HarrydeBug/WSPR-transmitters/Custom Firmwares/WSPR-TX0.79AltitudeCodingPico/2019-08-05 14.38.08.jpg

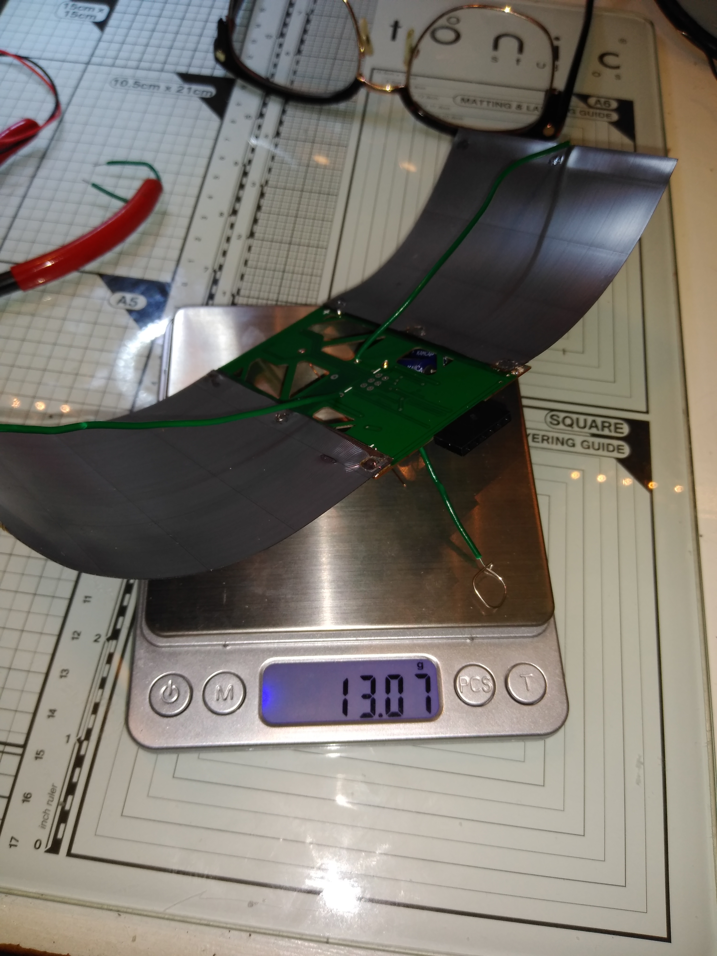
Custom Firmwares/WSPR-TX0.79AltitudeCodingPico/2019-08-05 14.38.08.jpg
