HarrydeBug/WSPR-transmitters/Custom Firmwares/WSPR-TX0.79AltitudeCodingPico/2019-08-10 16.04.37.jpg

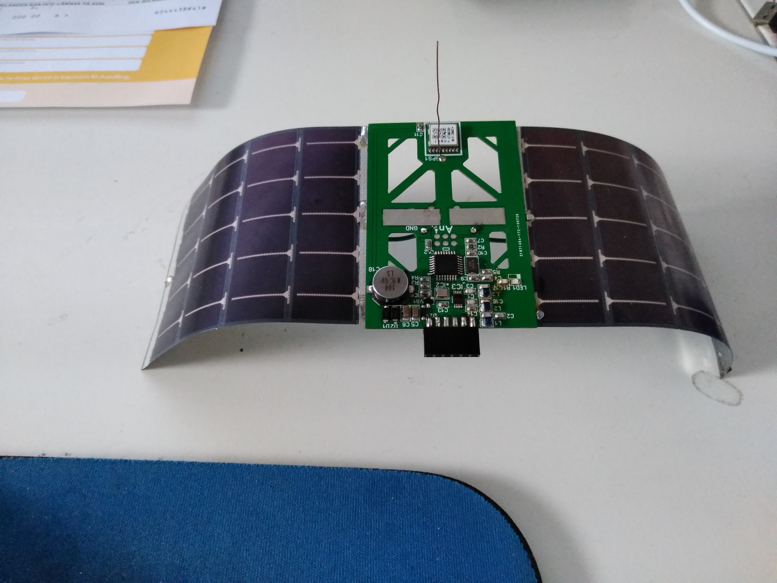
Custom Firmwares/WSPR-TX0.79AltitudeCodingPico/2019-08-10 16.04.37.jpg
