HarrydeBug/WSPR-transmitters/README.md

Arduino firmware, documentation and PC executable for my WSPR transmitters.
More info at www.zachtek.com

Firmware version 1:xx for WSPR transmitters with hardware version 1. These are ATMega328 based.   
Firmware version 2:xx for WSPR transmitters with hardware version 2. These are ESP8285 based.
