HarrydeBug/WSPR-transmitters/(threads)

Thread 4 (2023-12-21):

Version 1.15 ( ATMega 328) too big for uploading

GregorKocar, 2023-12-21:
I get this error when compiling 1.15 version for Arduino Pro Mini ATMega 328

Sketch uses 30144 bytes (210%) of program storage space. Maximum is 14336 bytes.
Global variables use 1211 bytes (118%) of dynamic memory, leaving -187 bytes for local variables. Maximum is 1024 bytes.

NeoGPS version 4.2.9

Closed 2023-12-21.
