HarrydeBug/WSPR-transmitters/Documentation/1012 Schema/Hardware Version 2/1012 Schema V2R35_80To10.pdf

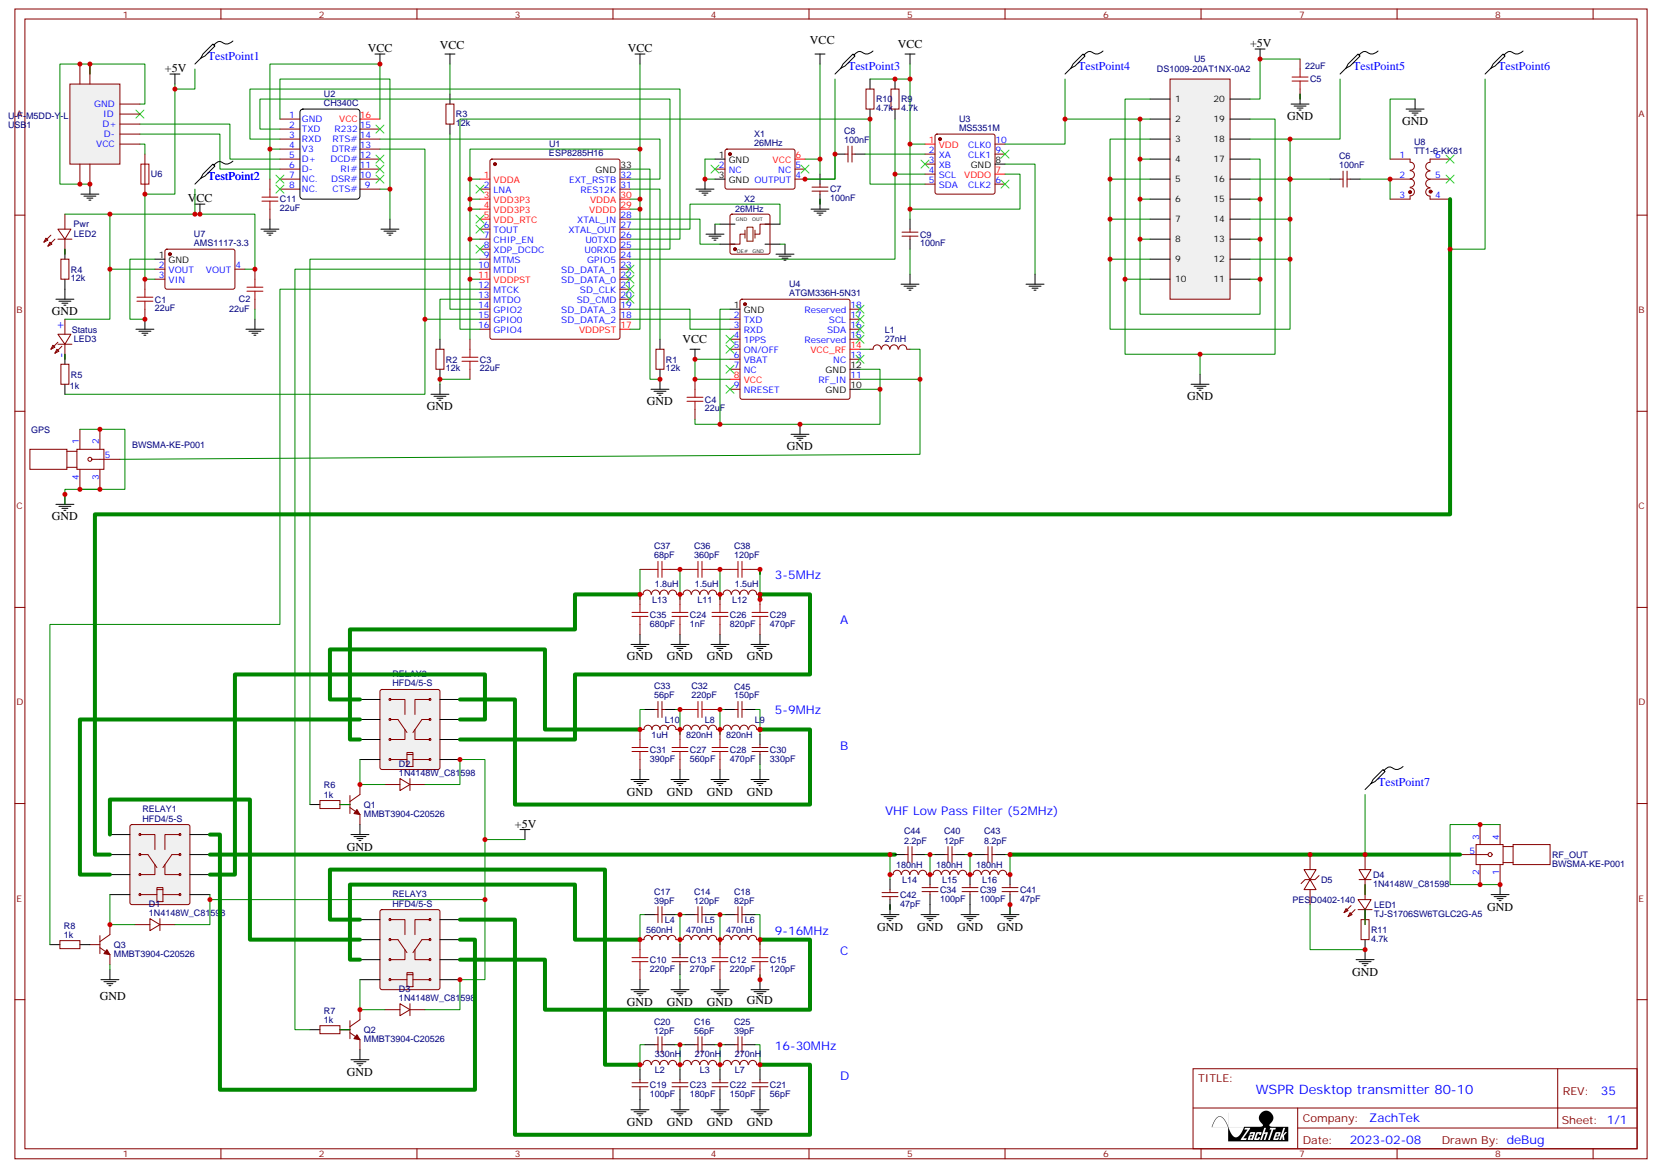
[picture p17: page 1]

GND GND

VHF Low Pass Filter (52MHz)
