HarrydeBug/WSPR-transmitters/Documentation/1012 Schema/Hardware Version 2/1012 Schema V2R38_2190To80.pdf

### VCC

VCC | VCC

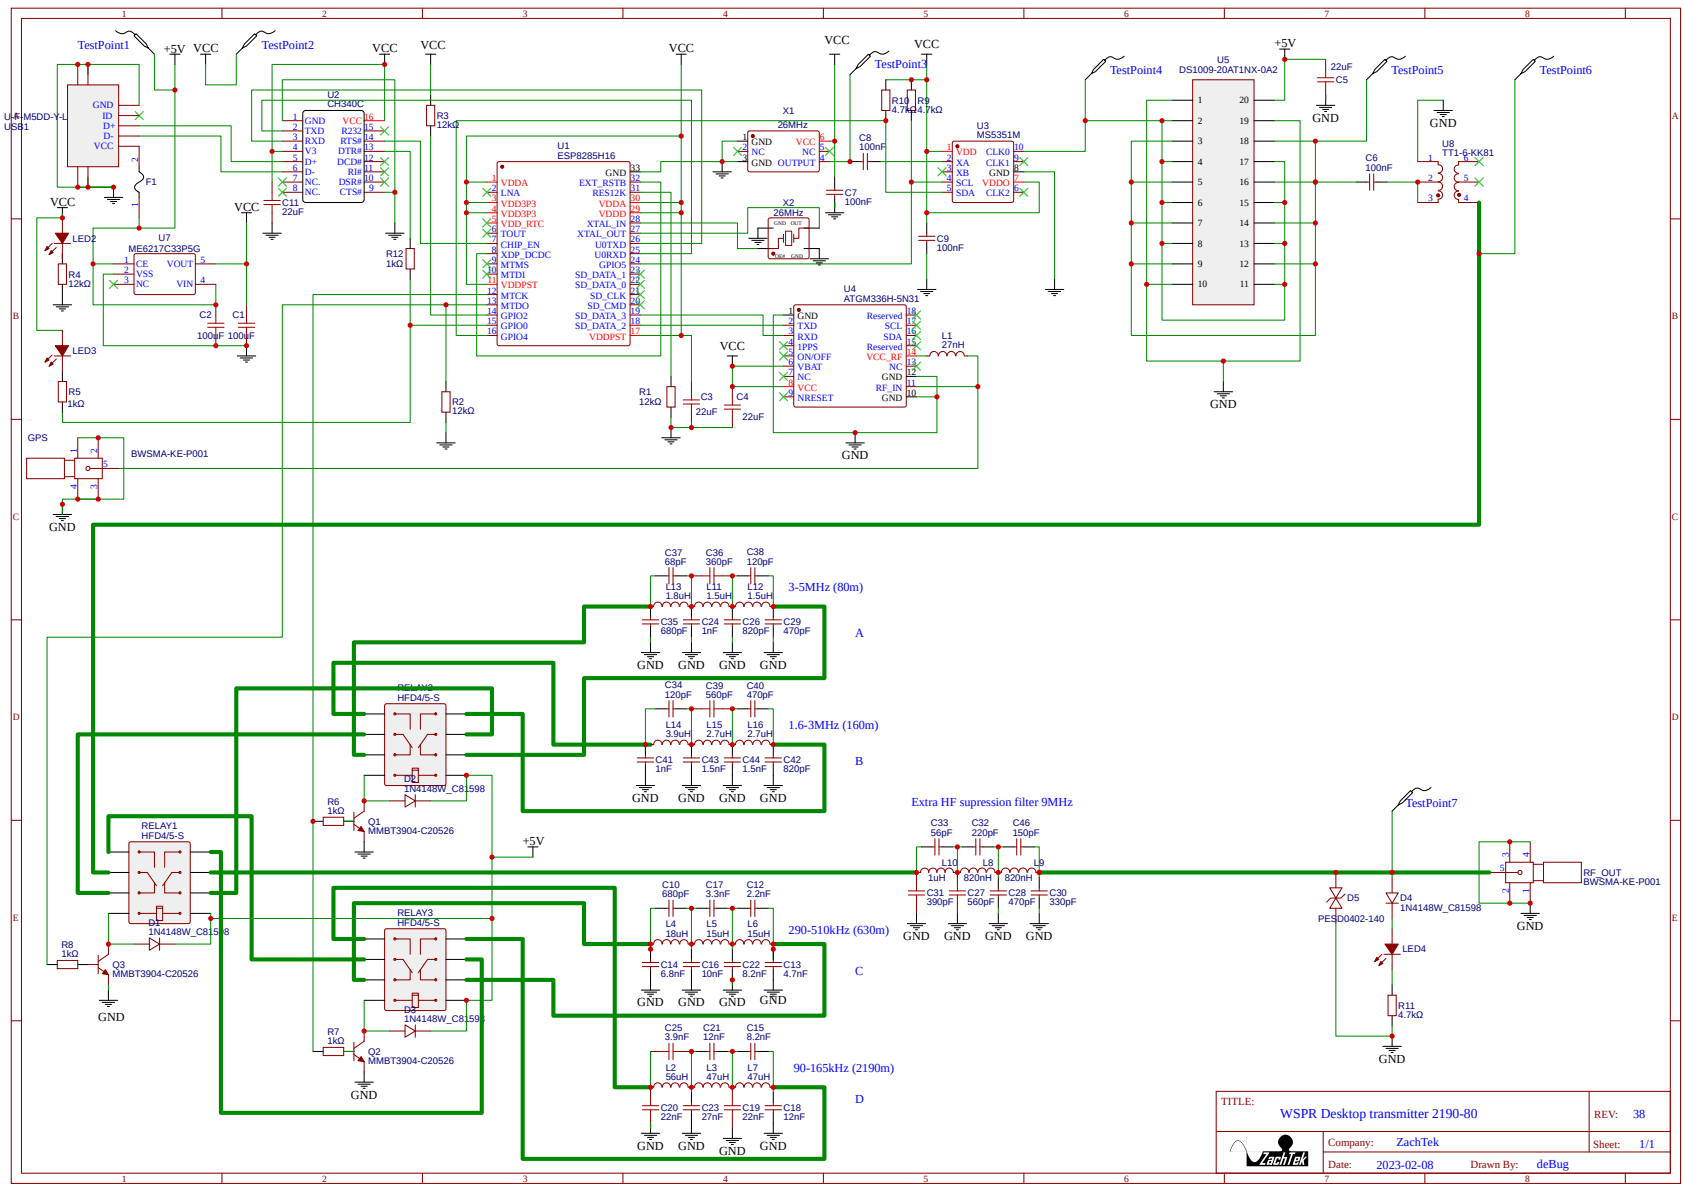
[picture p18: page 1]

GND GND

Extra HF supression filter 9MHz
