HarrydeBug/WSPR-transmitters/Documentation/1012 Schema/Hardware Version 2/1012 Schema V2R38_40To6.pdf

### VCC

VCC | VCC

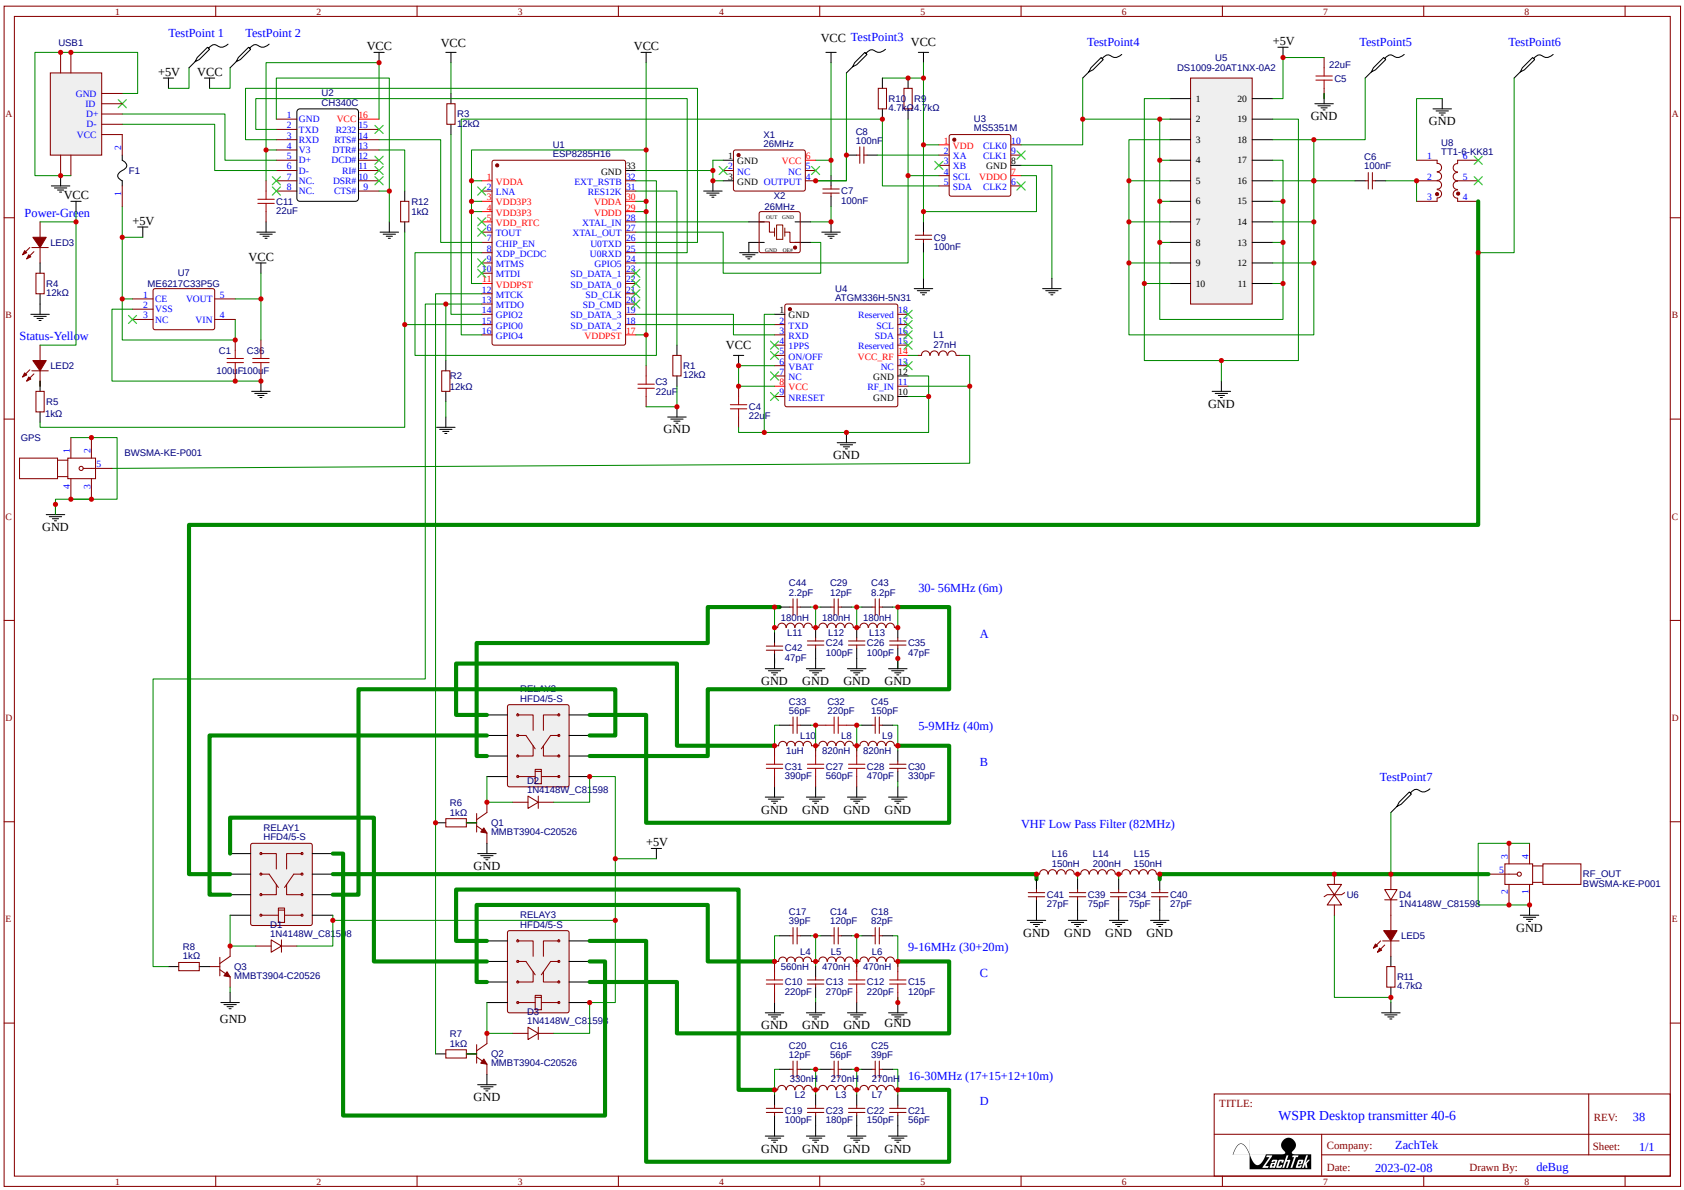
[picture p19: page 1]

GND GND

VHF Low Pass Filter (82MHz)
