HarrydeBug/WSPR-transmitters/Documentation/1011 Schema/1011 Schema V2R38.pdf

## Power-Green

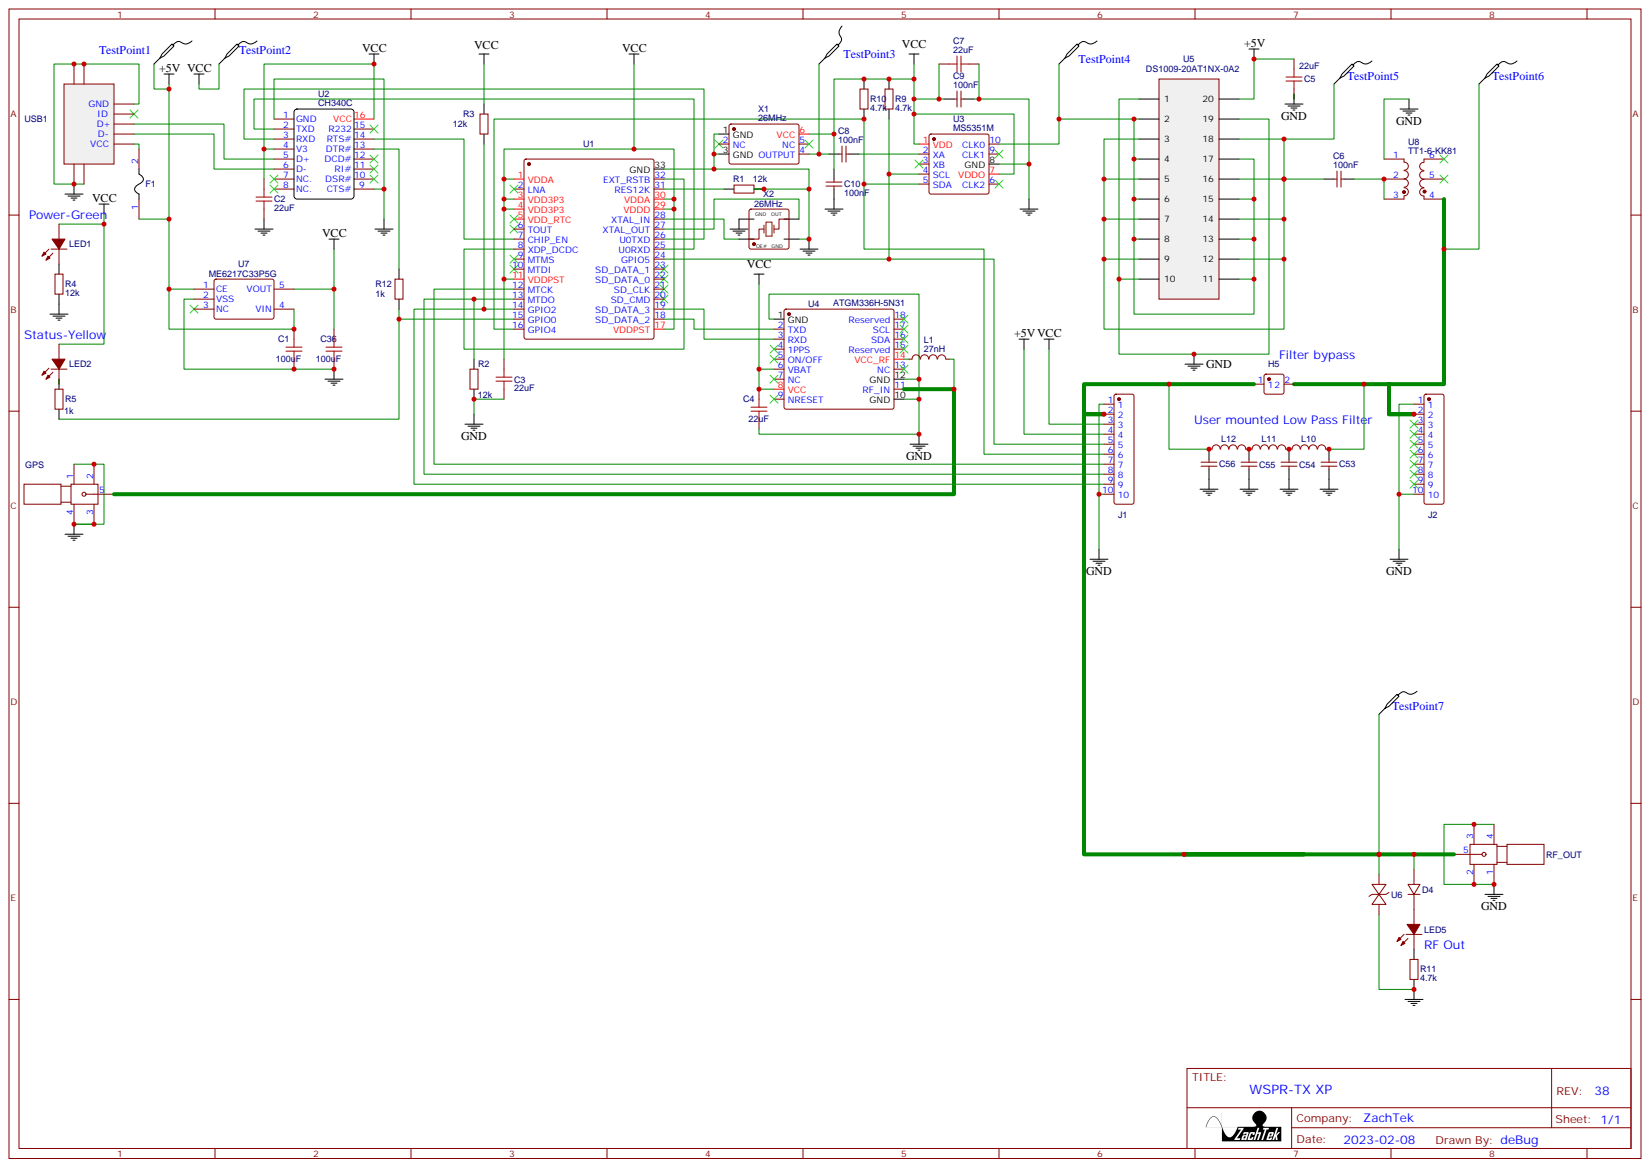
[picture p20: page 1]

User mounted Low Pass Filter
