HarrydeBug/WSPR-transmitters/Documentation/1010 Schema/1010 Schema V4R4 All bands.pdf

Tespoint1 5.0V | Testpoint2 3.3V | Testpoint3 Reference | Testpoint4 LOx4
6,94 | 72

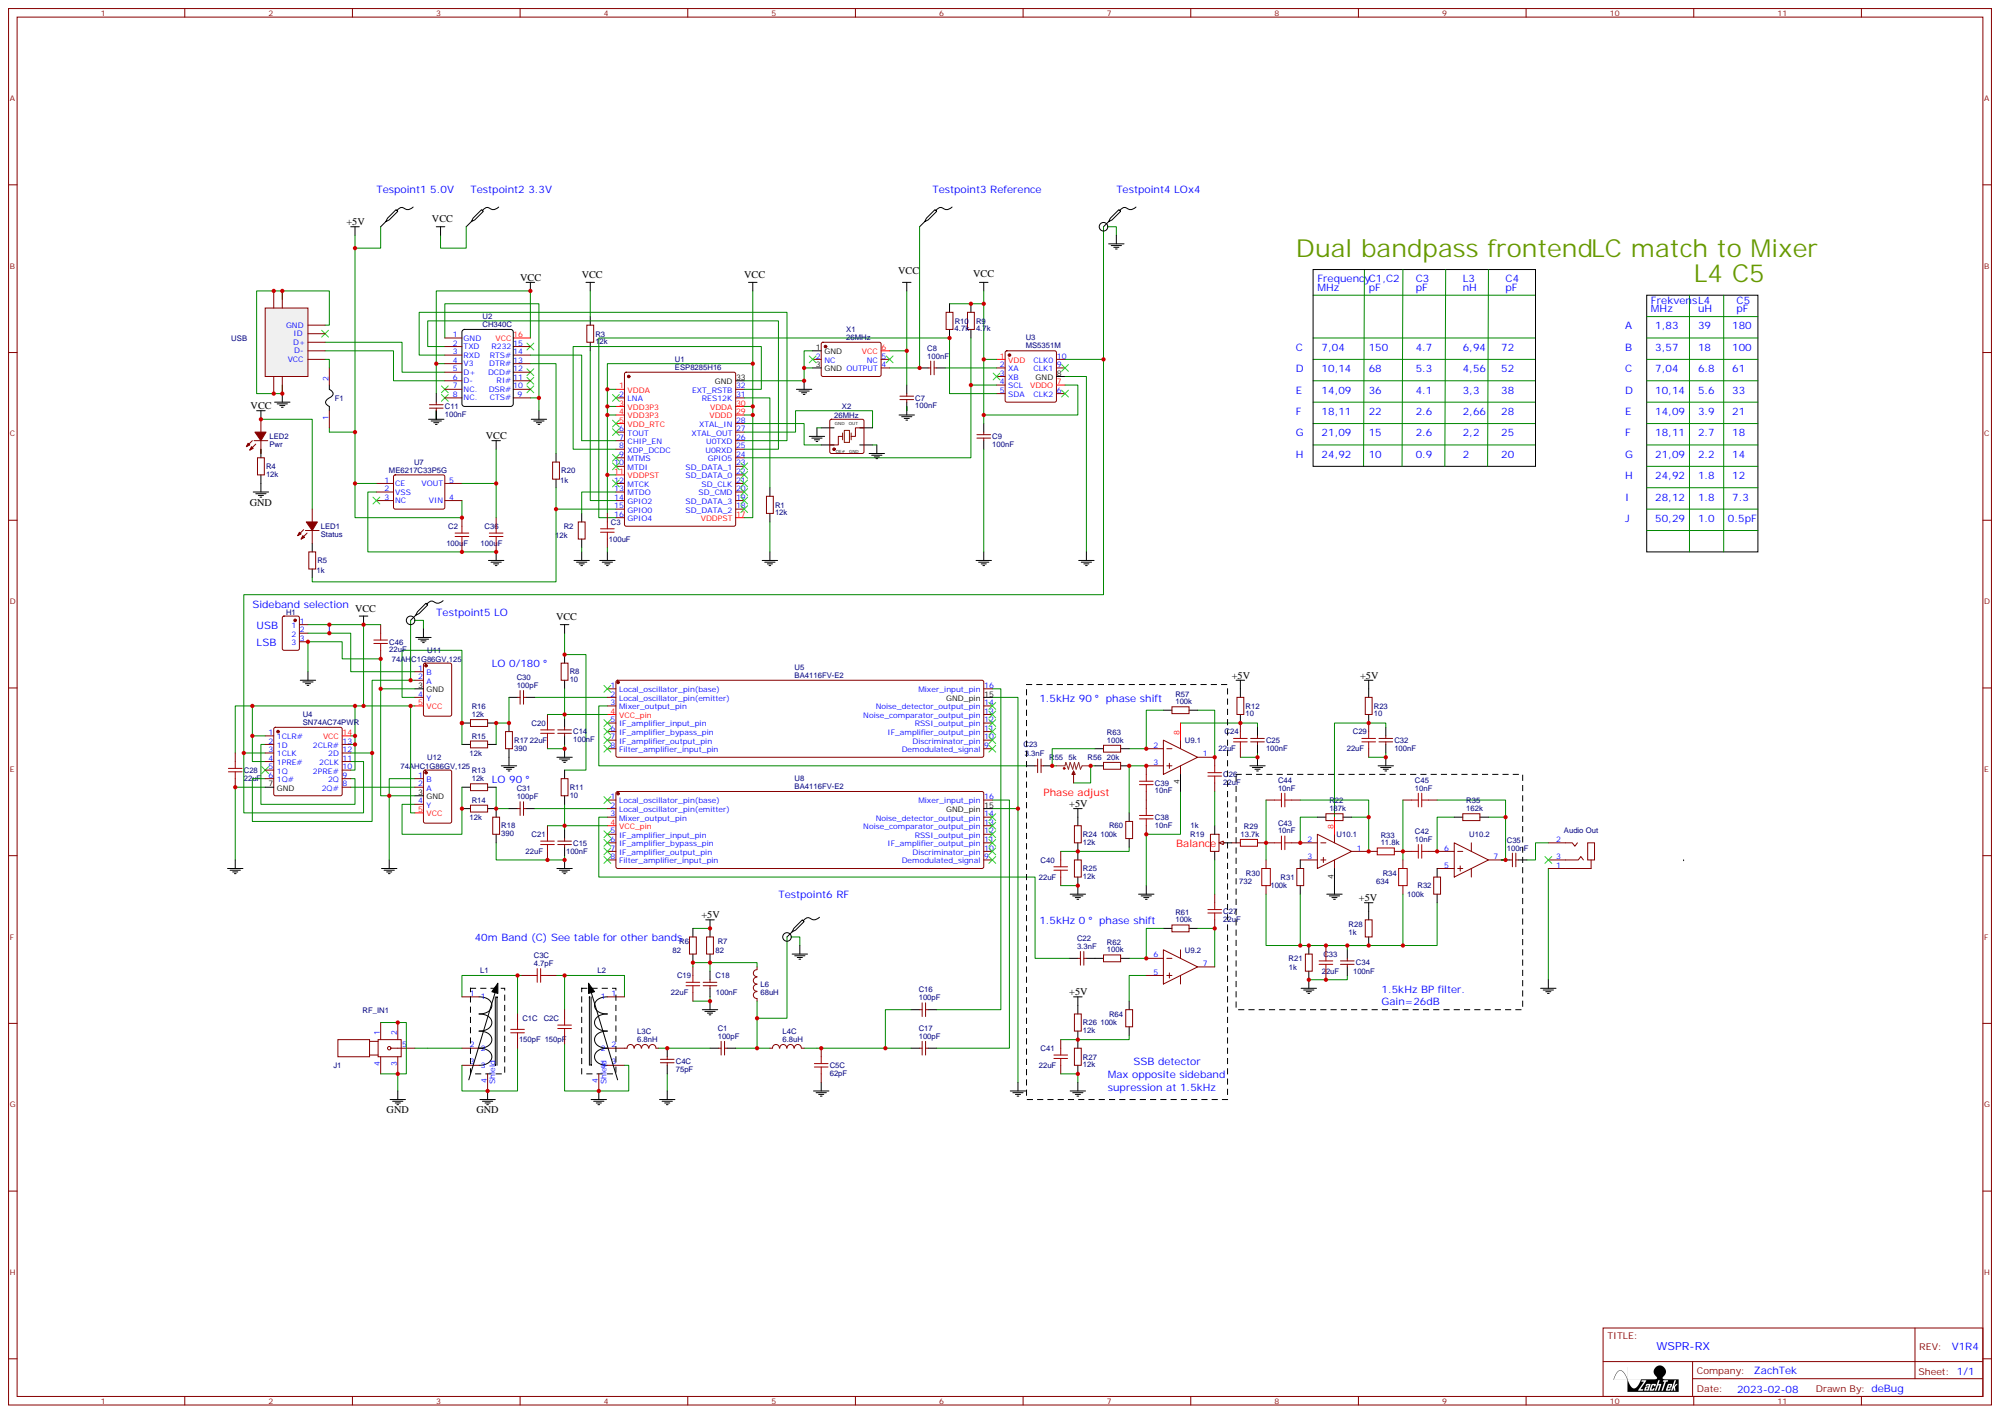
[picture p22: page 1]

LC match to Mixer

U2
GND 1 R3

40m Band (C) See table for other bands
