HarrydeBug/WSPR-transmitters/Documentation/1048 Schema/#1048 Schema V2R38.pdf

## Power-Green

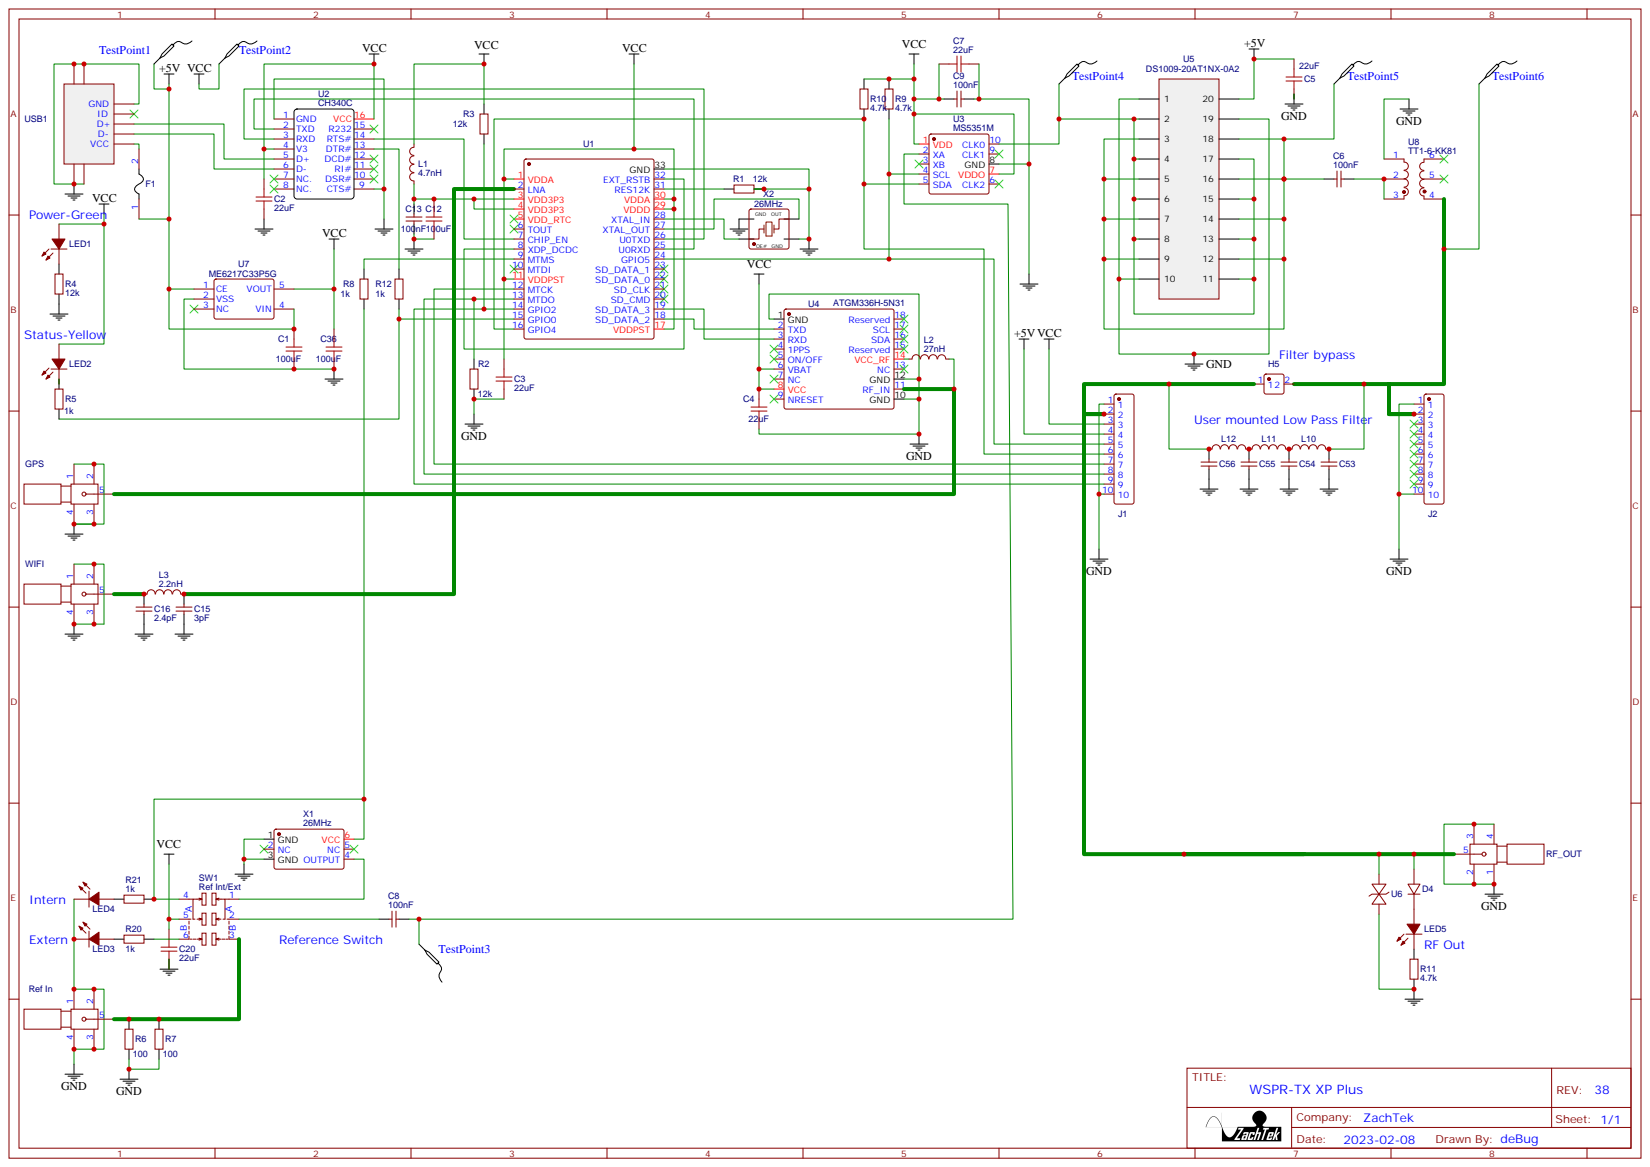
[picture p23: page 1]

User mounted Low Pass Filter
