HarrydeBug/WSPR-transmitters/Documentation/Serial API/1012 WSPR-TX_Desktop Serial API 0.65.pdf

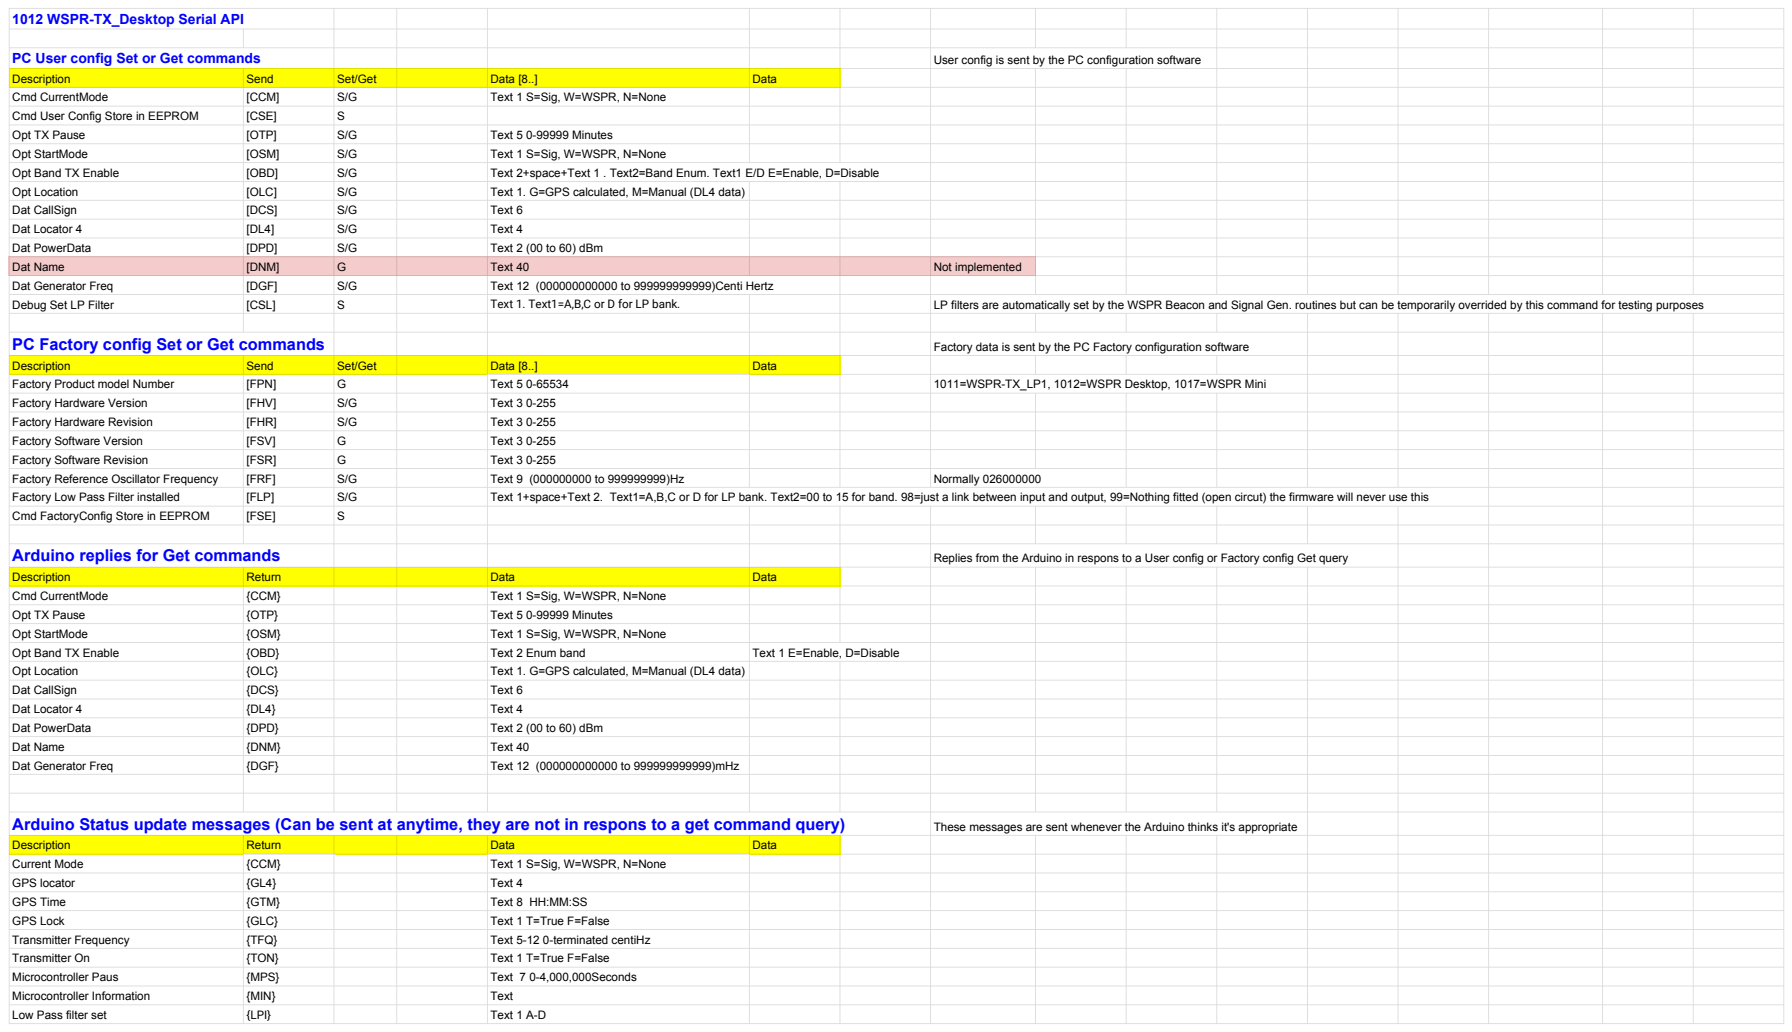
[picture p26: page 1]
Cmd CurrentMode; [CCM]; Text 1 S=Sig, W=WSPR, N=None; Cmd User Config Store in EEPROM; [CSE]; Opt TX Pause; [OTP]; Text 5 0-99999 Minutes; Opt StartMode; [OSM]; Opt Band TX Enable; [OBD]; Text 2+space+Text 1 . Text2=Band Enum. Text1 E/D E=Enable, D=Disable; Opt Location; [OLC]; Text 1. G=GPS calculated, M=Manual (DL4 data); Dat CallSign; [DCS]; Text 6; Dat Locator 4; Text 4; Dat PowerData; [DPD]; Text 2 (00 to 60) dBm; Dat Name; [DNM]; Text 40; Not implemented; Dat Generator Freq; [DGF]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

1012 WSPR-TX_Desktop Serial API PC User config Set or Get commands | User config is sent by the PC configuration software

Description Send Set/Get Data [8..] Data

Factory Product model Number [FPN] G Factory Hardware Version [FHV] S/G Factory Hardware Revision [FHR] S/G | Text 5 0-65534 Text 3 0-255 Text 3 0-255 | 1011=WSPR-TX_LP1, 1012=WSPR Desktop, 1017=WSPR Mini

Factory Software Version [FSV] G Factory Software Revision [FSR] G | | Text 3 0-255

Arduino replies for Get commands | Replies from the Arduino in respons to a User config or Factory config Get query

Description Return Data Data

Arduino Status update messages (Can be sent at anytime, they are not in respons to a get command query) | These messages are sent whenever the Arduino thinks it's appropriate
