HarrydeBug/WSPR-transmitters/Documentation/Serial API/1012 WSPR-TX_Desktop Serial API 0.82.pdf

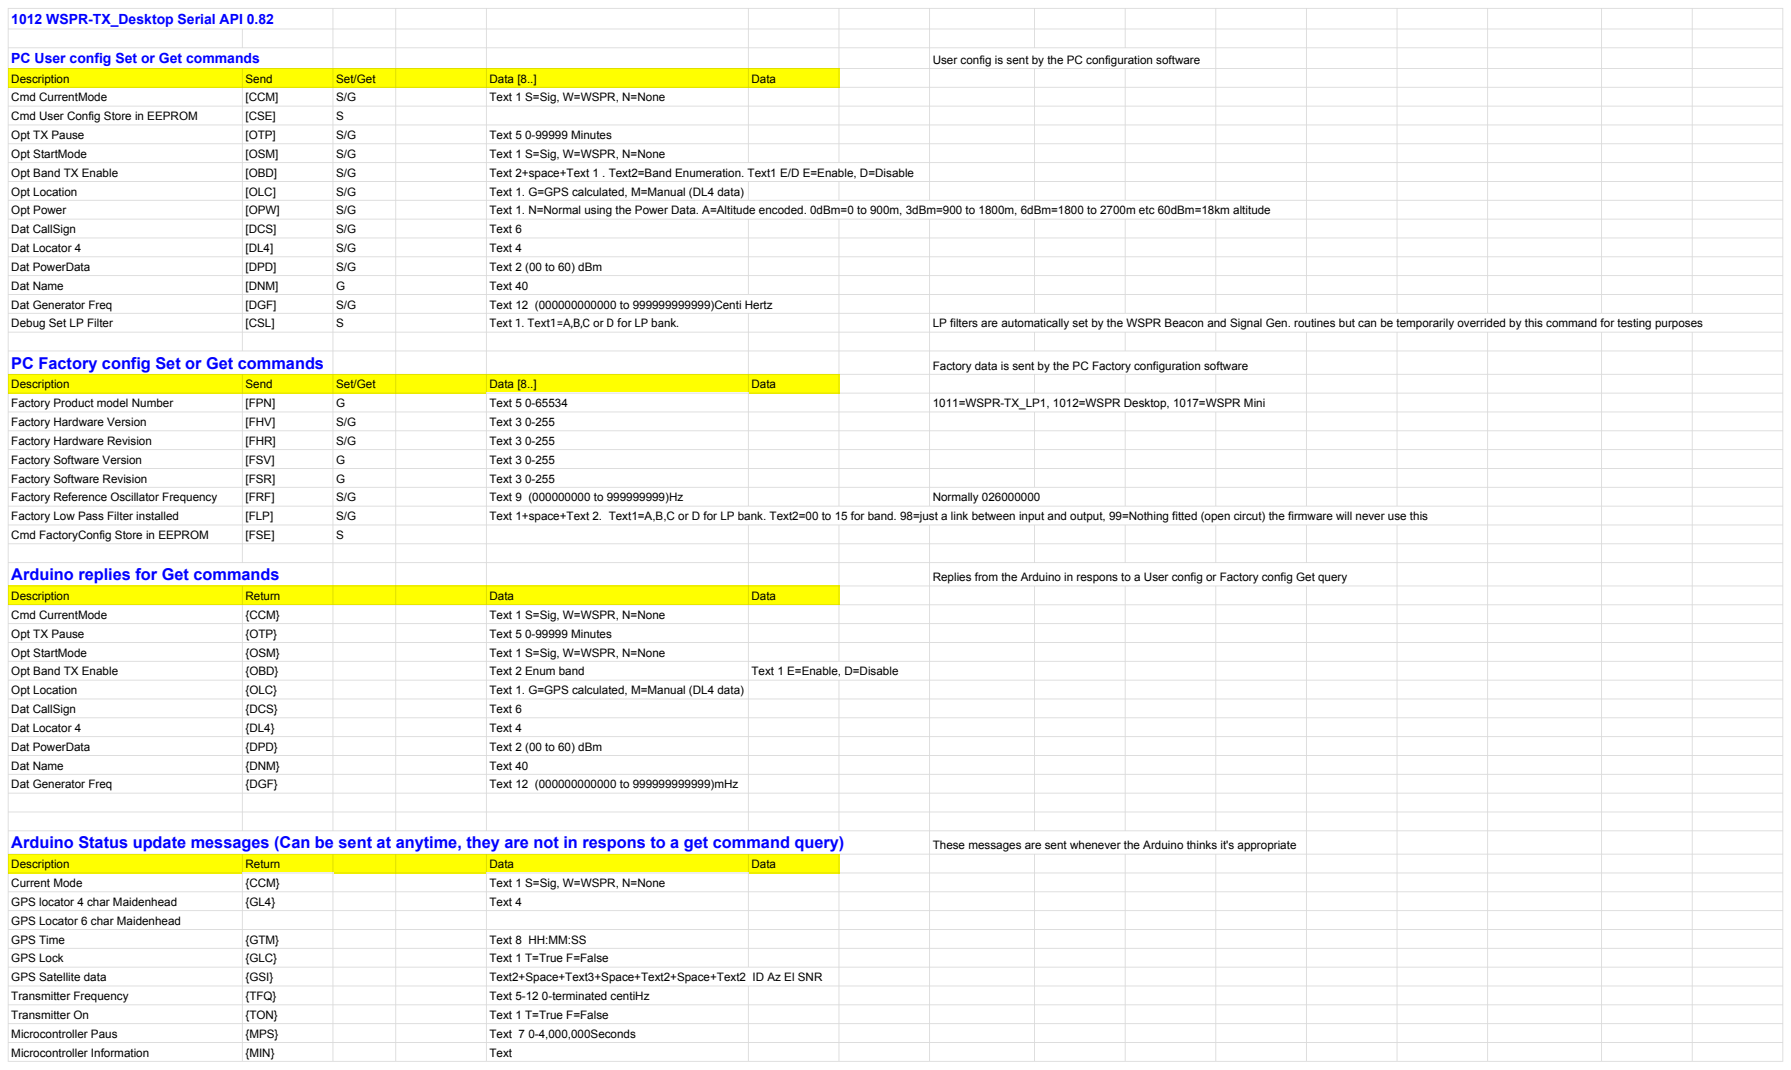
[picture p27: page 1]
Cmd CurrentMode; [CCM]; Text 1 S=Sig, W=WSPR, N=None; Cmd User Config Store in EEPROM; [CSE]; Opt TX Pause; [OTP]; Text 5 0-99999 Minutes; Opt StartMode; [OSM]; Opt Band TX Enable; [OBD]; Text 2+space+Text 1 . Text2=Band Enumeration. Text1 E/D E=Enable, D=Disable; Opt Location; [OLC]; Text 1. G=GPS calculated, M=Manual (DL4 data); Opt Power; [OPW]; Text 1. N=Normal using the Power Data. A=Altitude encoded. 0dBm=0 to 900m, 3dBm=900 to 1800m, 6dBm=1800 to 2700m etc 60dBm=18km altitude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

1012 WSPR-TX_Desktop Serial API 0.82 PC User config Set or Get commands | User config is sent by the PC configuration software

Description Send Set/Get Data [8..] Data

Factory Product model Number [FPN] G Factory Hardware Version [FHV] S/G Factory Hardware Revision [FHR] S/G | Text 5 0-65534 Text 3 0-255 Text 3 0-255 | 1011=WSPR-TX_LP1, 1012=WSPR Desktop, 1017=WSPR Mini

Factory Software Version [FSV] G Factory Software Revision [FSR] G | | Text 3 0-255

Arduino replies for Get commands | Replies from the Arduino in respons to a User config or Factory config Get query

Description Return Data Data

Arduino Status update messages (Can be sent at anytime, they are not in respons to a get command query) | These messages are sent whenever the Arduino thinks it's appropriate

GPS Locator 6 char Maidenhead

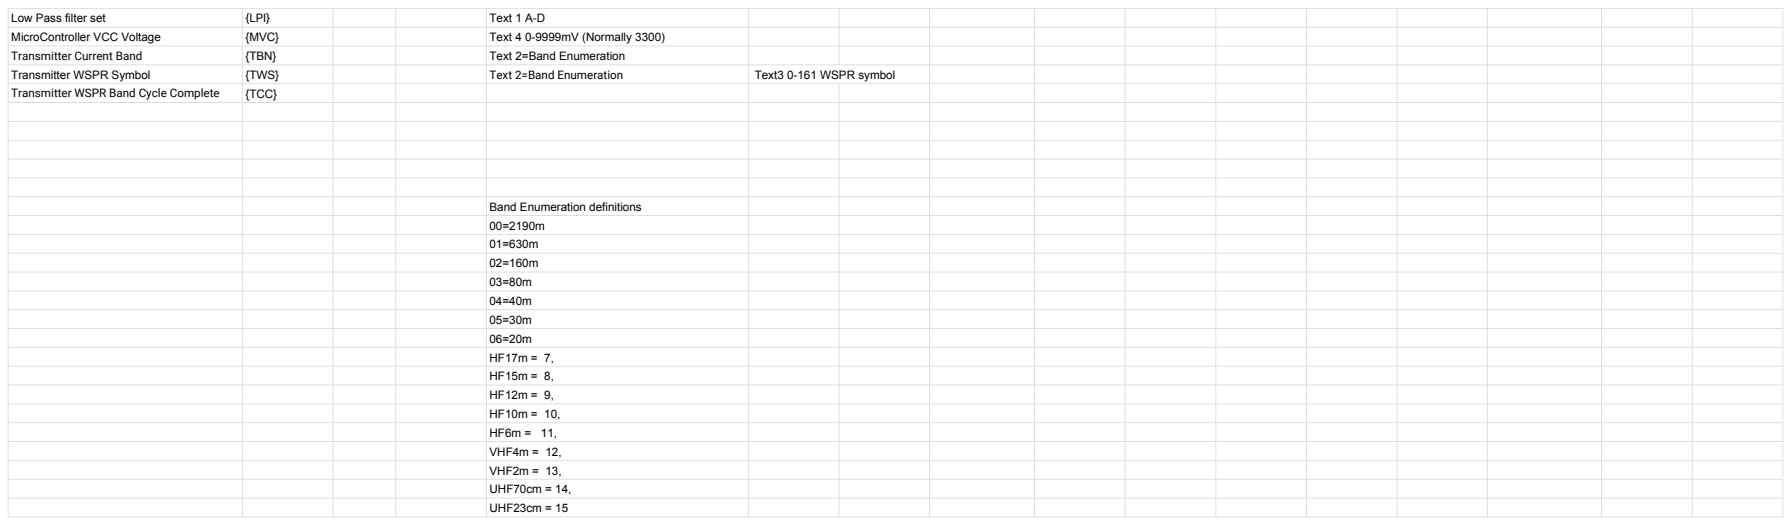
[picture p28: page 2]
Low Pass filter set; {LPI}; Text 1 A-D; MicroController VCC Voltage; {MVC}; Text 4 0-9999mV (Normally 3300); Band Enumeration definitions; VHF4m = 12,; VHF2m = 13,; UHF70cm = 14,; UHF23cm = 15

Transmitter Current Band | {TBN} Text 2=Band Enumeration
Transmitter WSPR Symbol | {TWS} | Text 2=Band Enumeration | Text3 0-161 WSPR symbol
Transmitter WSPR Band Cycle Complete | {TCC}
