HarrydeBug/WSPR-transmitters/Documentation/1012 Schema/Hardware Version 2/1012 Schema V2R38_80To10.pdf

### VCC

### VCC

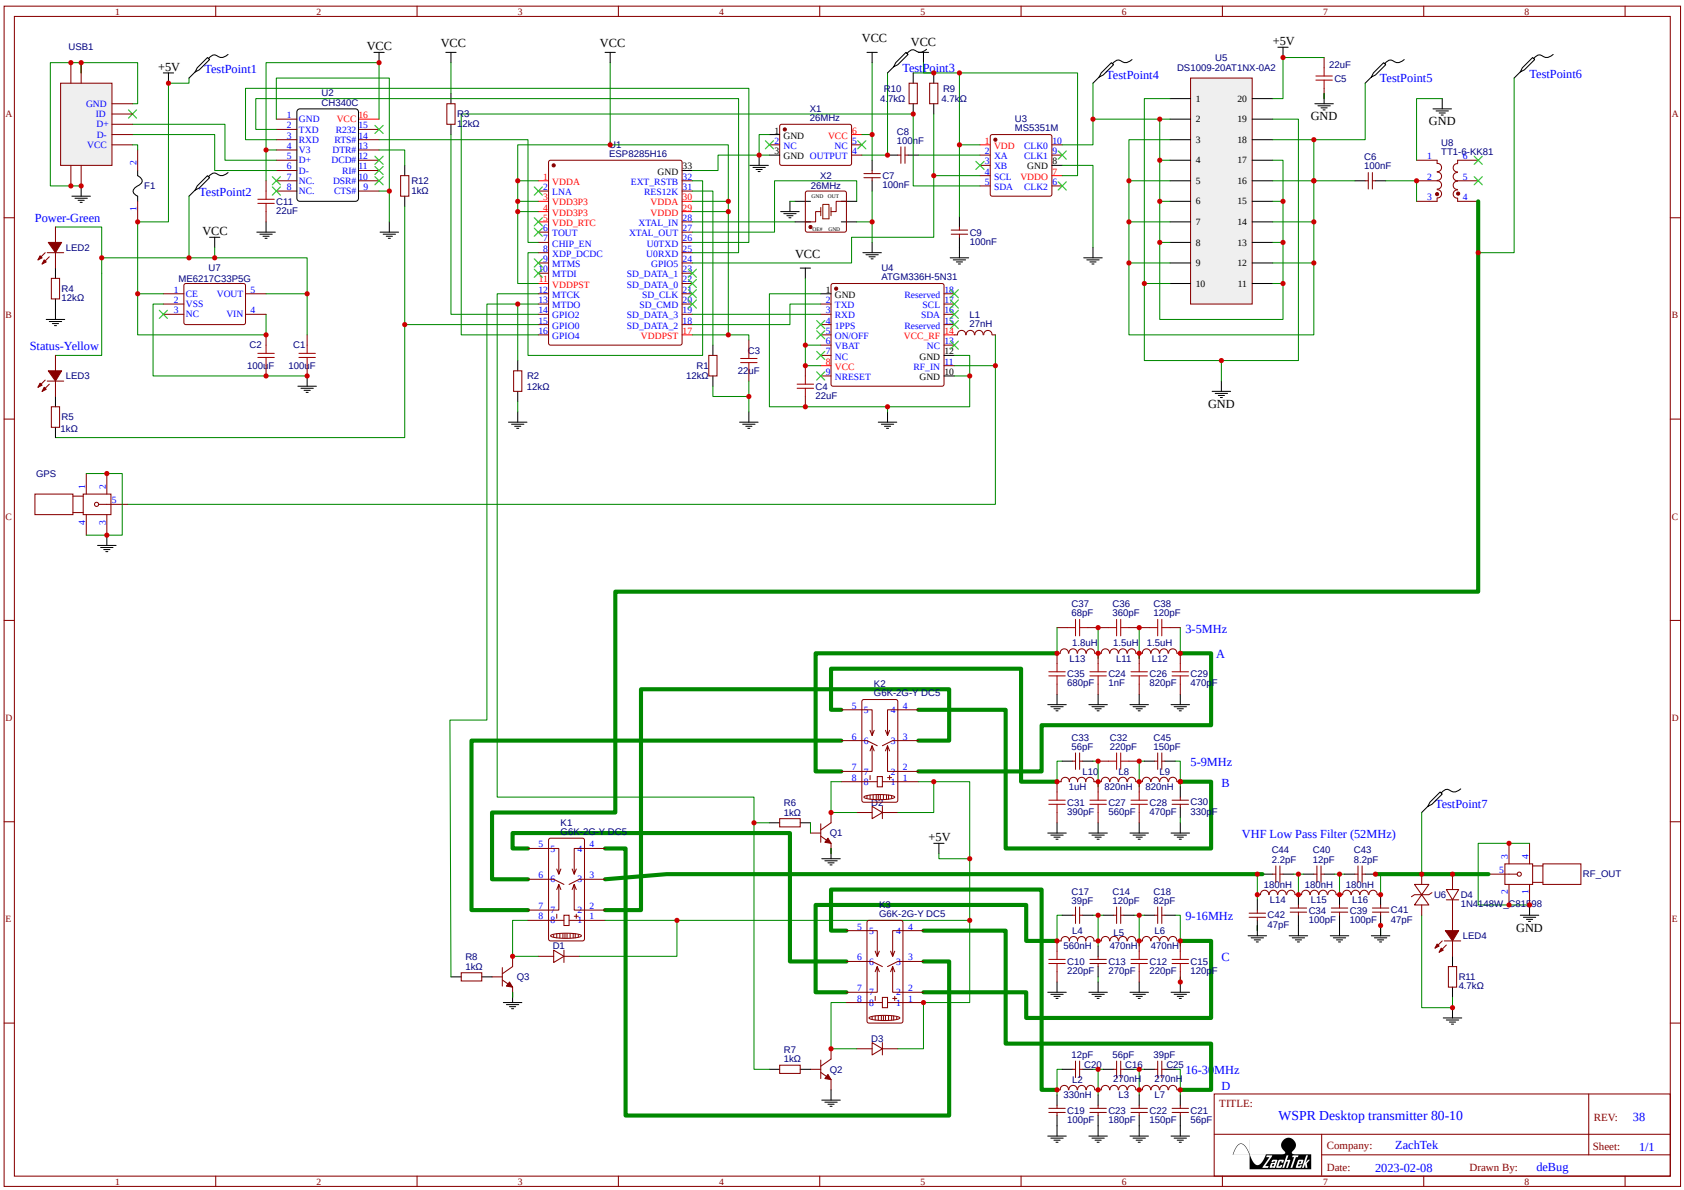
[picture p29: page 1]
