HarrydeBug/WSPR-transmitters/Documentation/1012 Schema/Hardware Version 2/1012 Schema V2R1.pdf

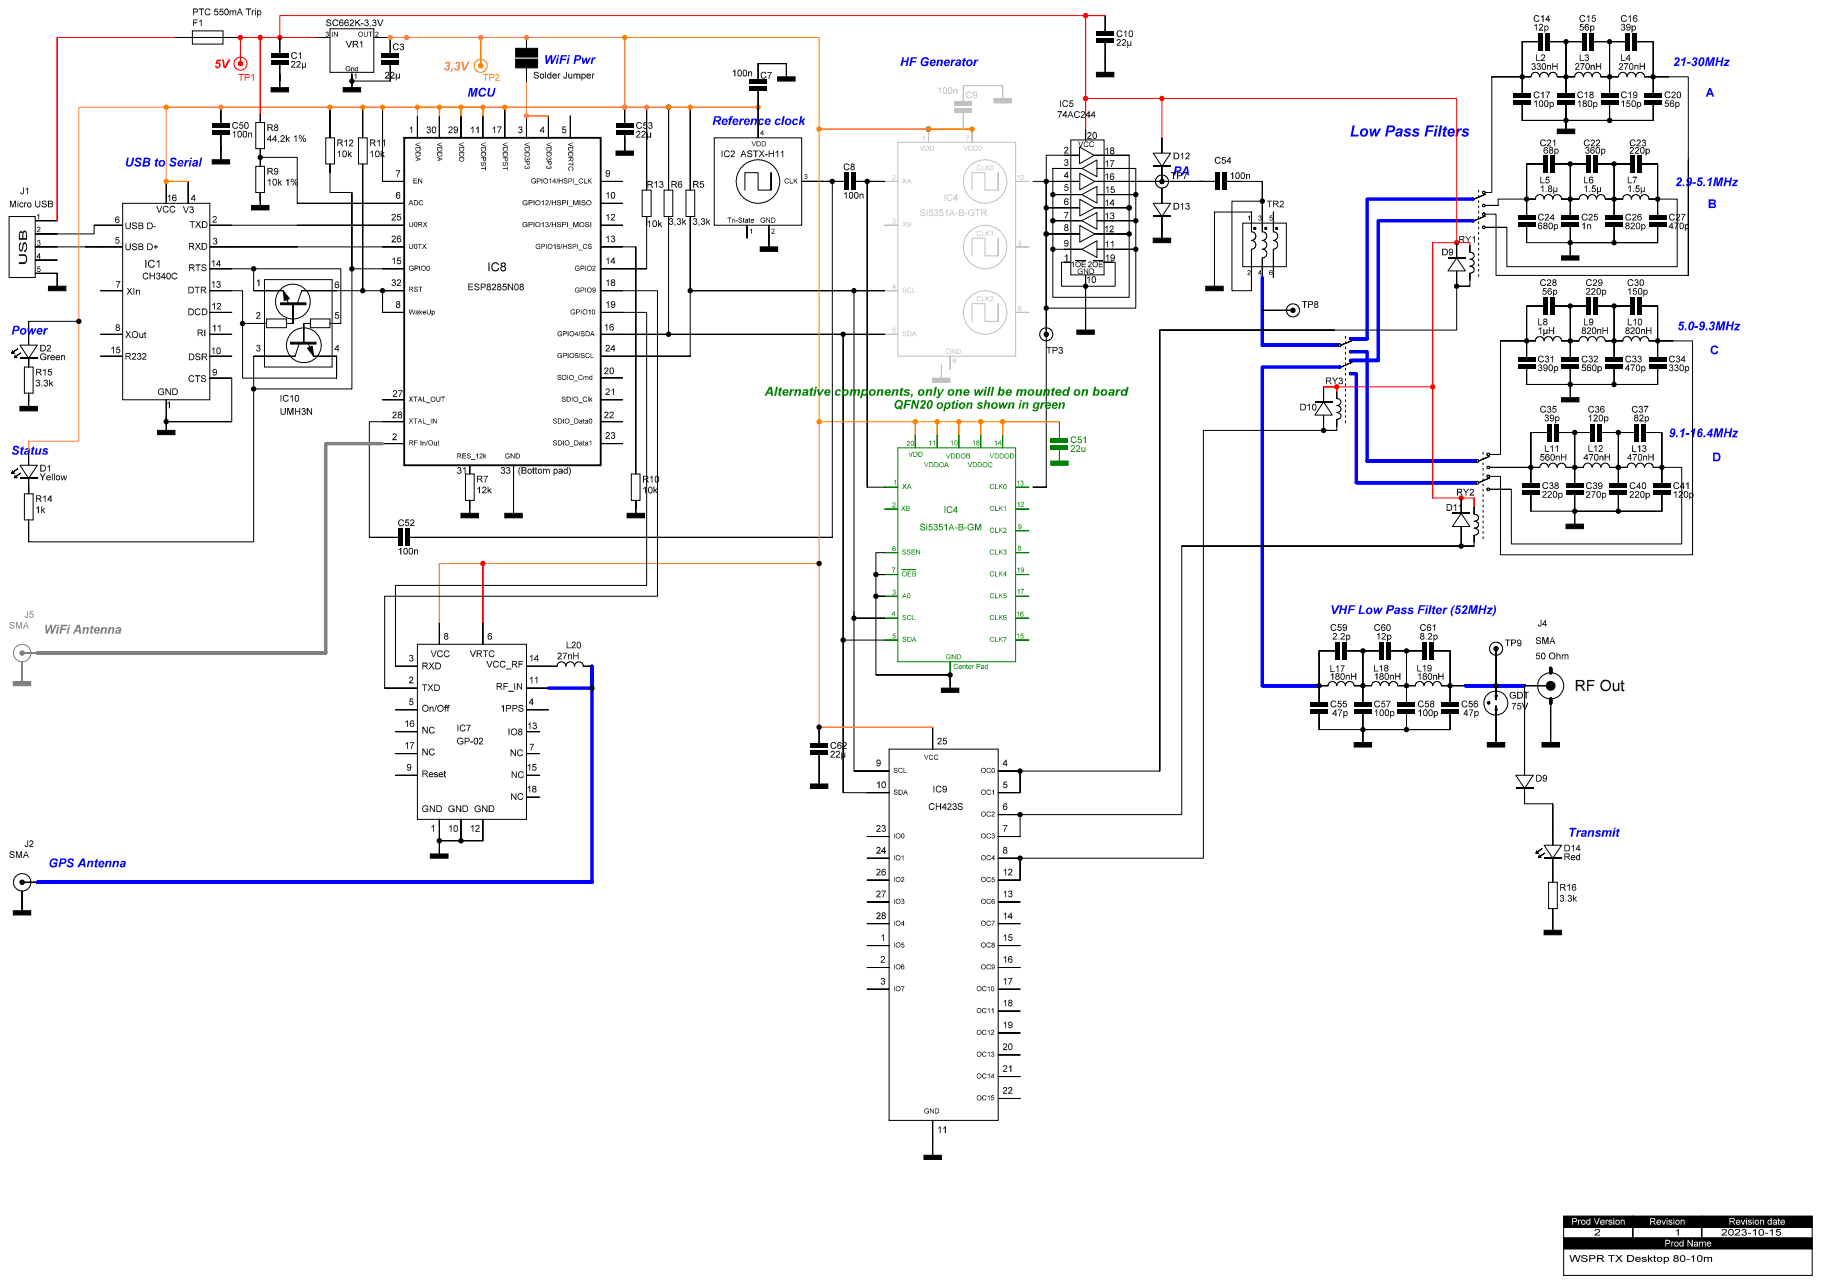
[picture p30: page 1]
