HarrydeBug/WSPR-transmitters/Documentation/1011 Schema/1011 Schema V1R13.pdf

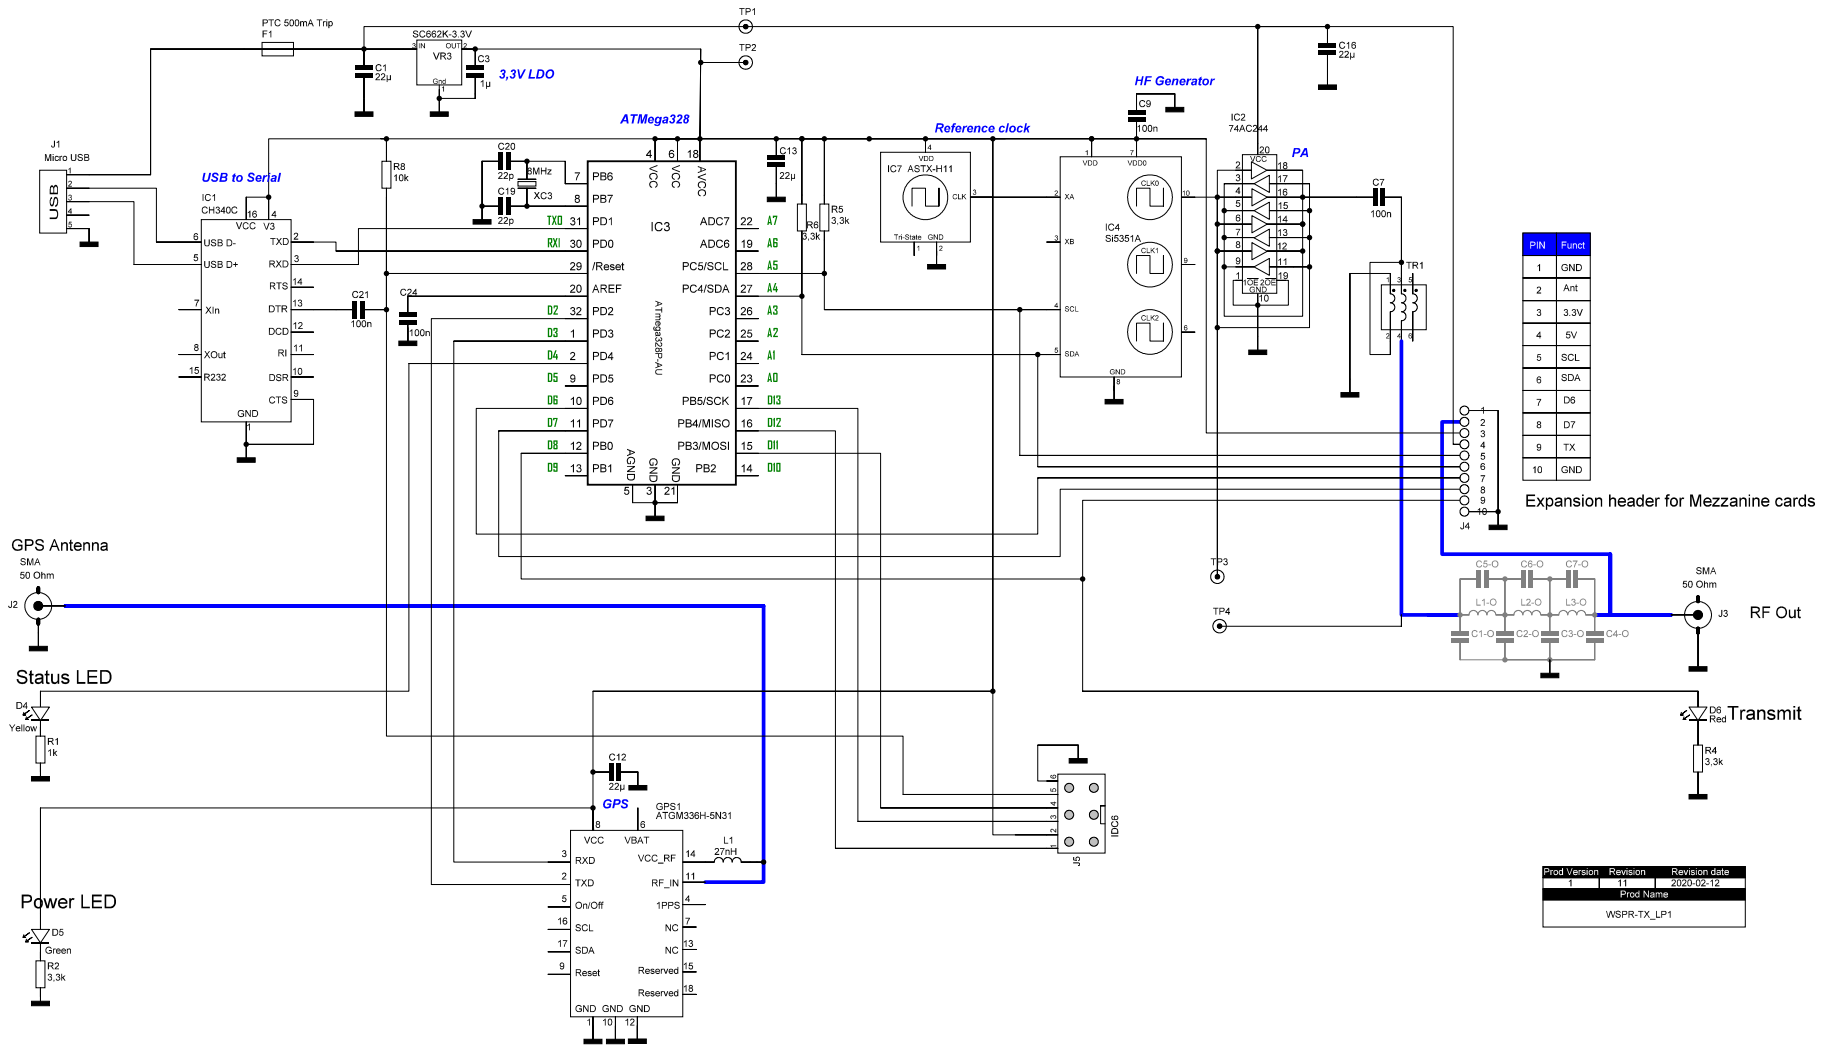
[picture p36: page 1]
