HarrydeBug/WSPR-transmitters/Documentation/1011 Schema/1011 Schema V1R17.pdf

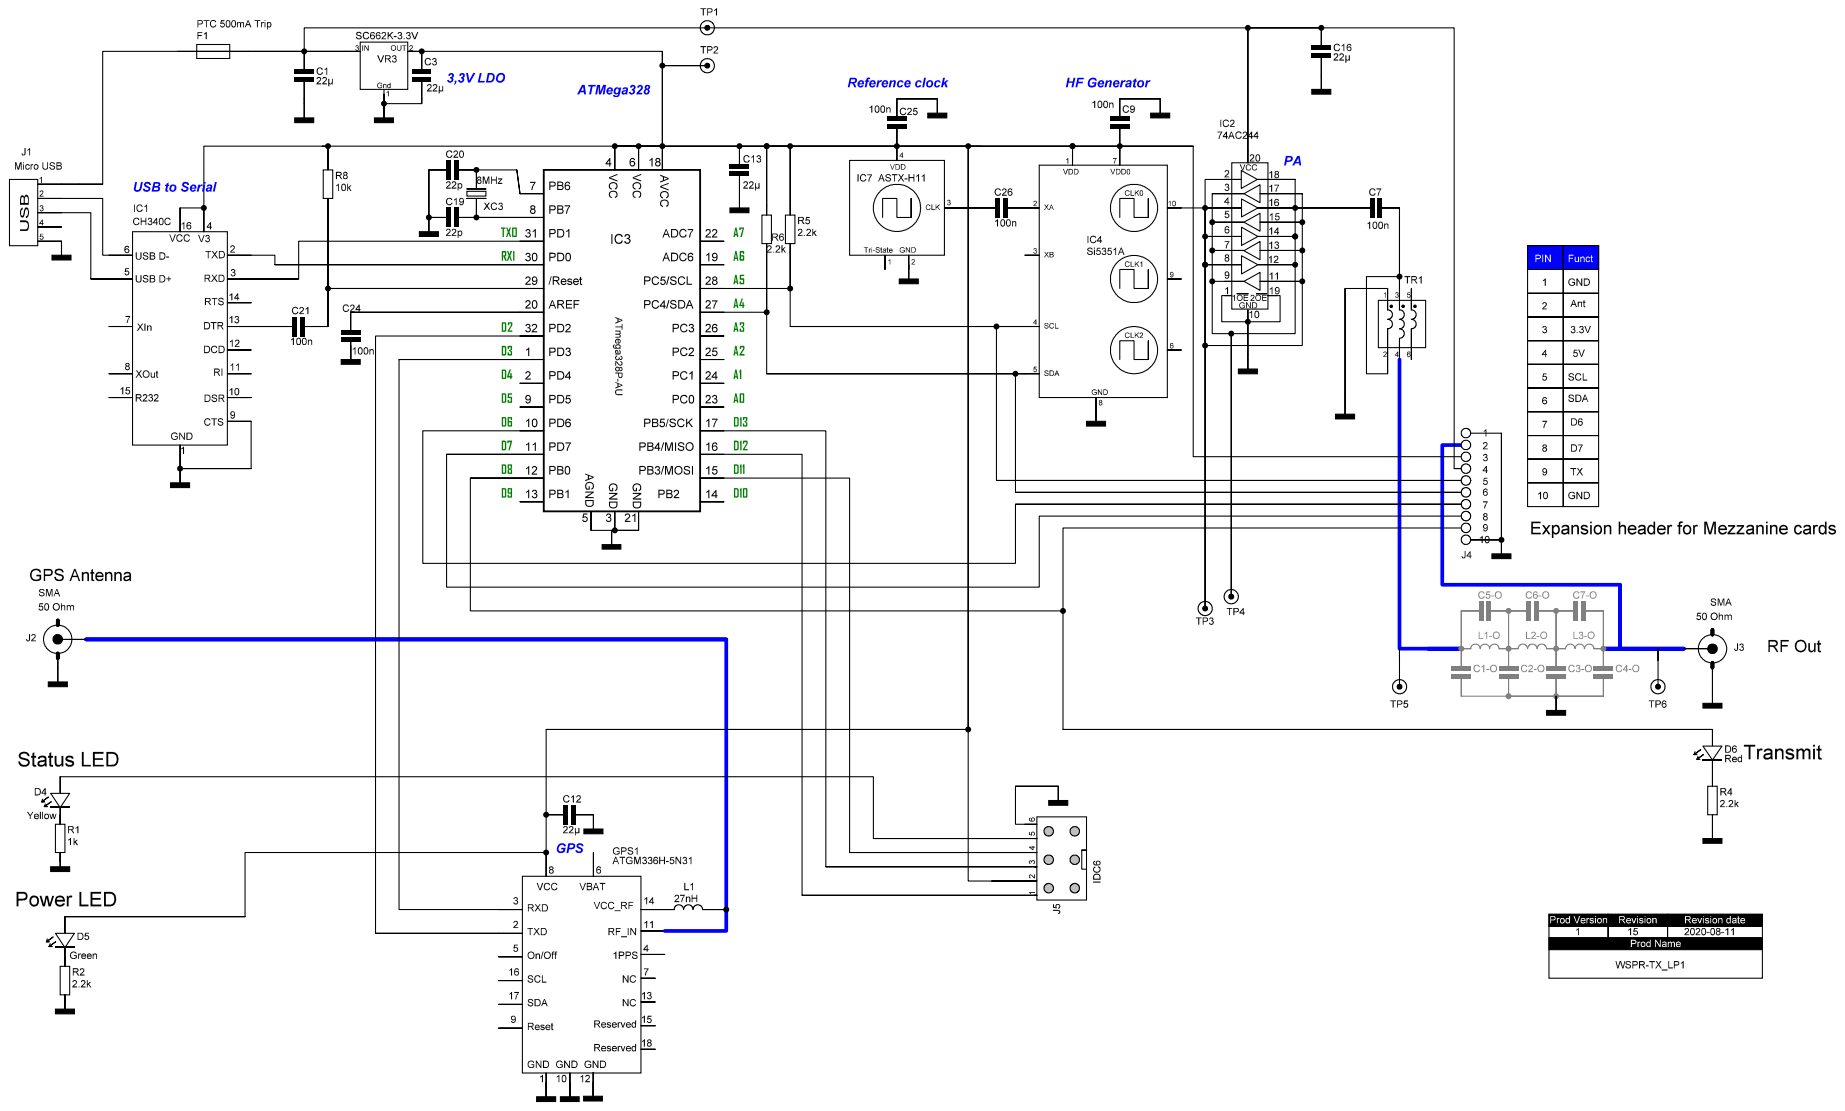
[picture p37: page 1]
