HarrydeBug/WSPR-transmitters/Documentation/1011 Schema/1011 Schema V1R5.pdf

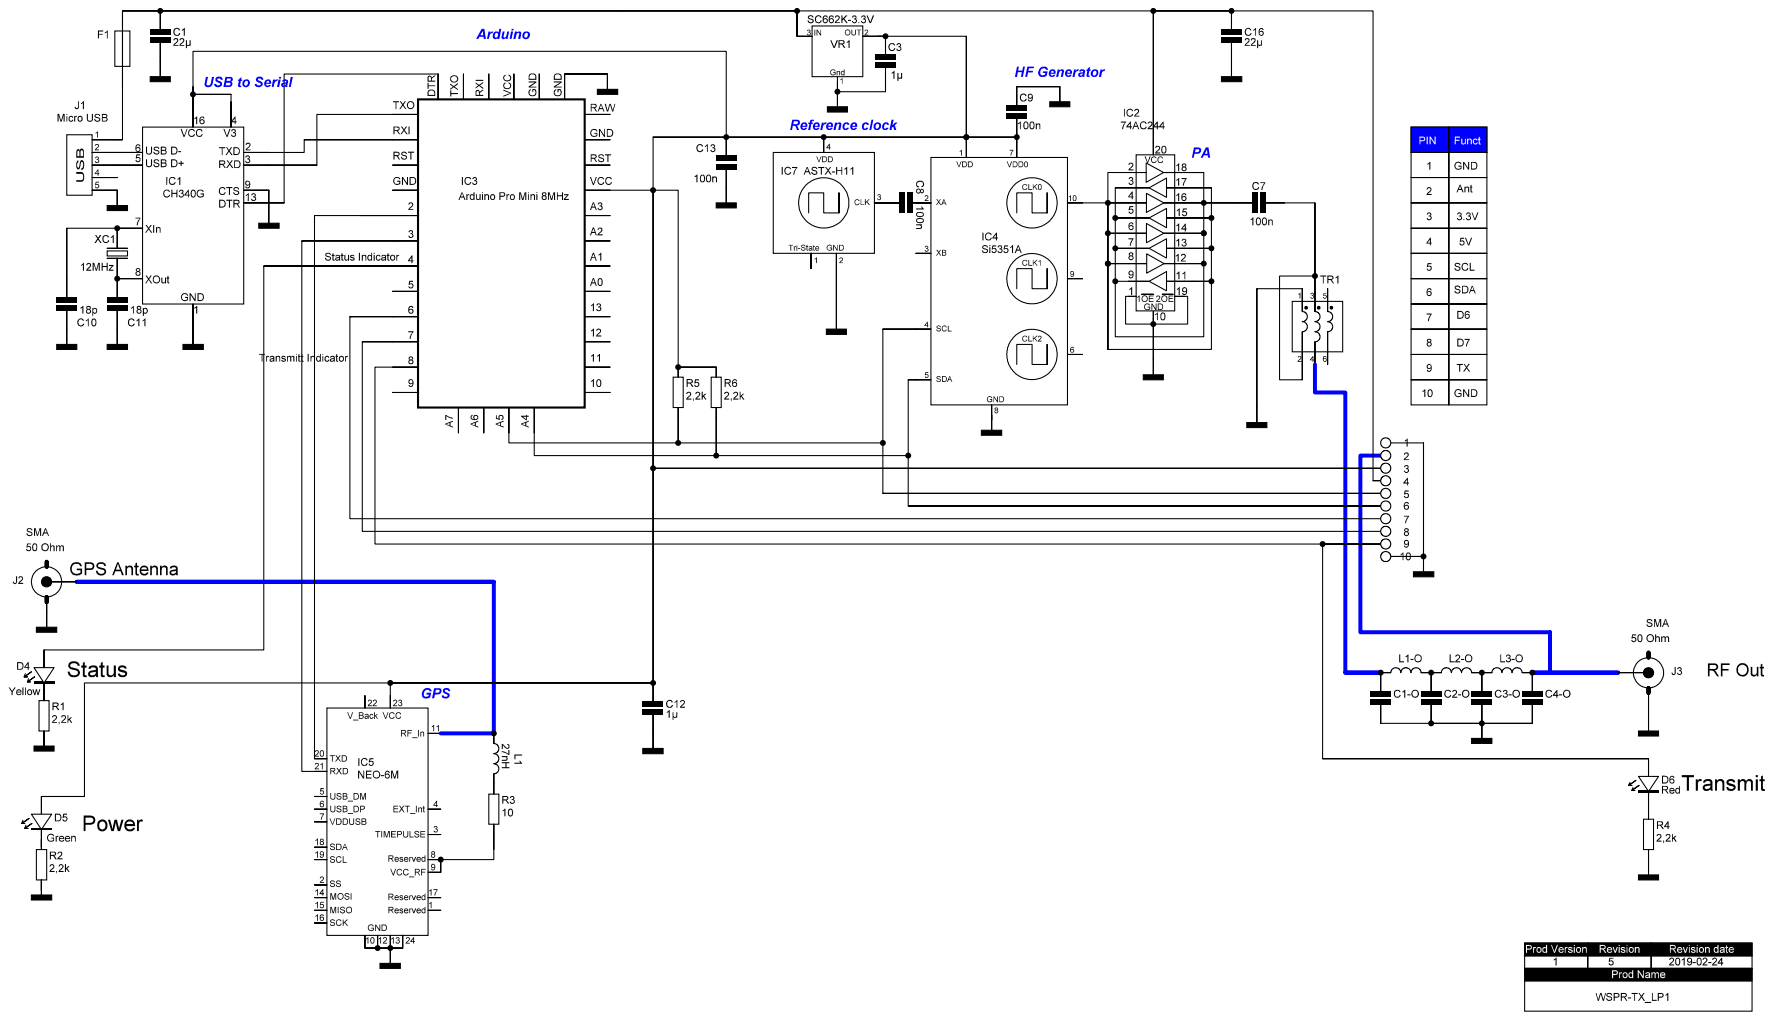
[picture p38: page 1]
