HarrydeBug/WSPR-transmitters/Documentation/1011 Schema/1011 Schema V2R5.pdf

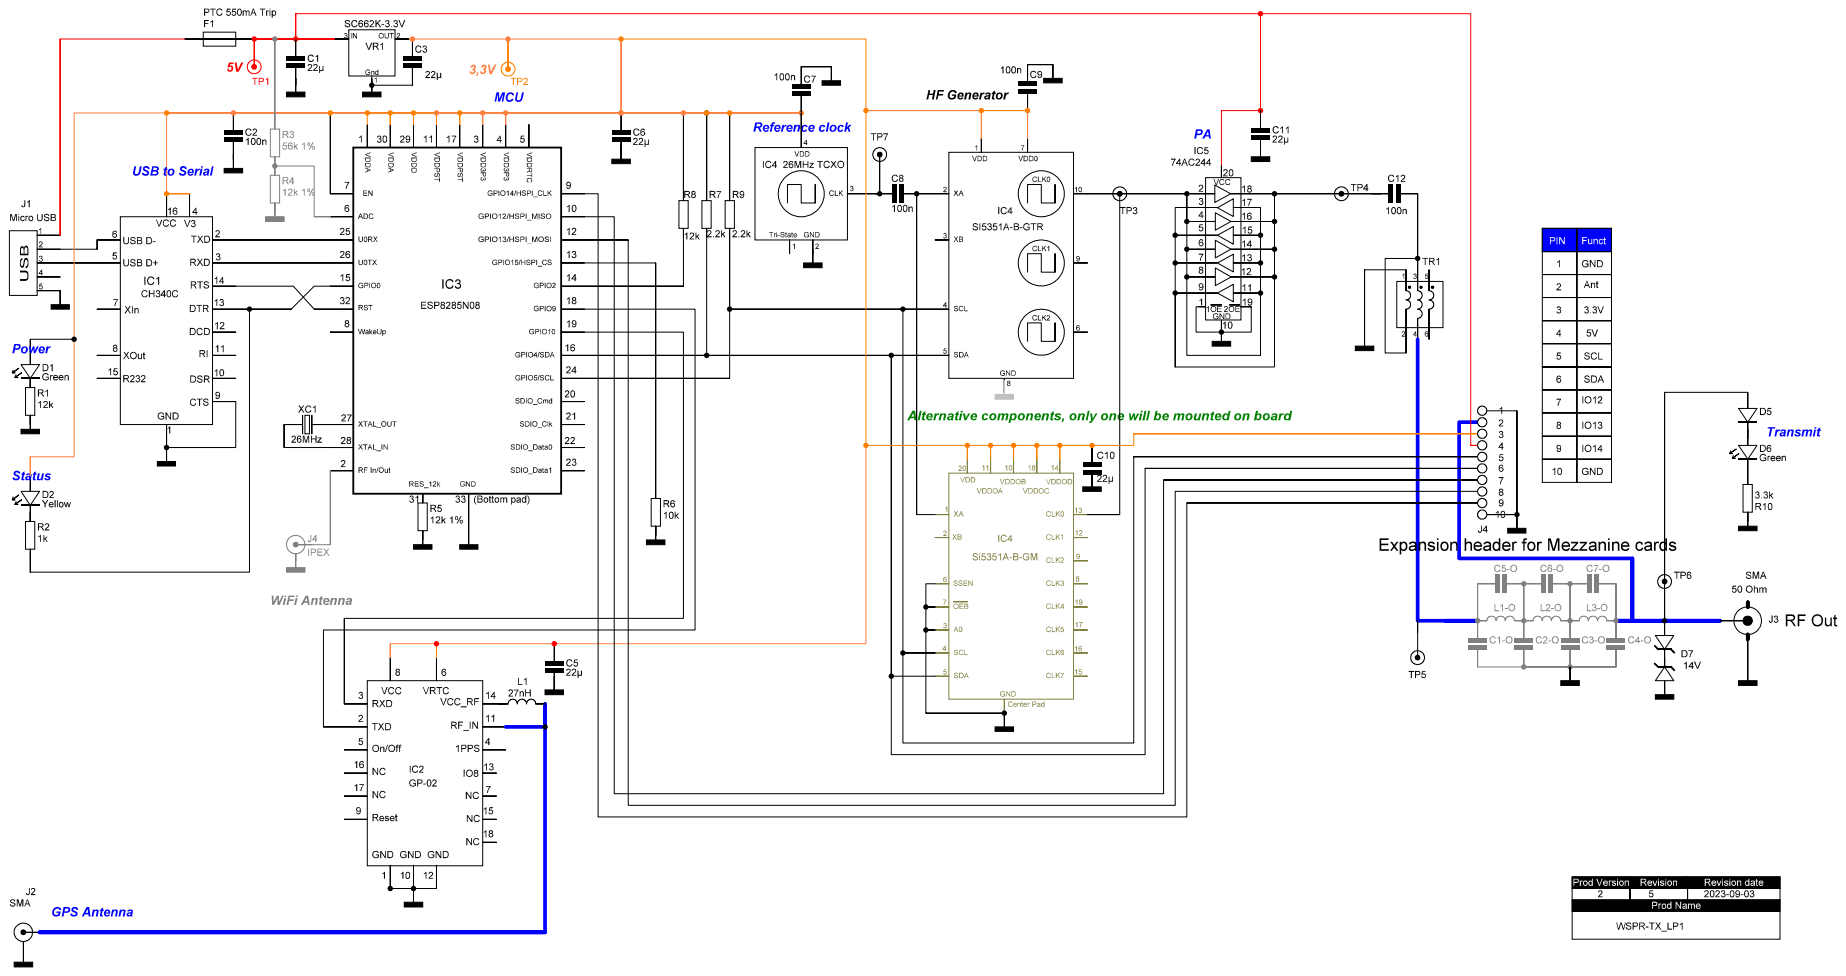
[picture p39: page 1]
