HarrydeBug/WSPR-transmitters/Documentation/1011 Schema/1011 Schema V2R4.pdf

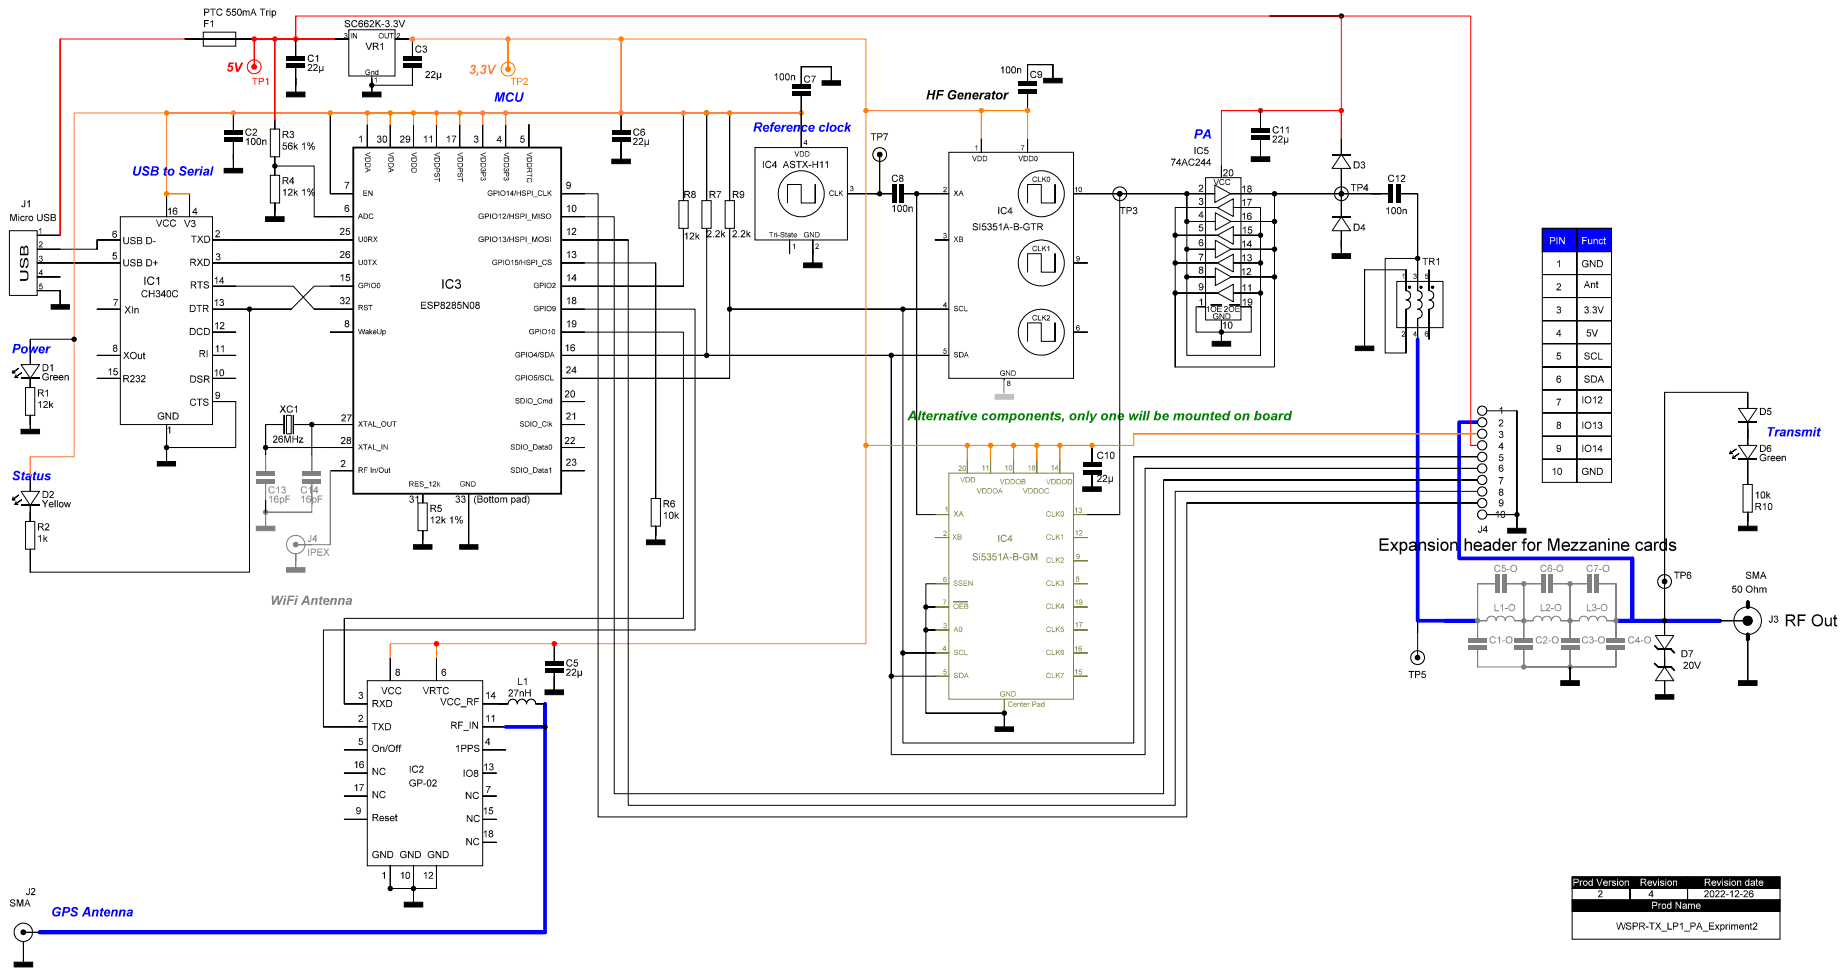
[picture p40: page 1]
