HarrydeBug/WSPR-transmitters/Documentation/1011 Schema/V1R10.pdf

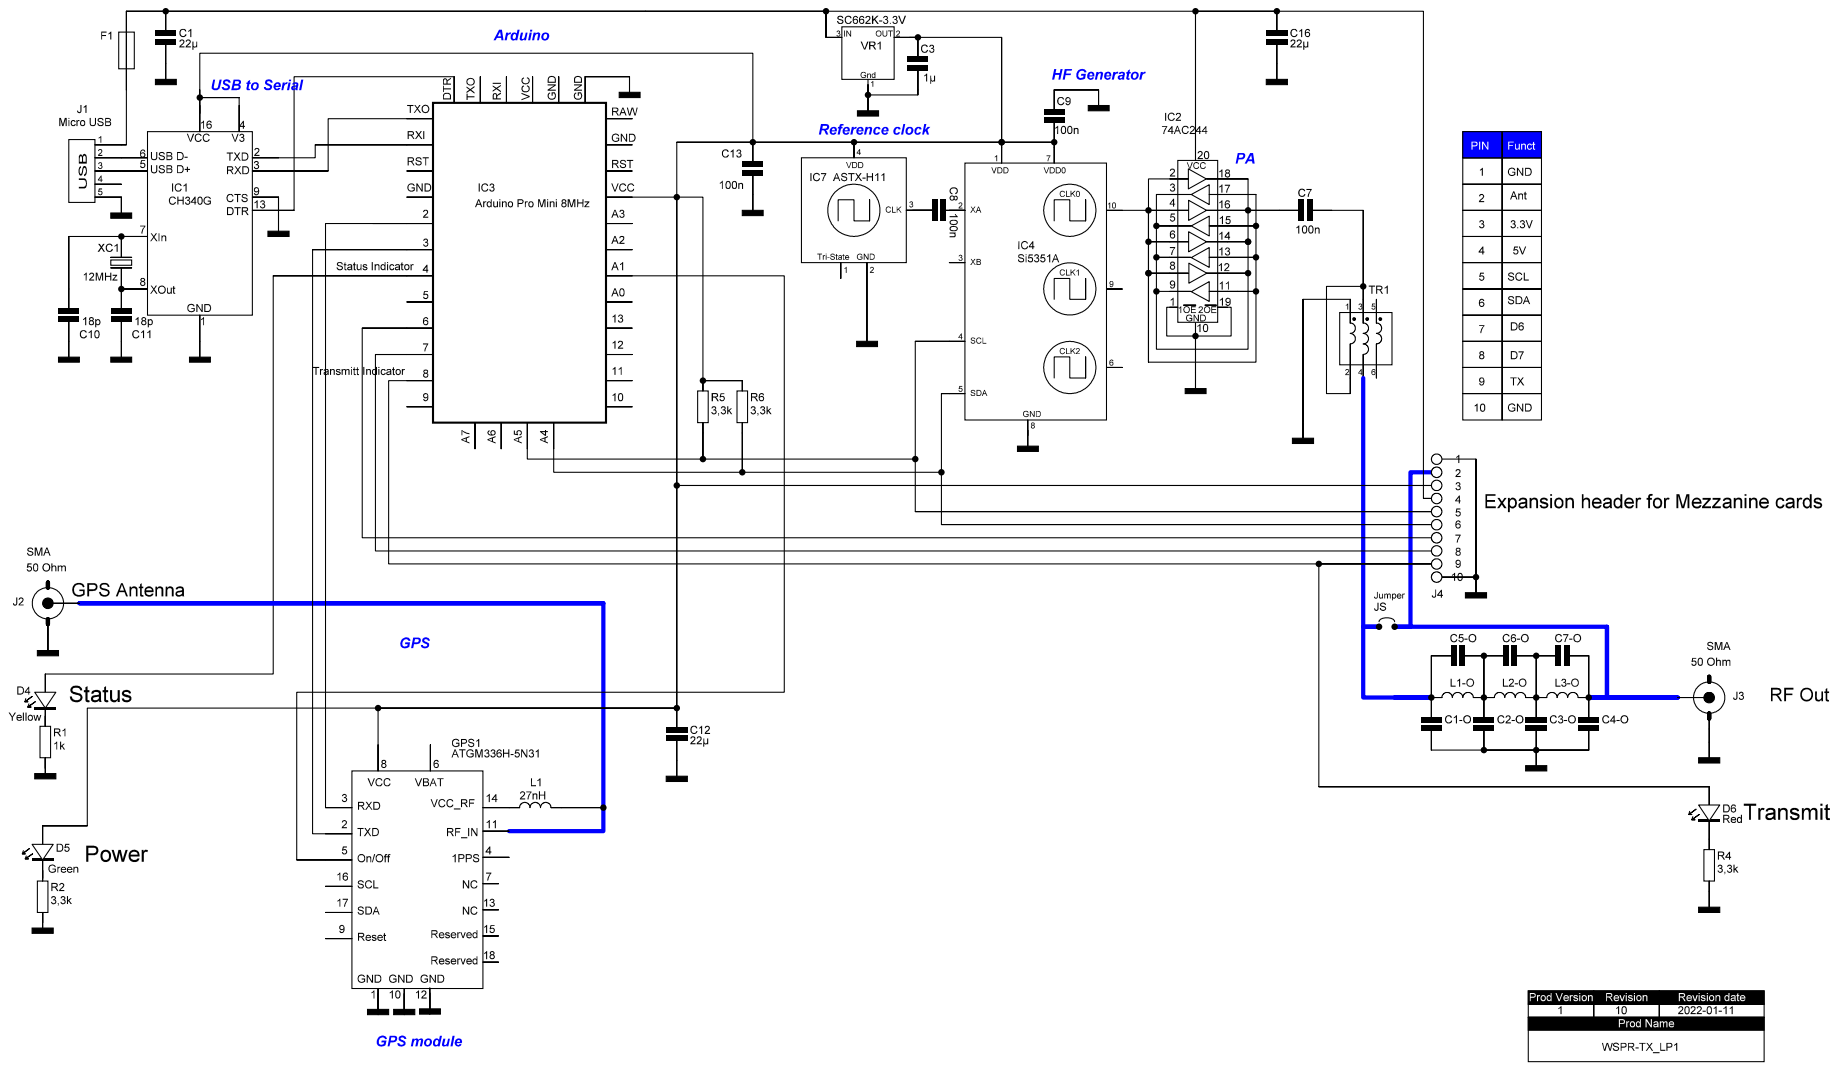
[picture p41: page 1]
