HarrydeBug/WSPR-transmitters/Documentation/1011 Schema/V1R11.pdf

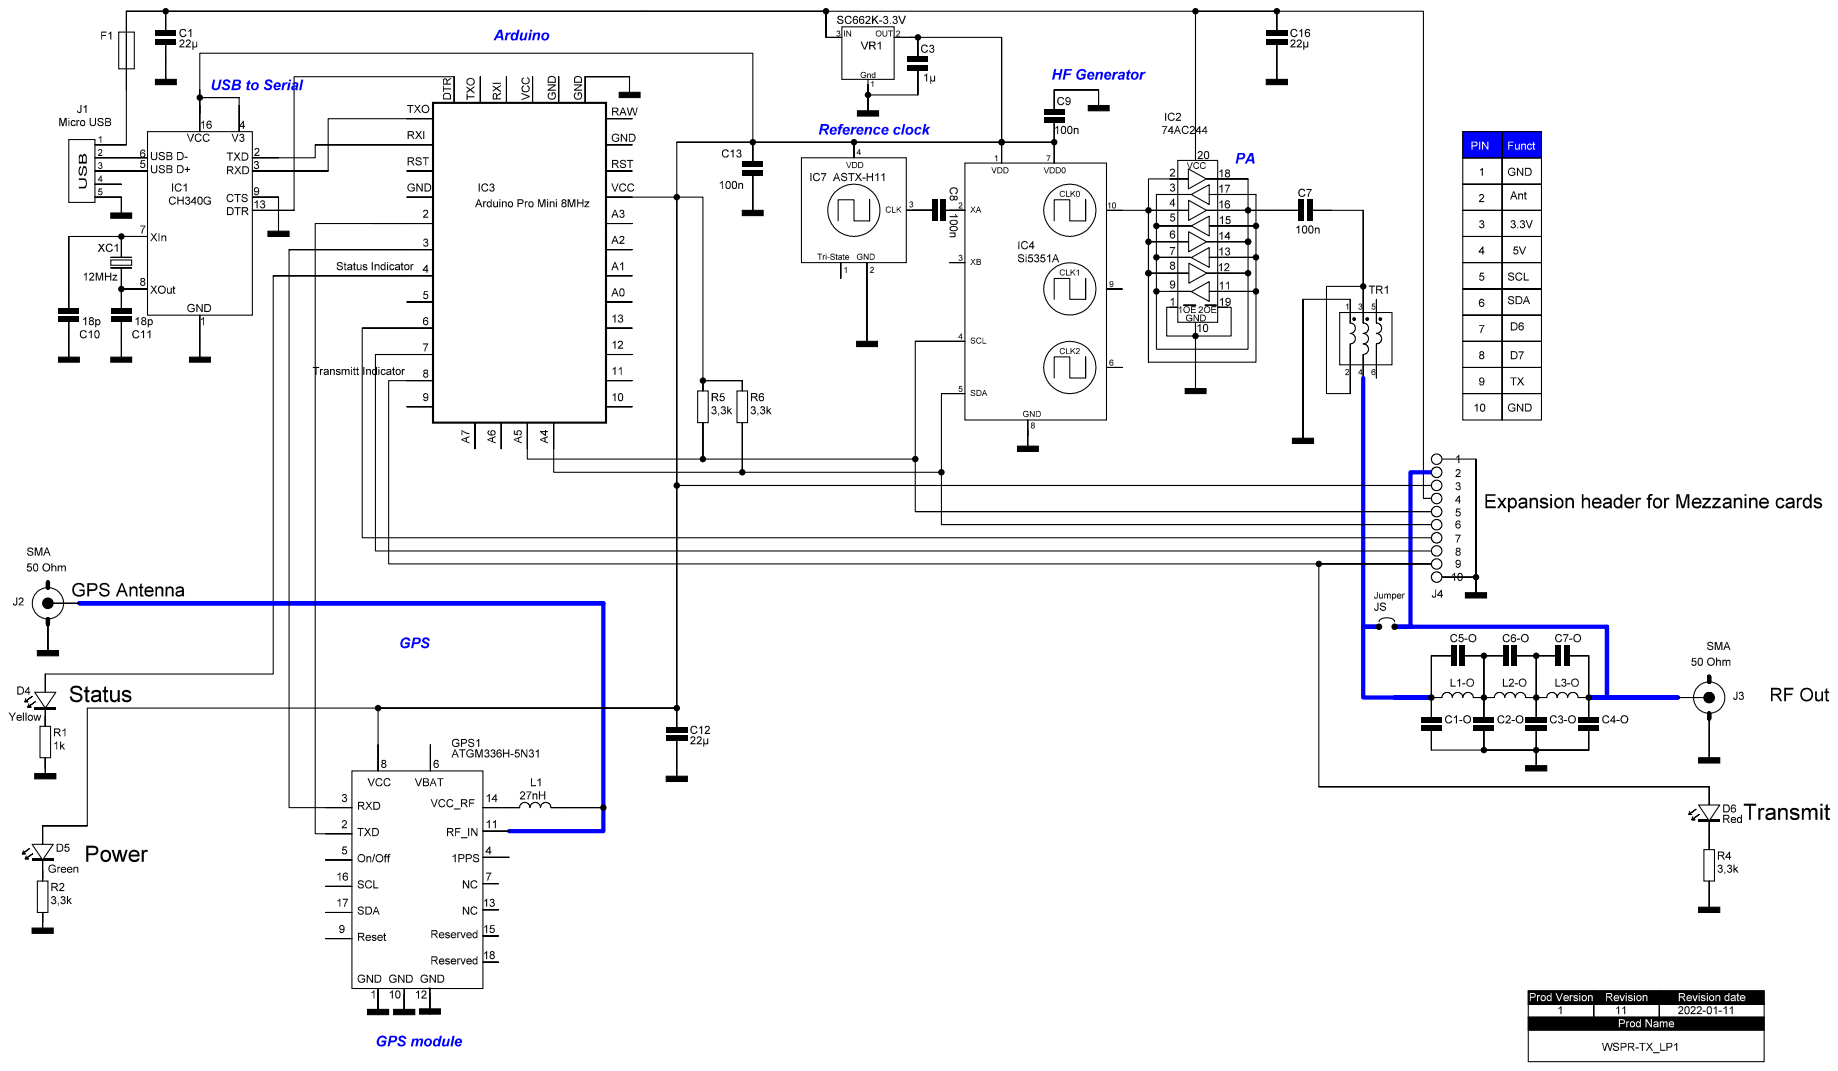
[picture p42: page 1]
