HarrydeBug/WSPR-transmitters/Documentation/1011 Schema/V1R13.pdf

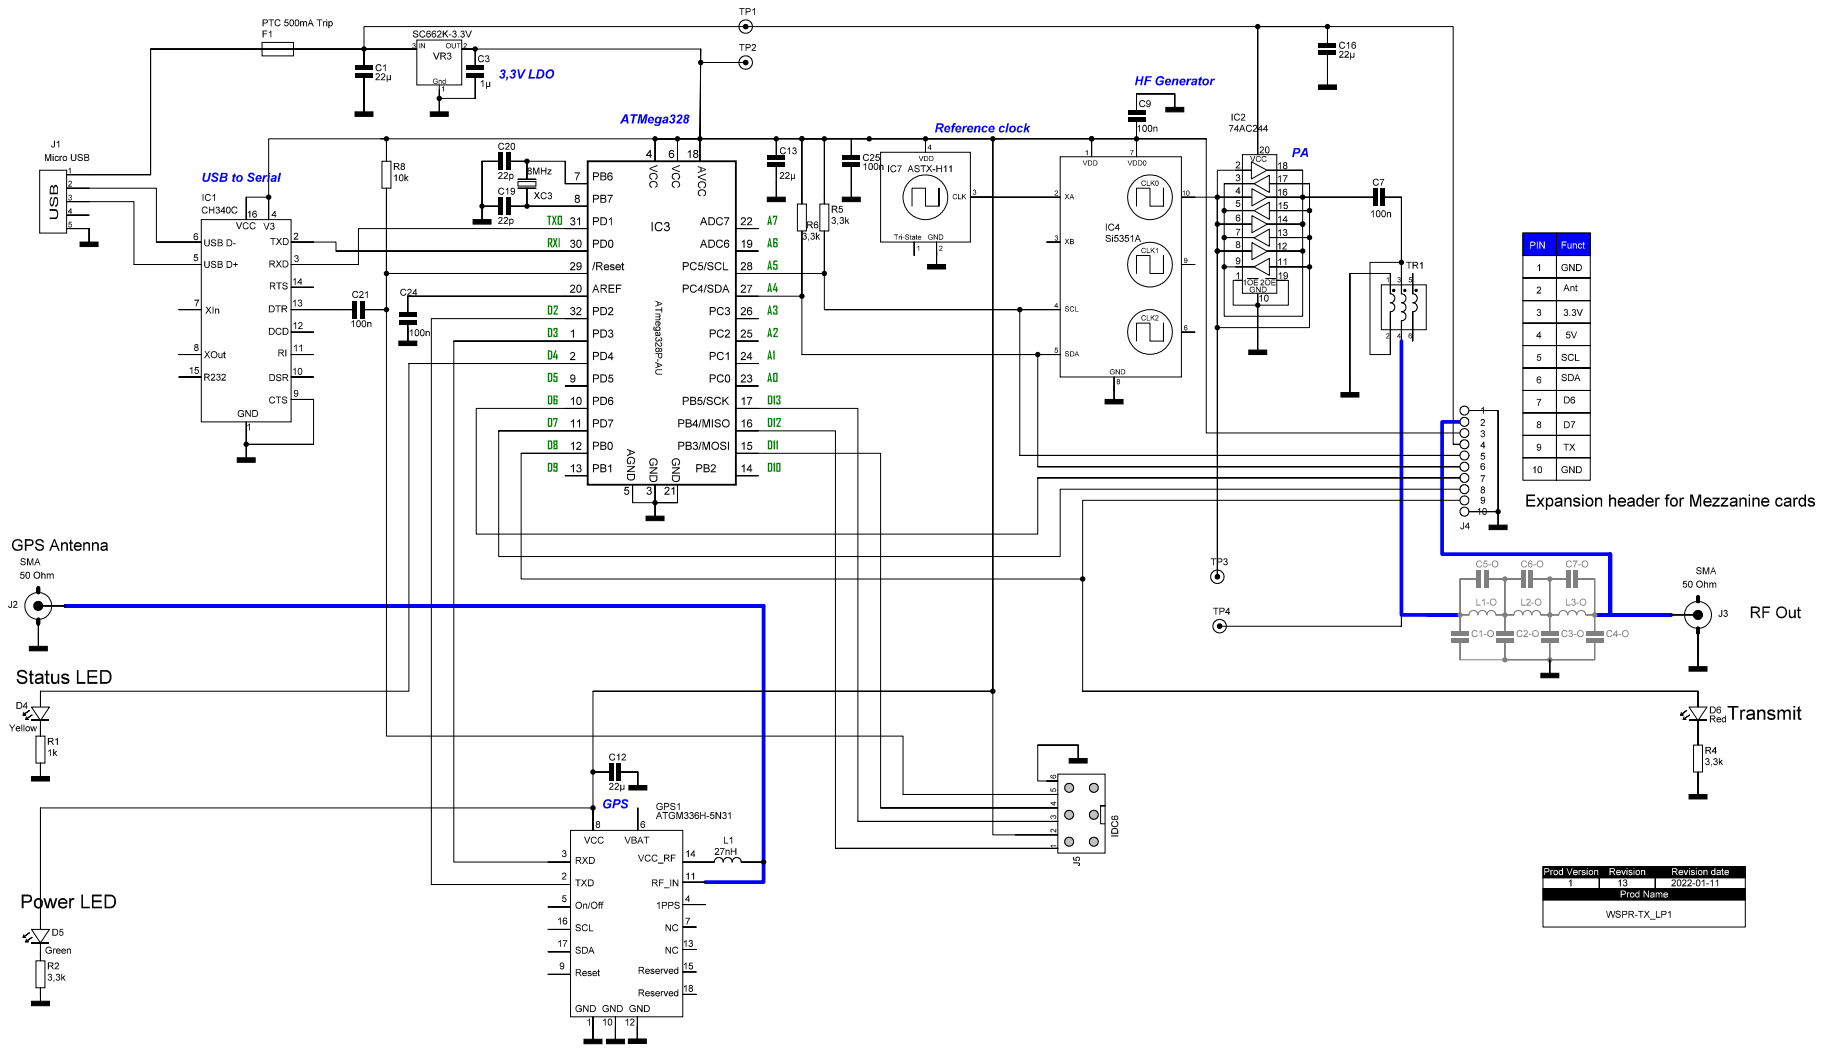
[picture p43: page 1]
