HarrydeBug/WSPR-transmitters/Documentation/1011 Schema/V1R15.pdf

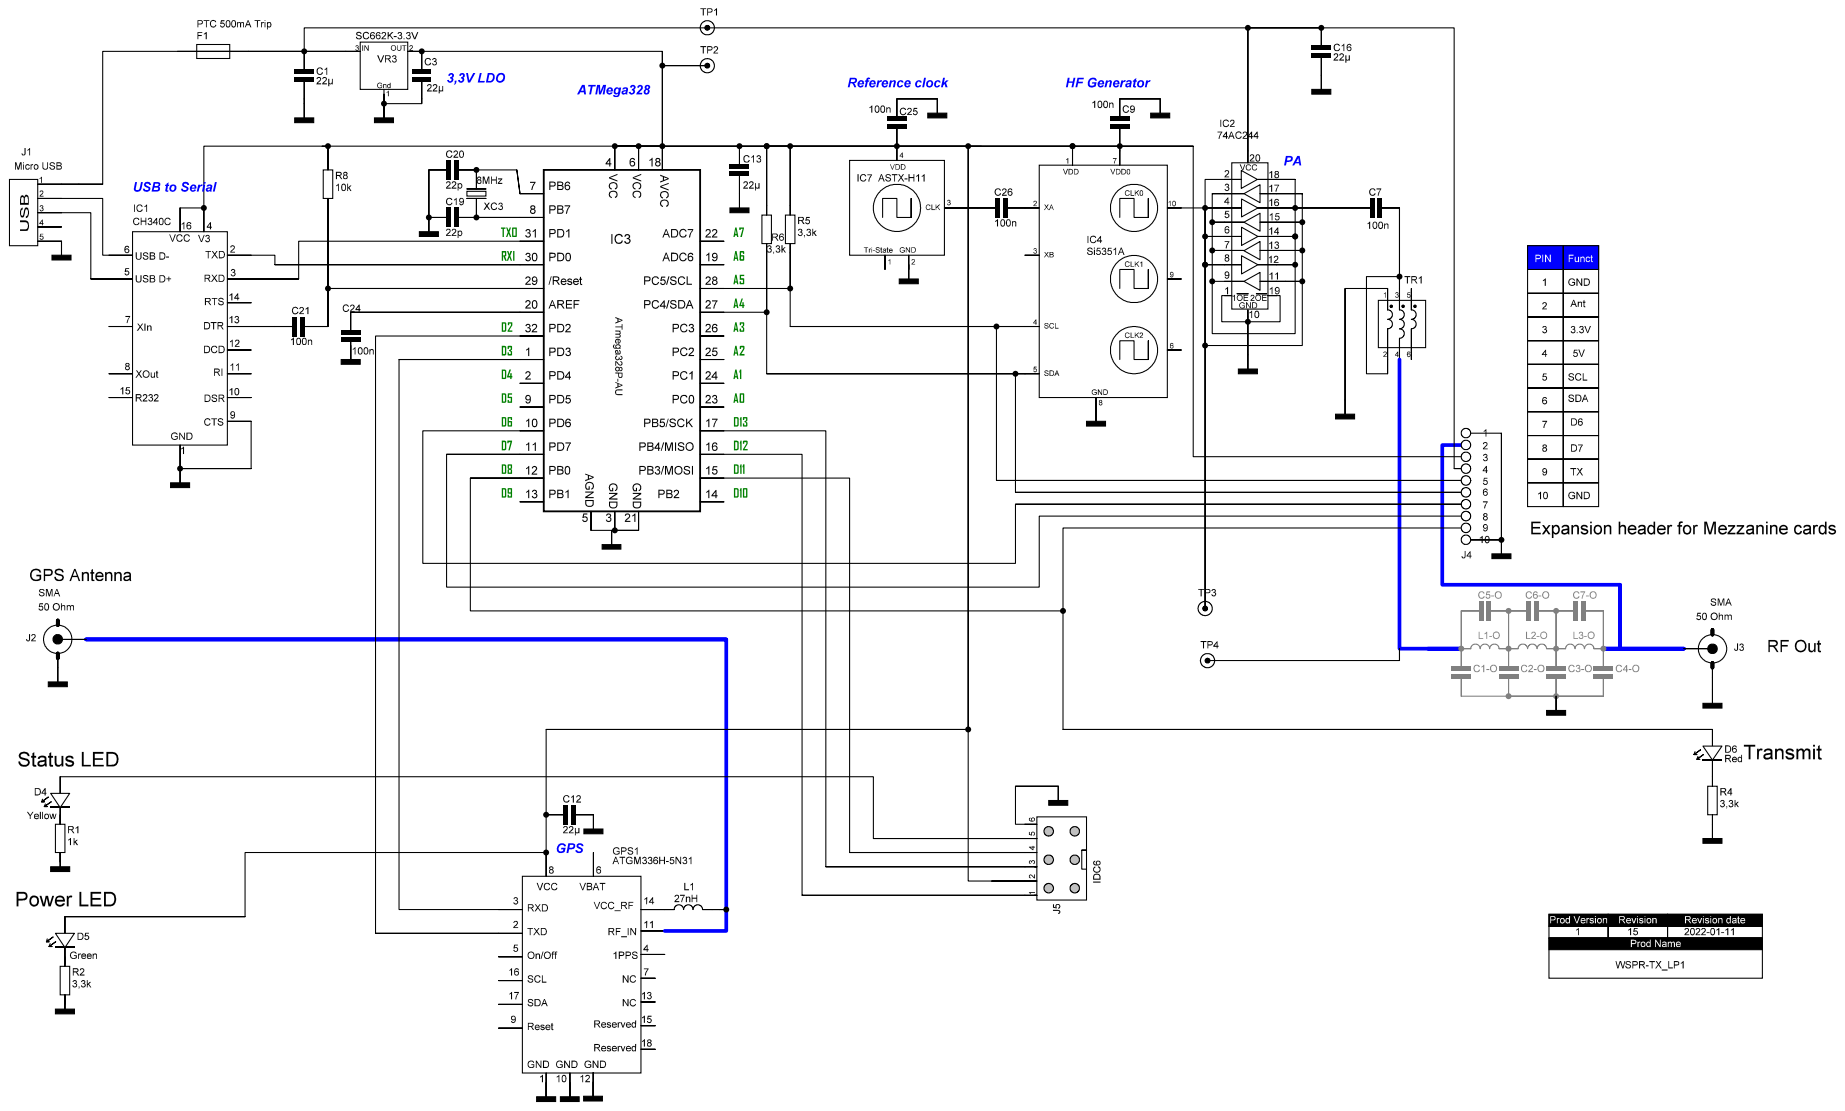
[picture p44: page 1]
