HarrydeBug/WSPR-transmitters/Documentation/1011 Schema/V1R17.pdf

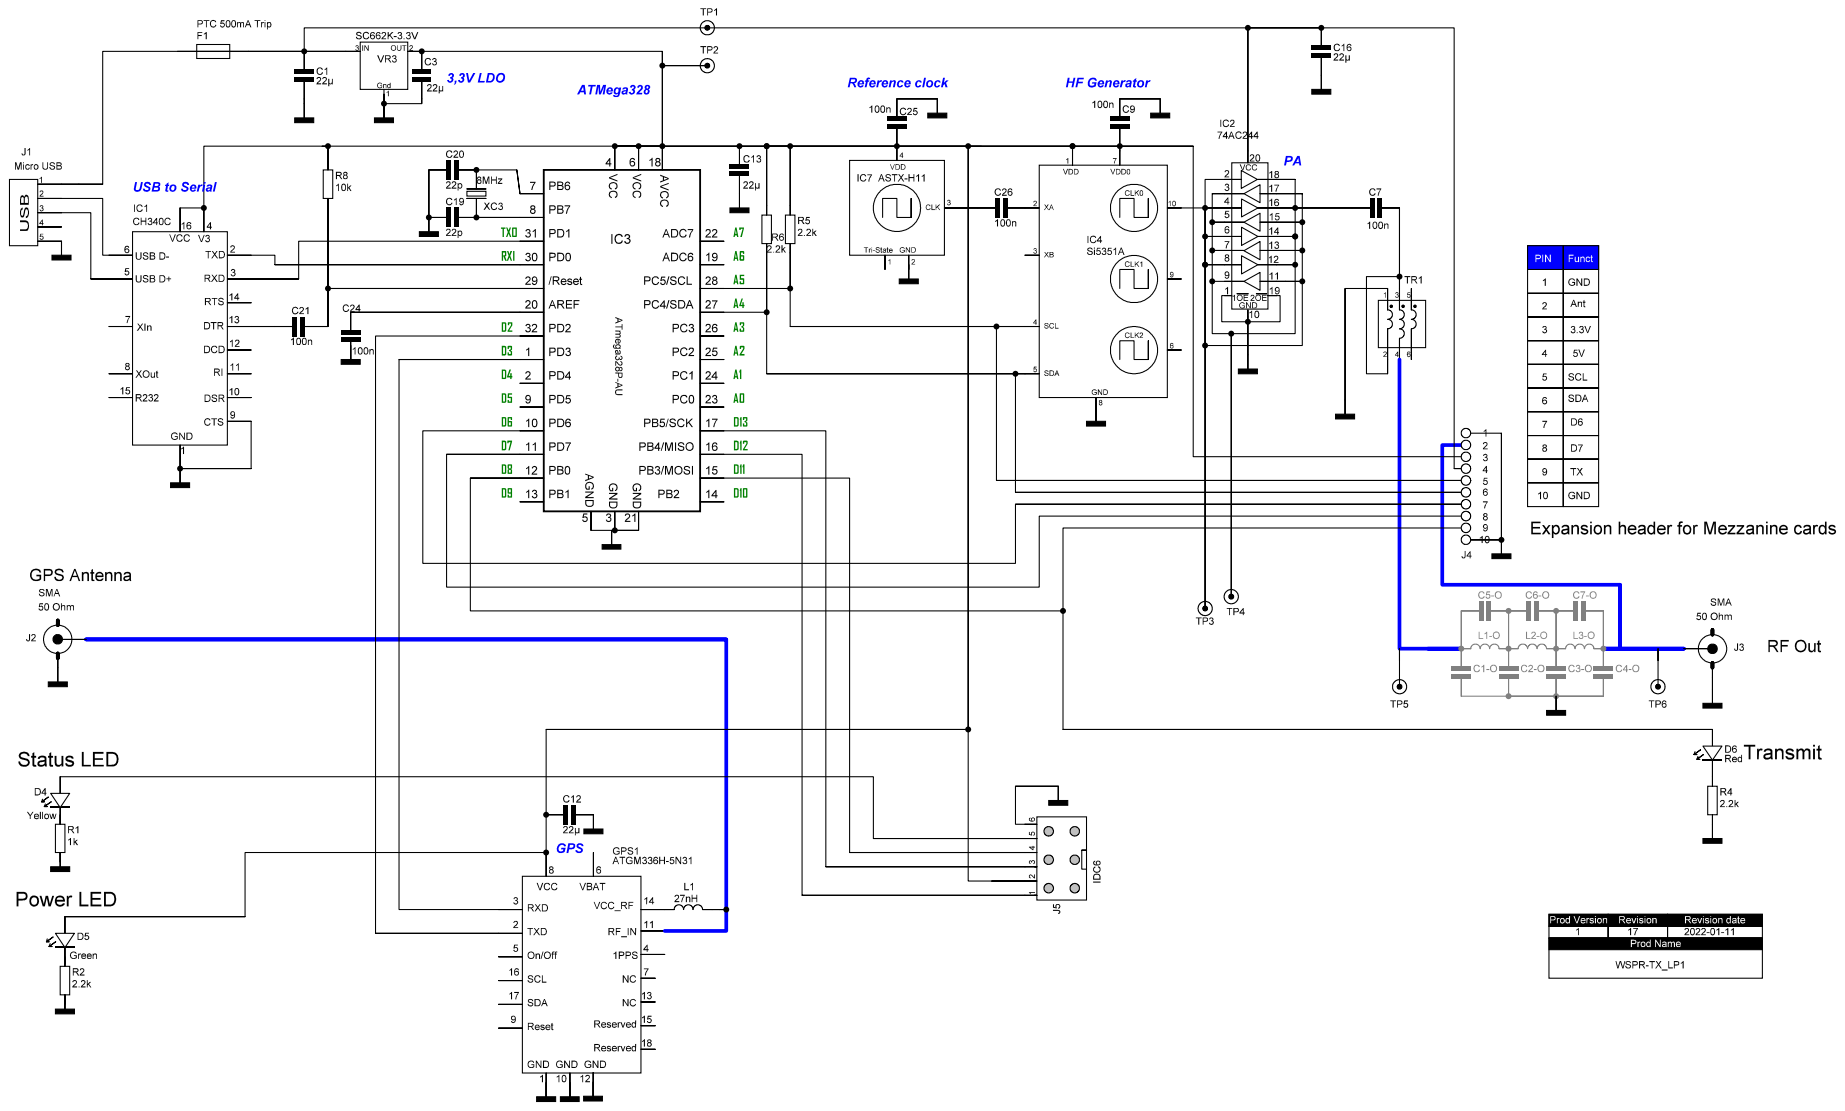
[picture p45: page 1]
