HarrydeBug/WSPR-transmitters/Documentation/1011 Schema/V1R4.pdf

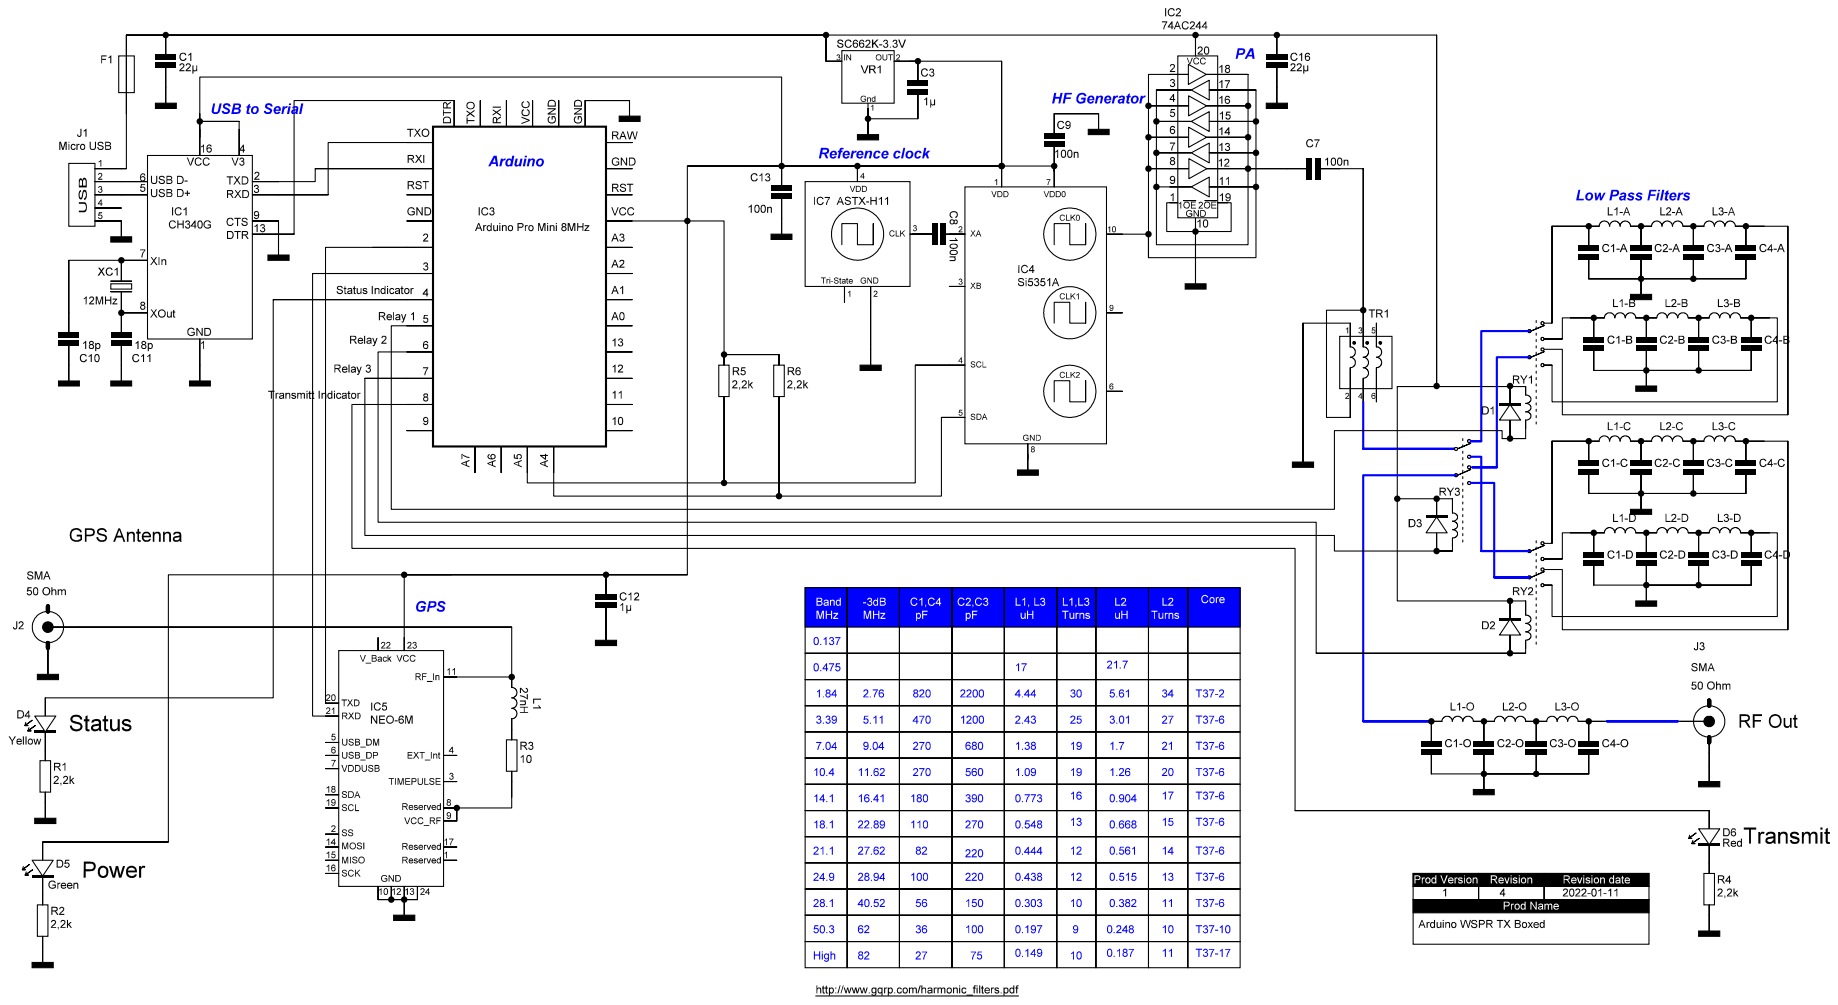
[picture p46: page 1]
