HarrydeBug/WSPR-transmitters/Documentation/1011 Schema/V1R5.pdf

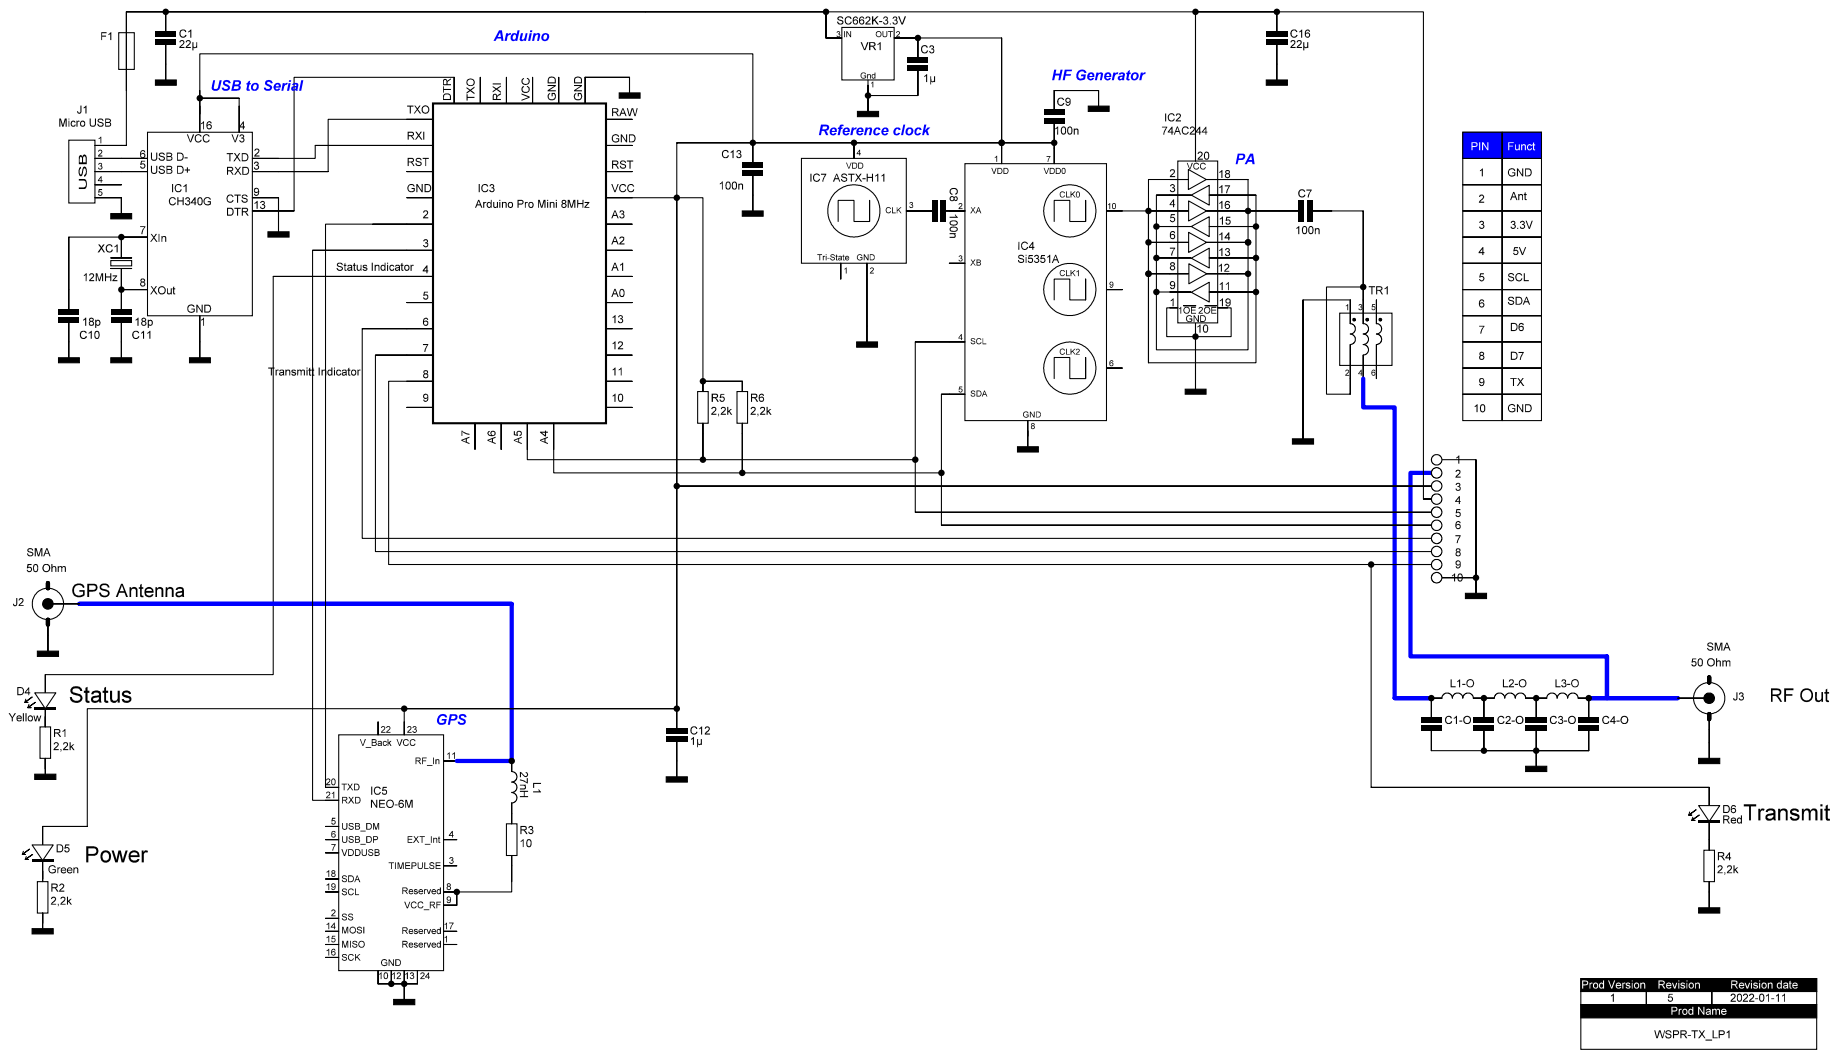
[picture p47: page 1]
