HarrydeBug/WSPR-transmitters/Documentation/1011 Schema/V1R6.pdf

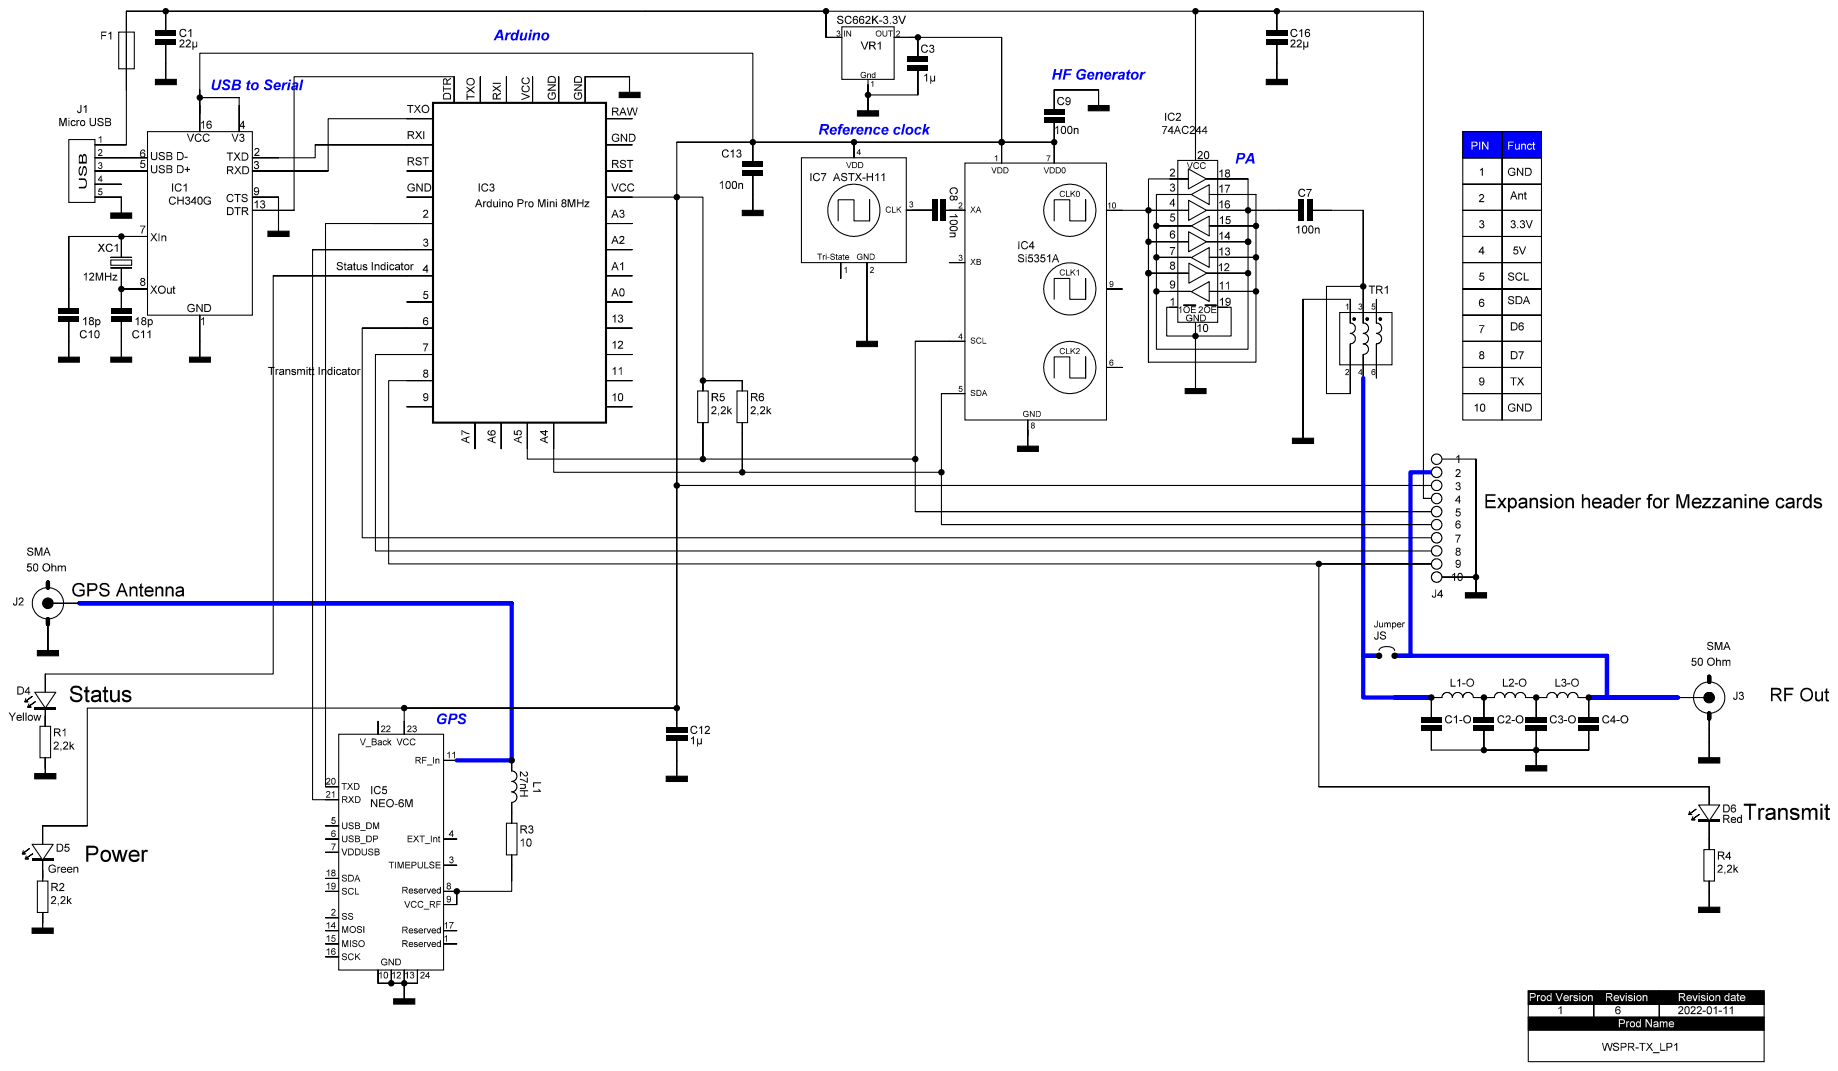
[picture p48: page 1]
