HarrydeBug/WSPR-transmitters/Documentation/1011 Schema/V1R7.pdf

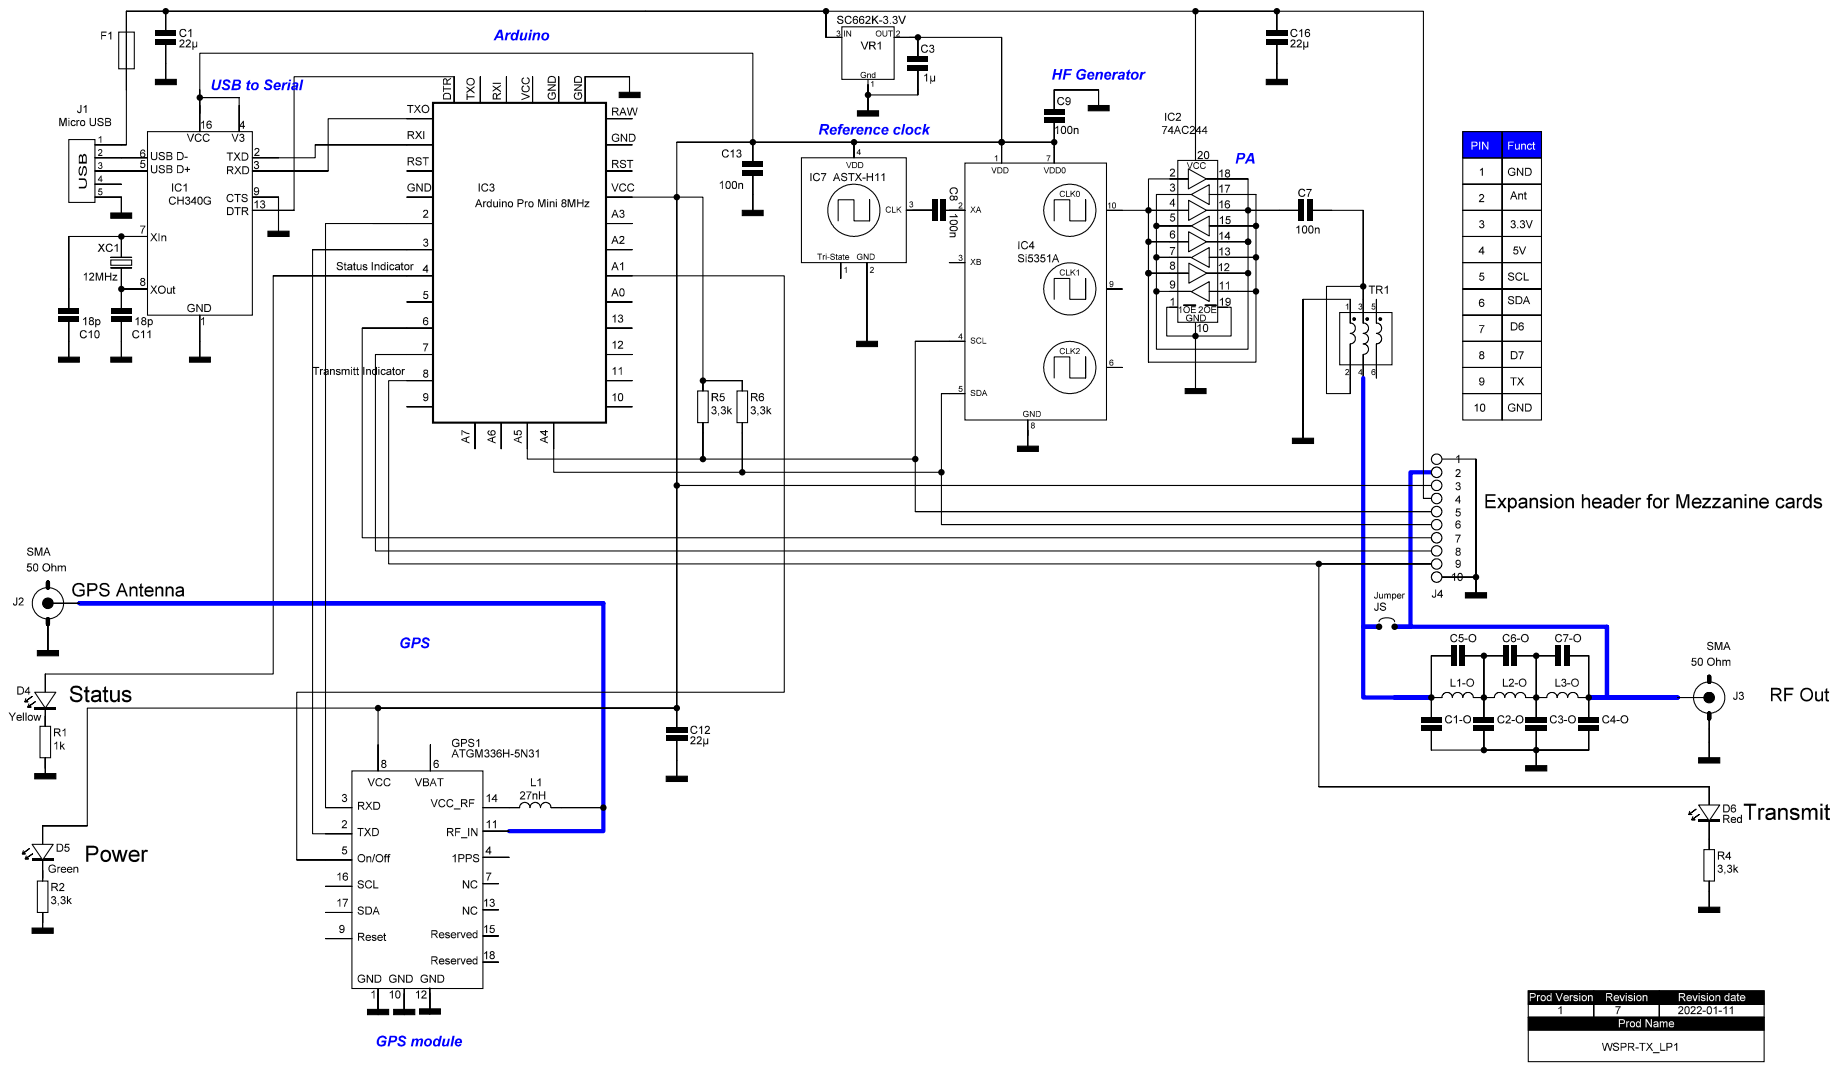
[picture p49: page 1]
