HarrydeBug/WSPR-transmitters/Documentation/1012 Schema/Hardware Version 1/V1R16-HighPlus.pdf

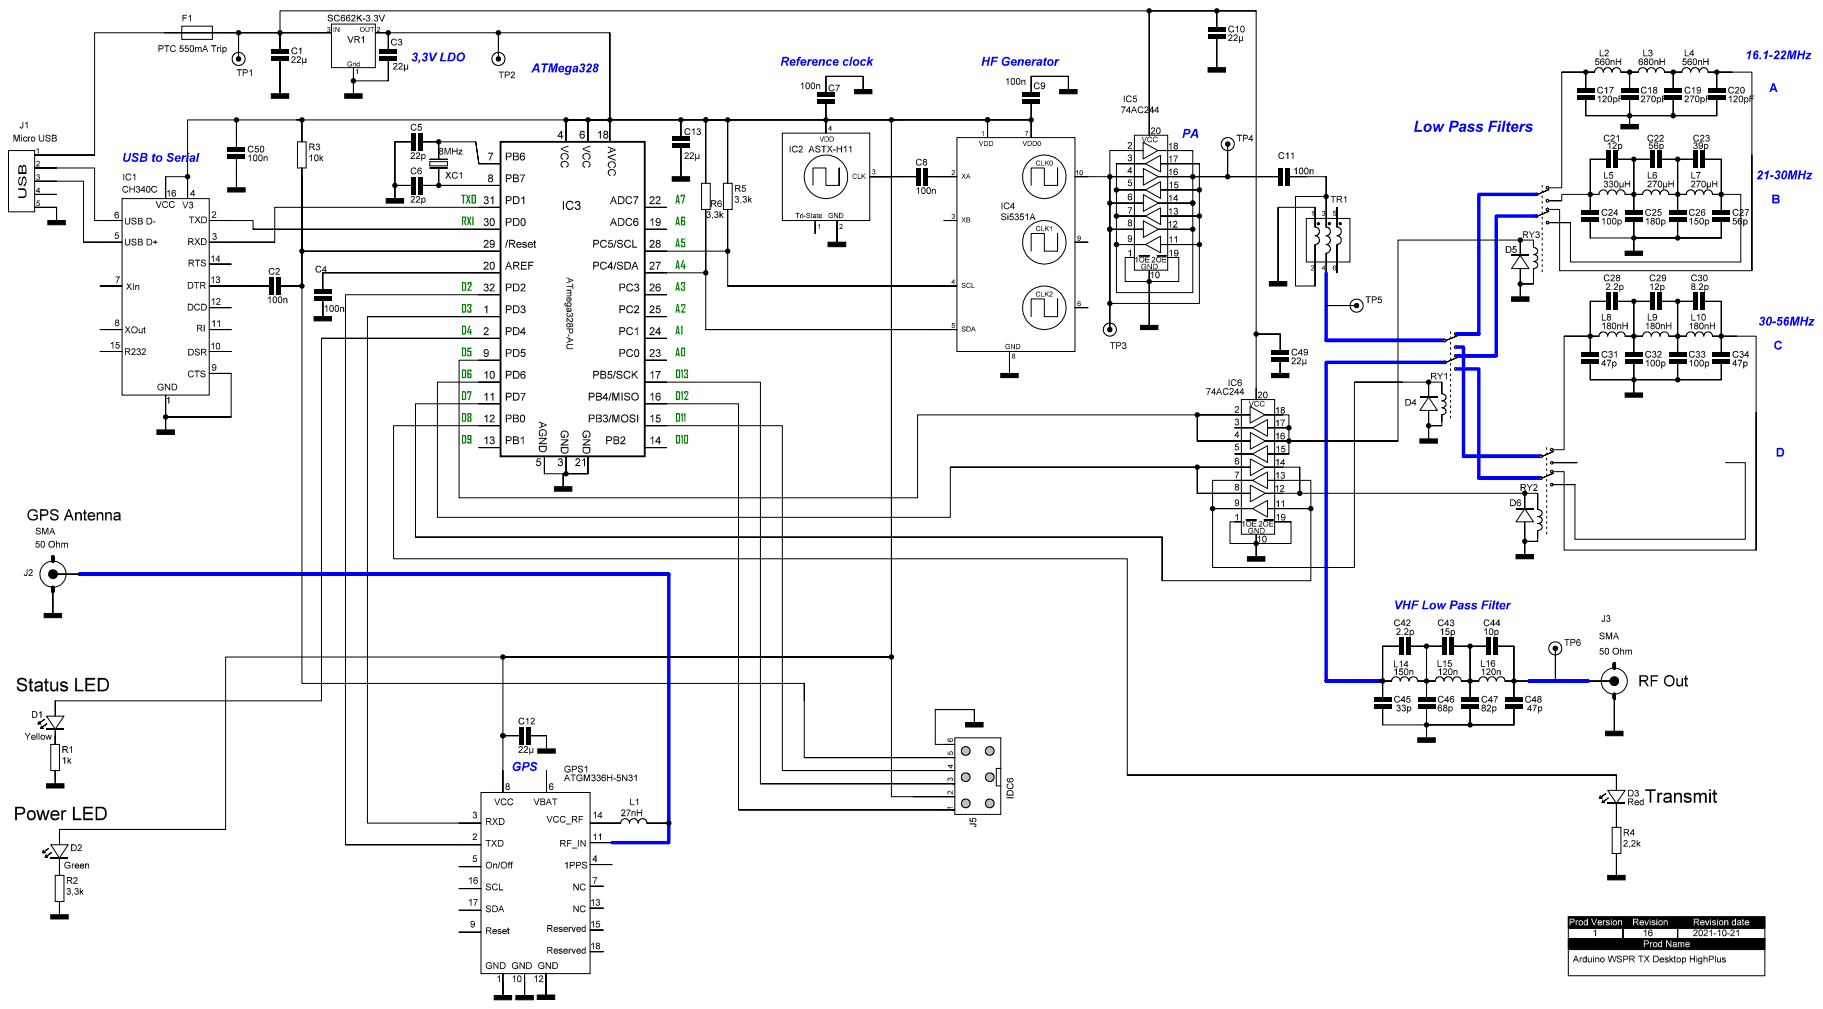
[picture p50: page 1]
