HarrydeBug/WSPR-transmitters/Documentation/1012 Schema/Hardware Version 1/V1R16-MidPlus.pdf

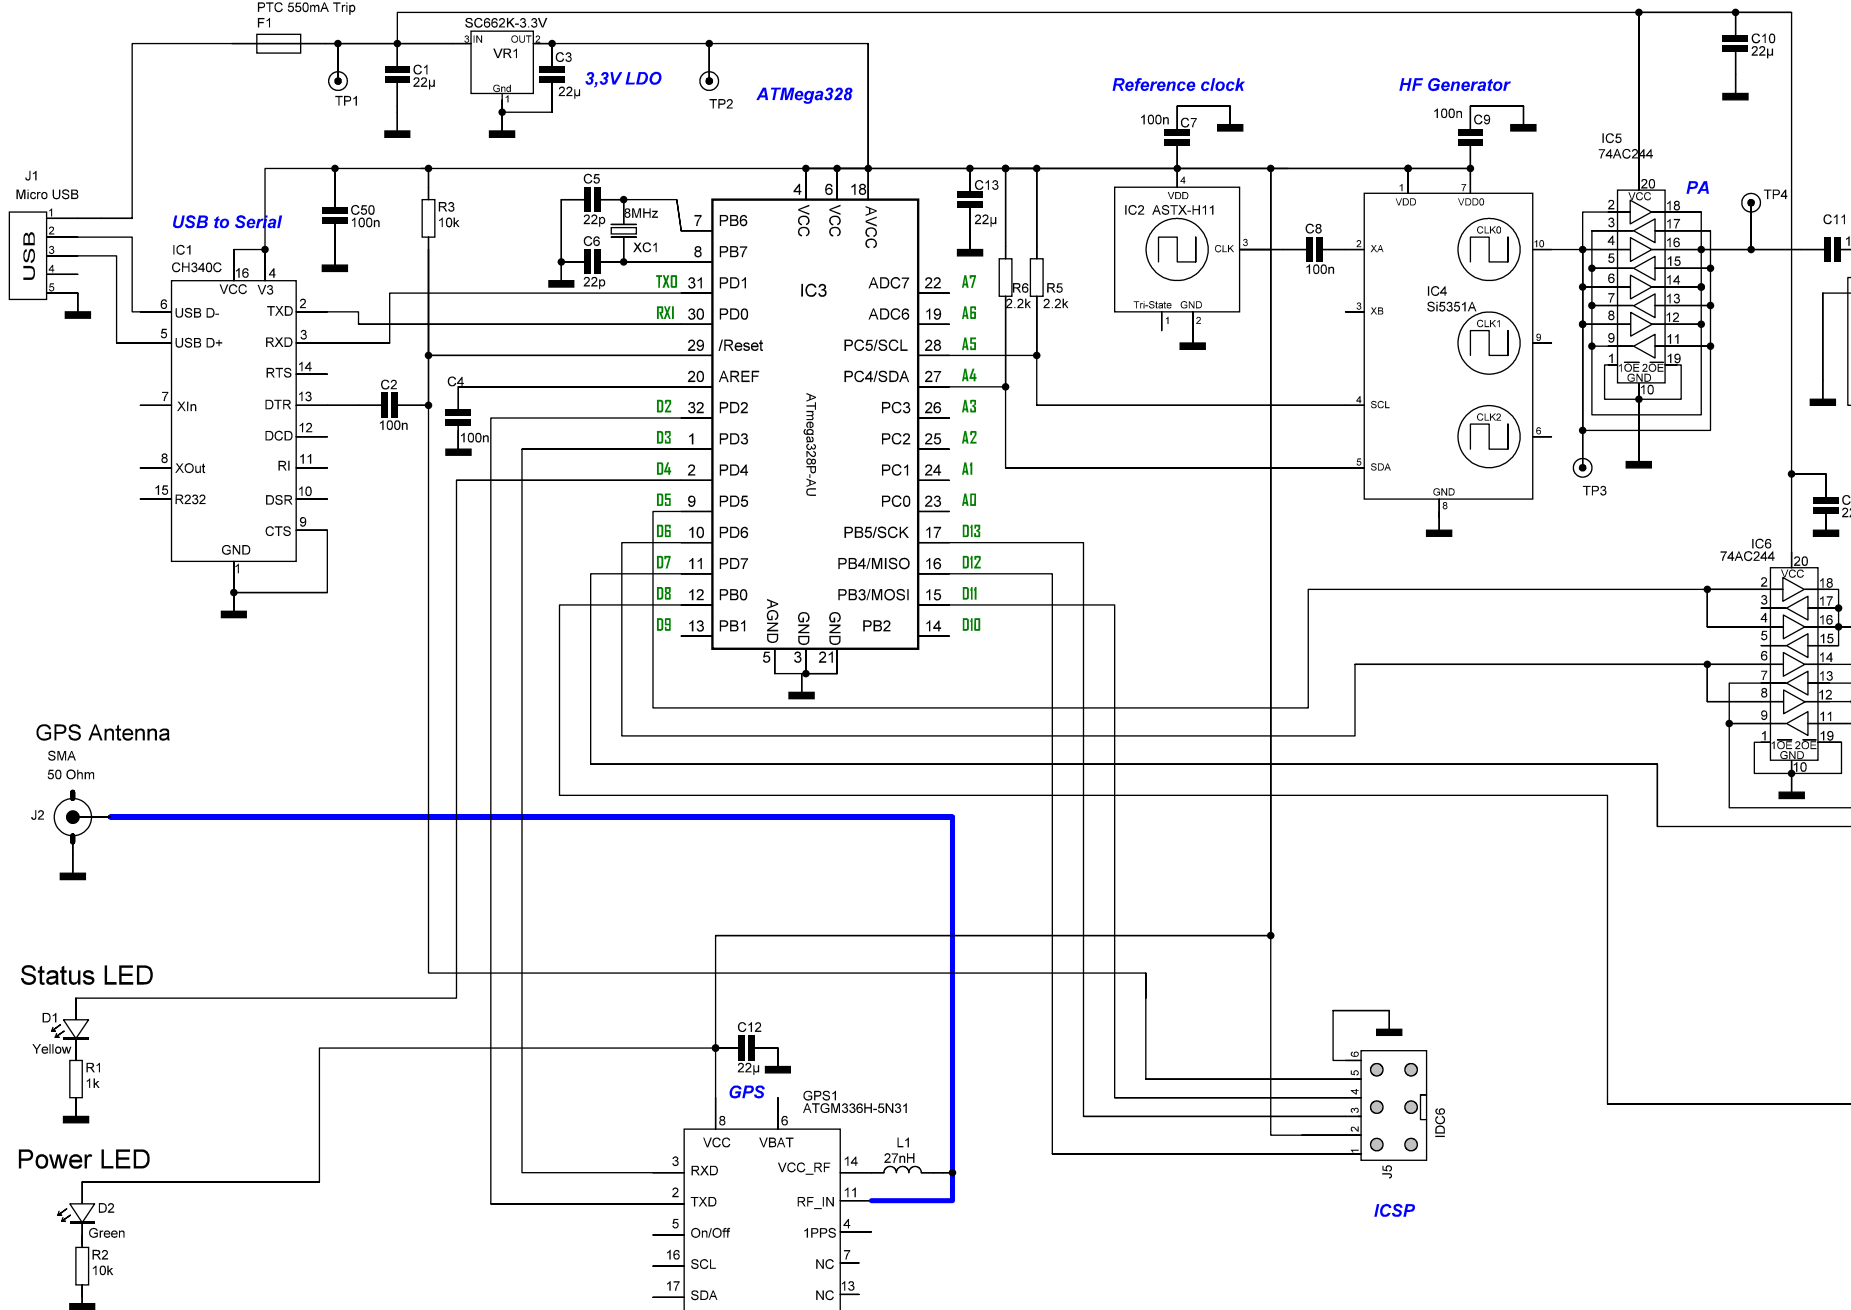
[picture p51: page 1]
