HarrydeBug/WSPR-transmitters/Documentation/1012 Schema/Hardware Version 1/V1R17-HighPlus.pdf

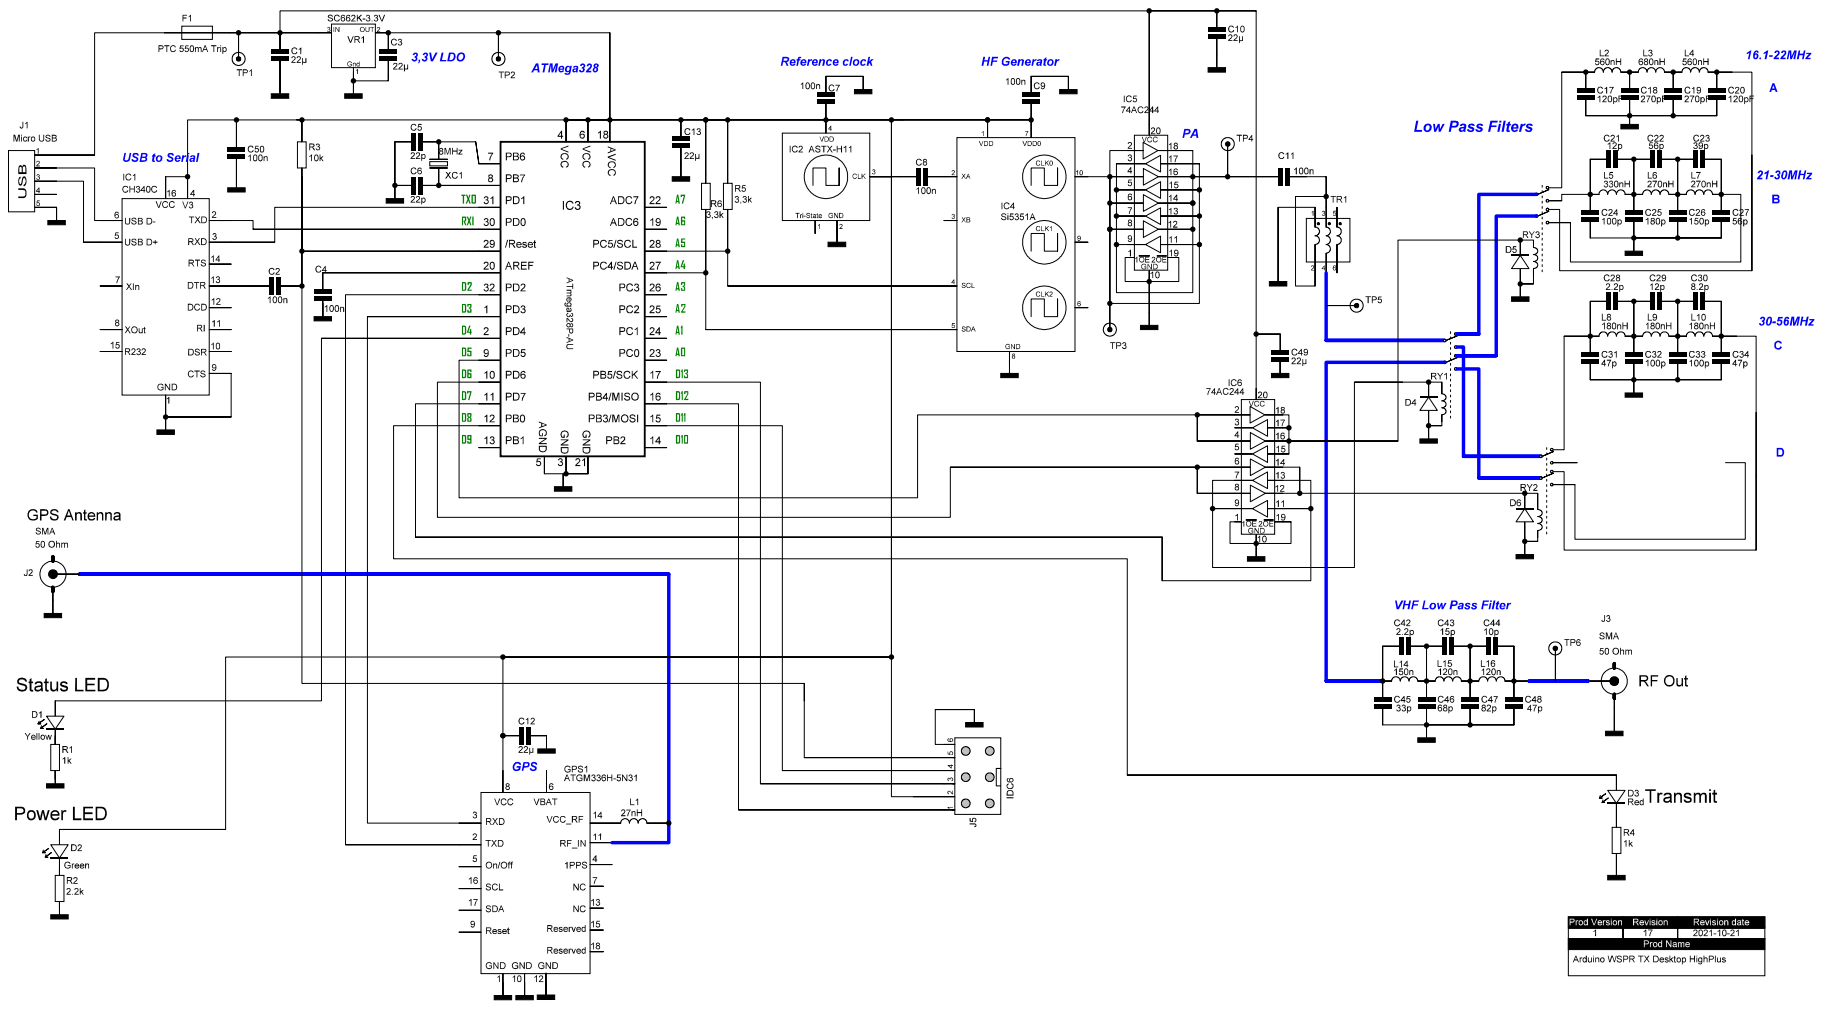
[picture p52: page 1]
