HarrydeBug/WSPR-transmitters/Documentation/1012 Schema/Hardware Version 1/V1R17-Low.pdf

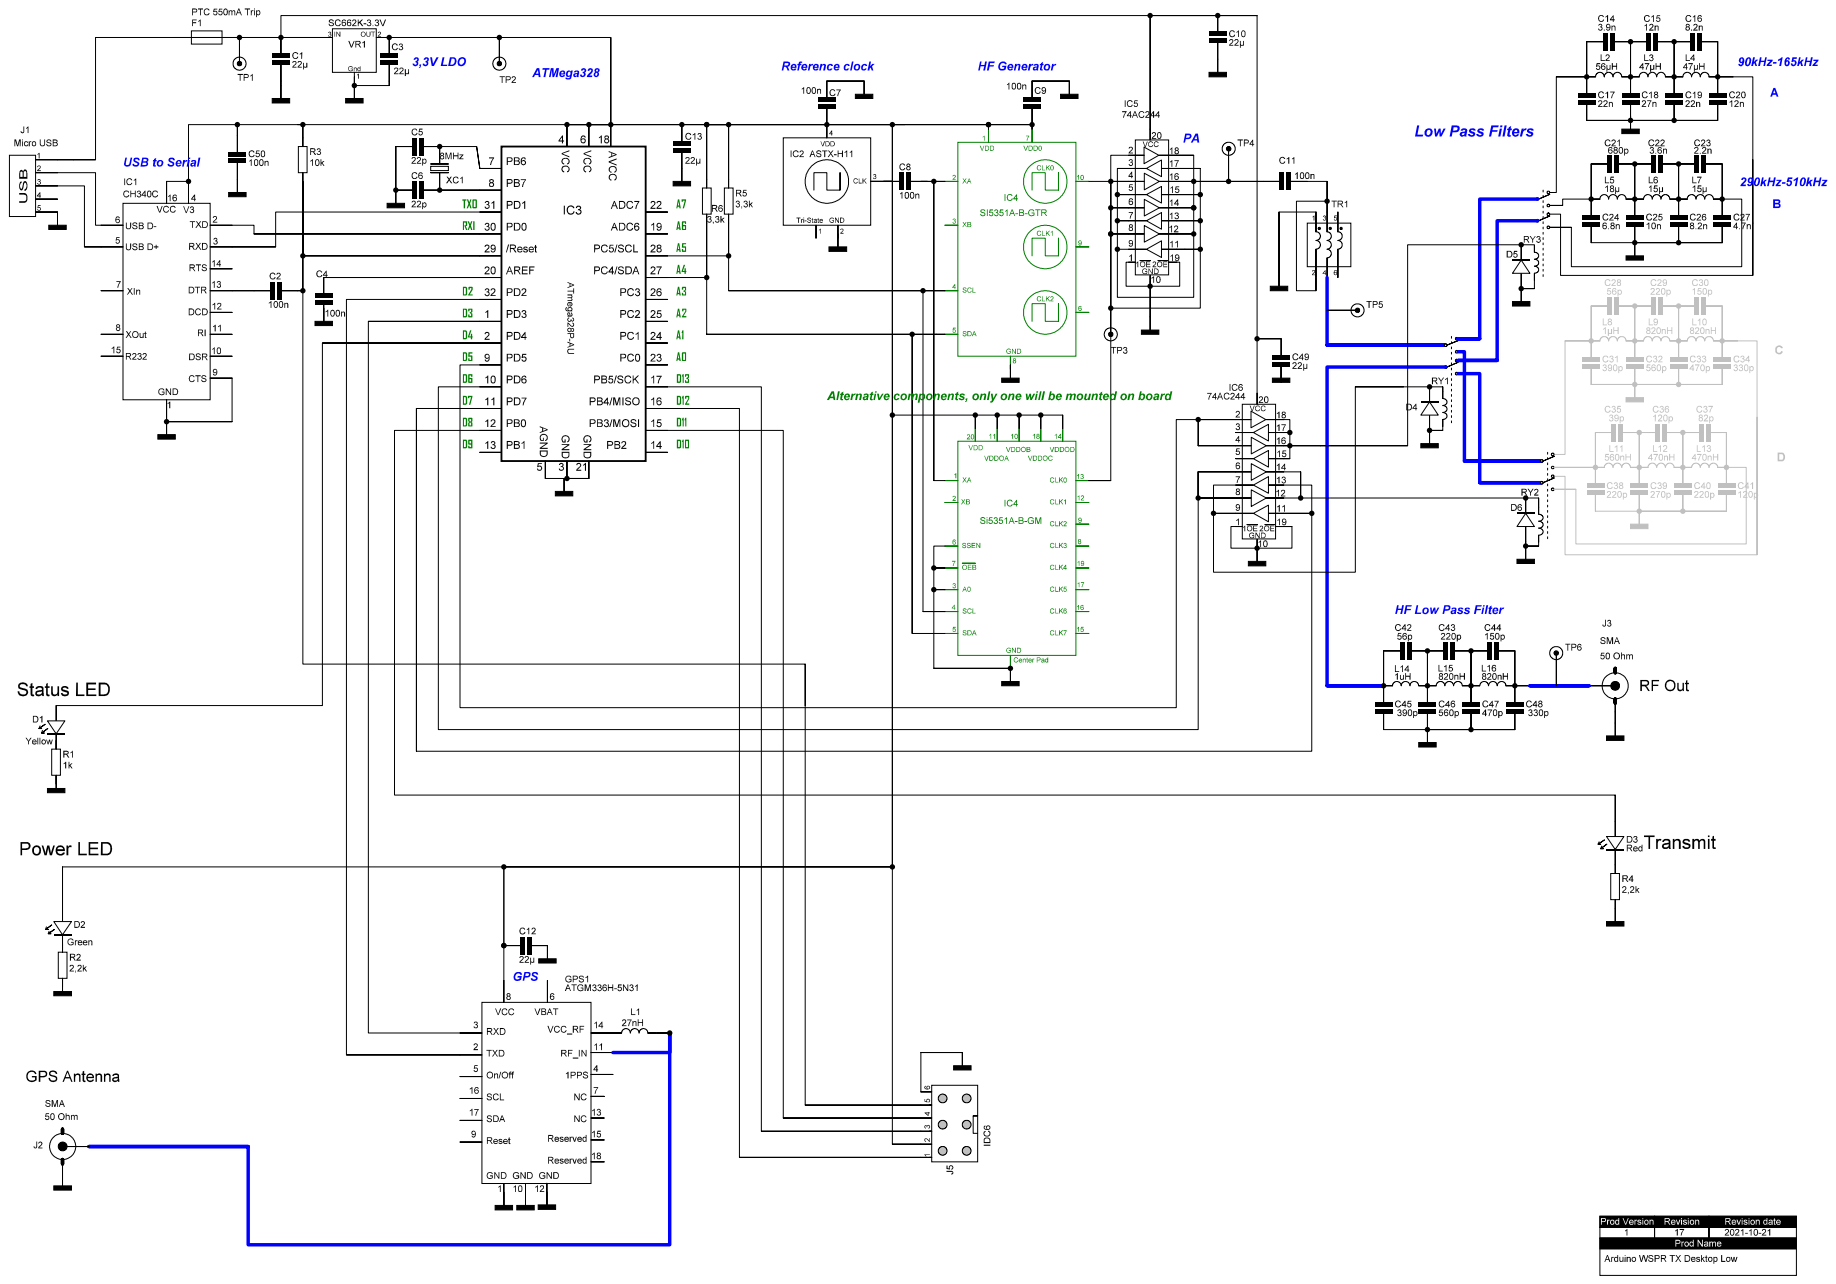
[picture p53: page 1]
