HarrydeBug/WSPR-transmitters/Documentation/1012 Schema/Hardware Version 1/V1R17-MidPlus.pdf

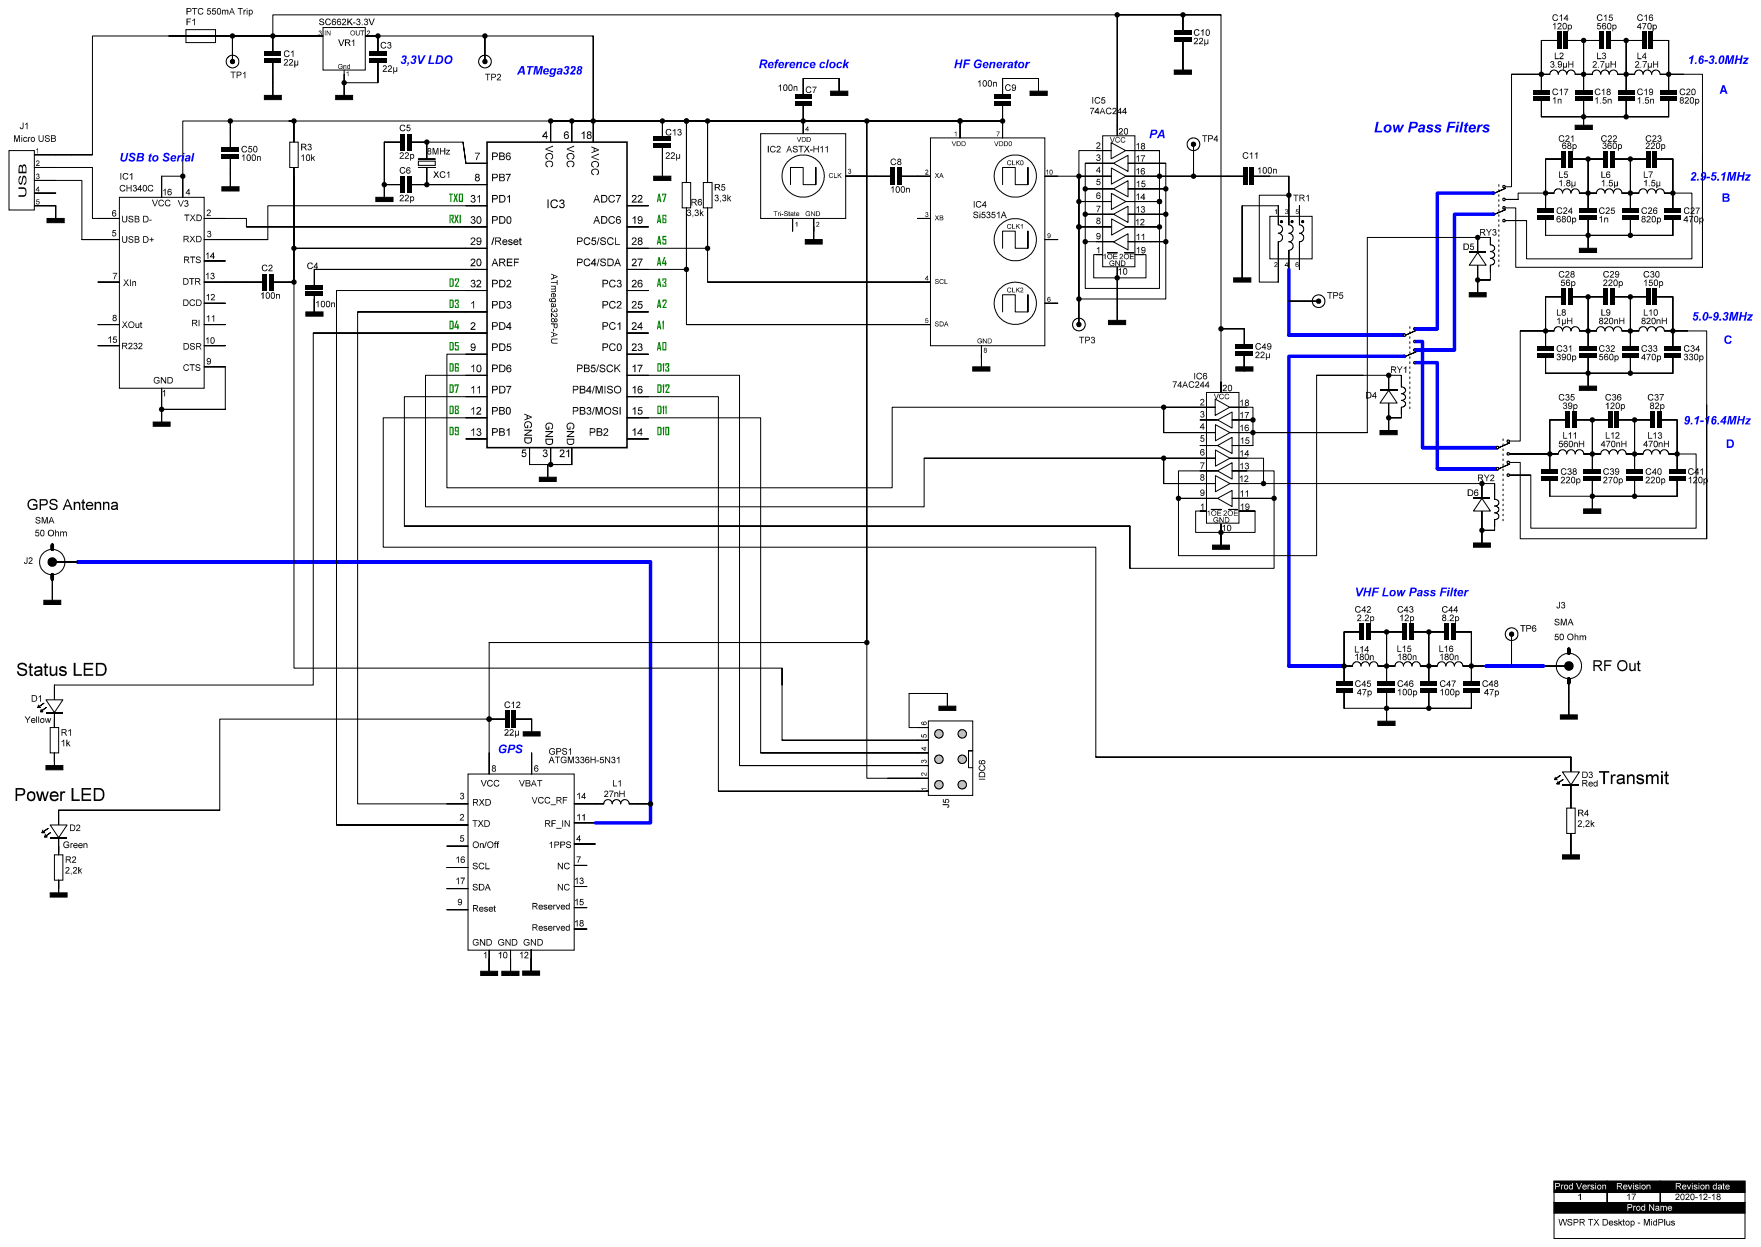
[picture p54: page 1]
