HarrydeBug/WSPR-transmitters/Documentation/1012 Schema/Hardware Version 1/V1R19-80To10.pdf

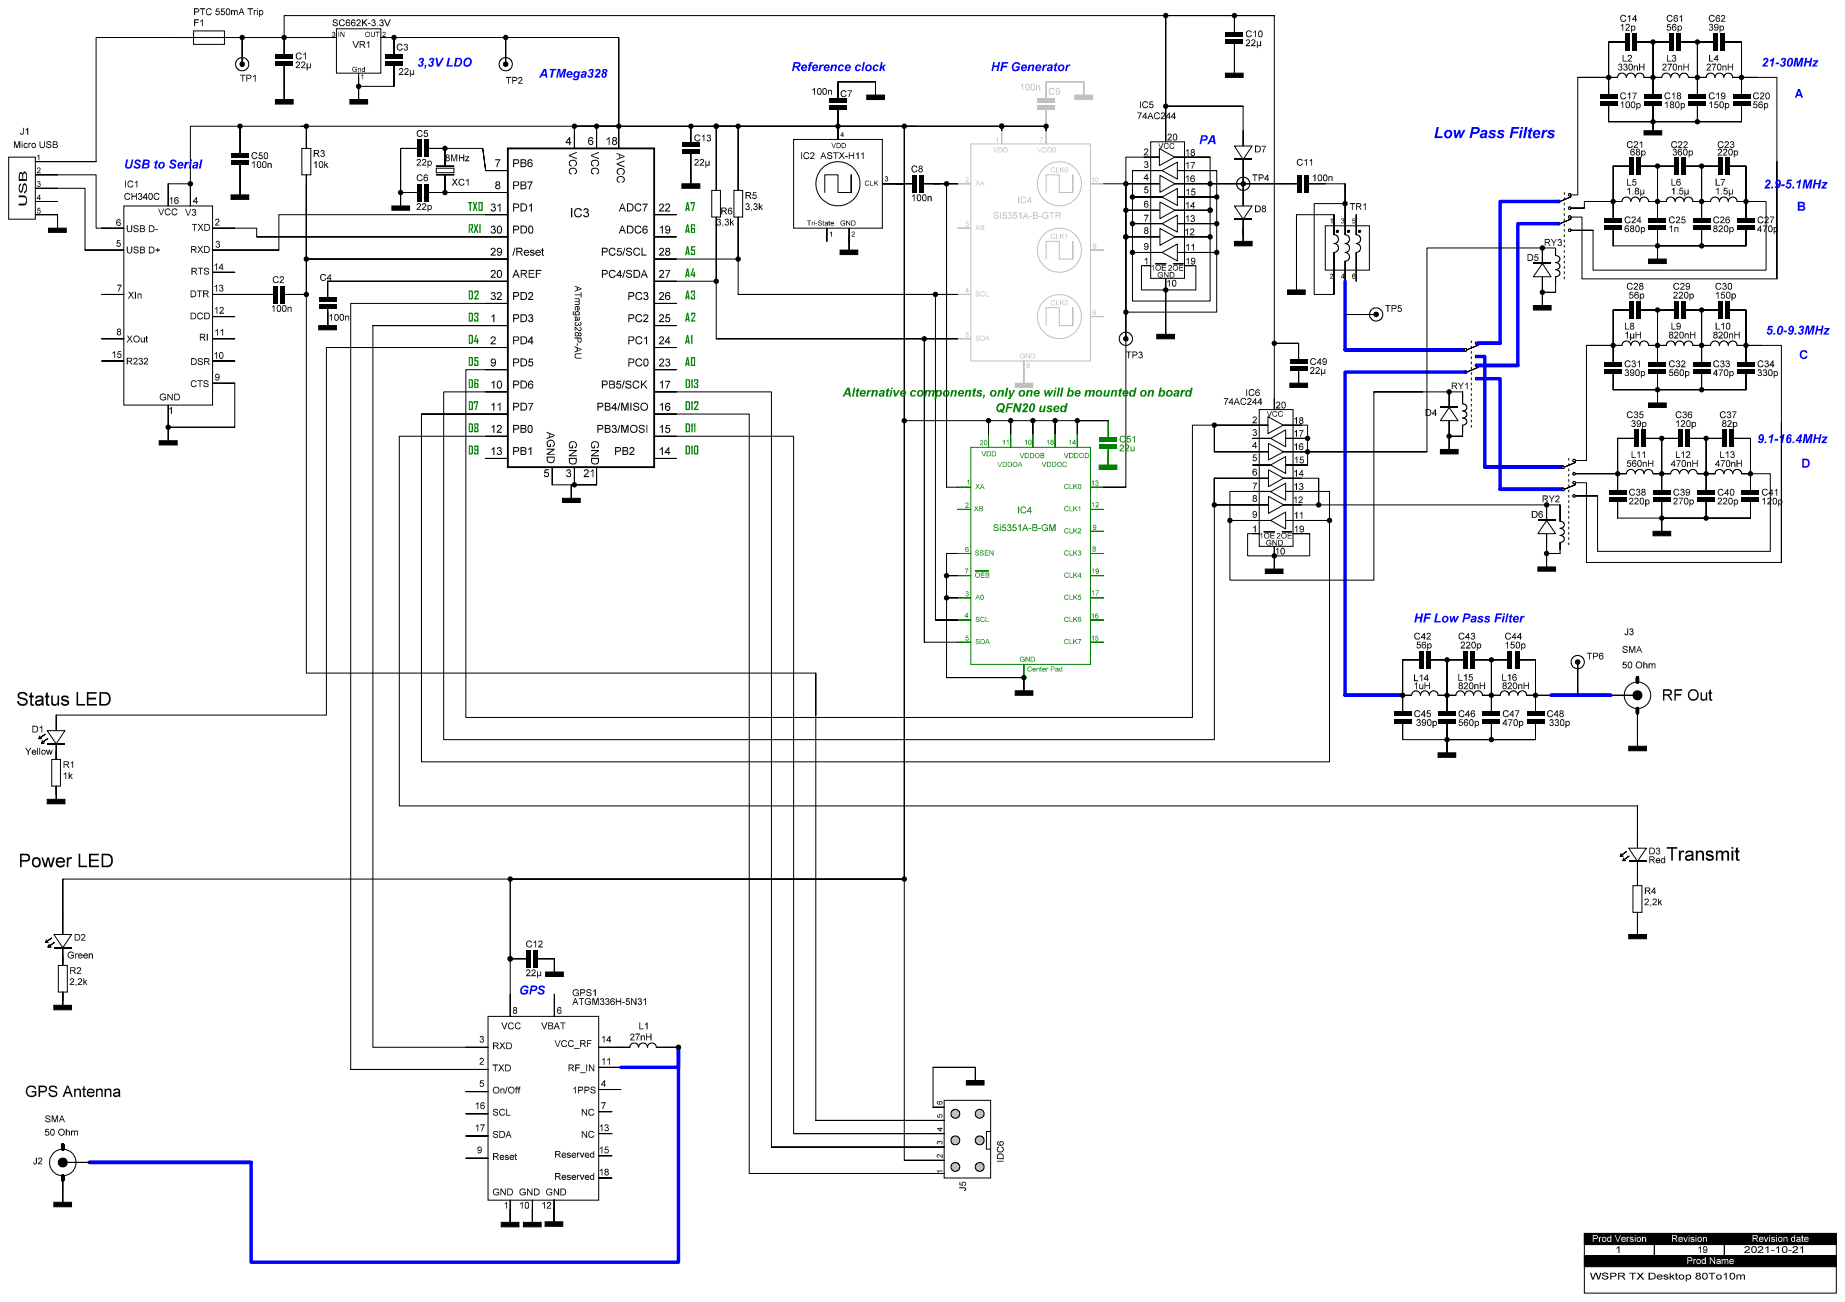
[picture p55: page 1]
