HarrydeBug/WSPR-transmitters/Documentation/1012 Schema/Hardware Version 1/V1R19-Low.pdf

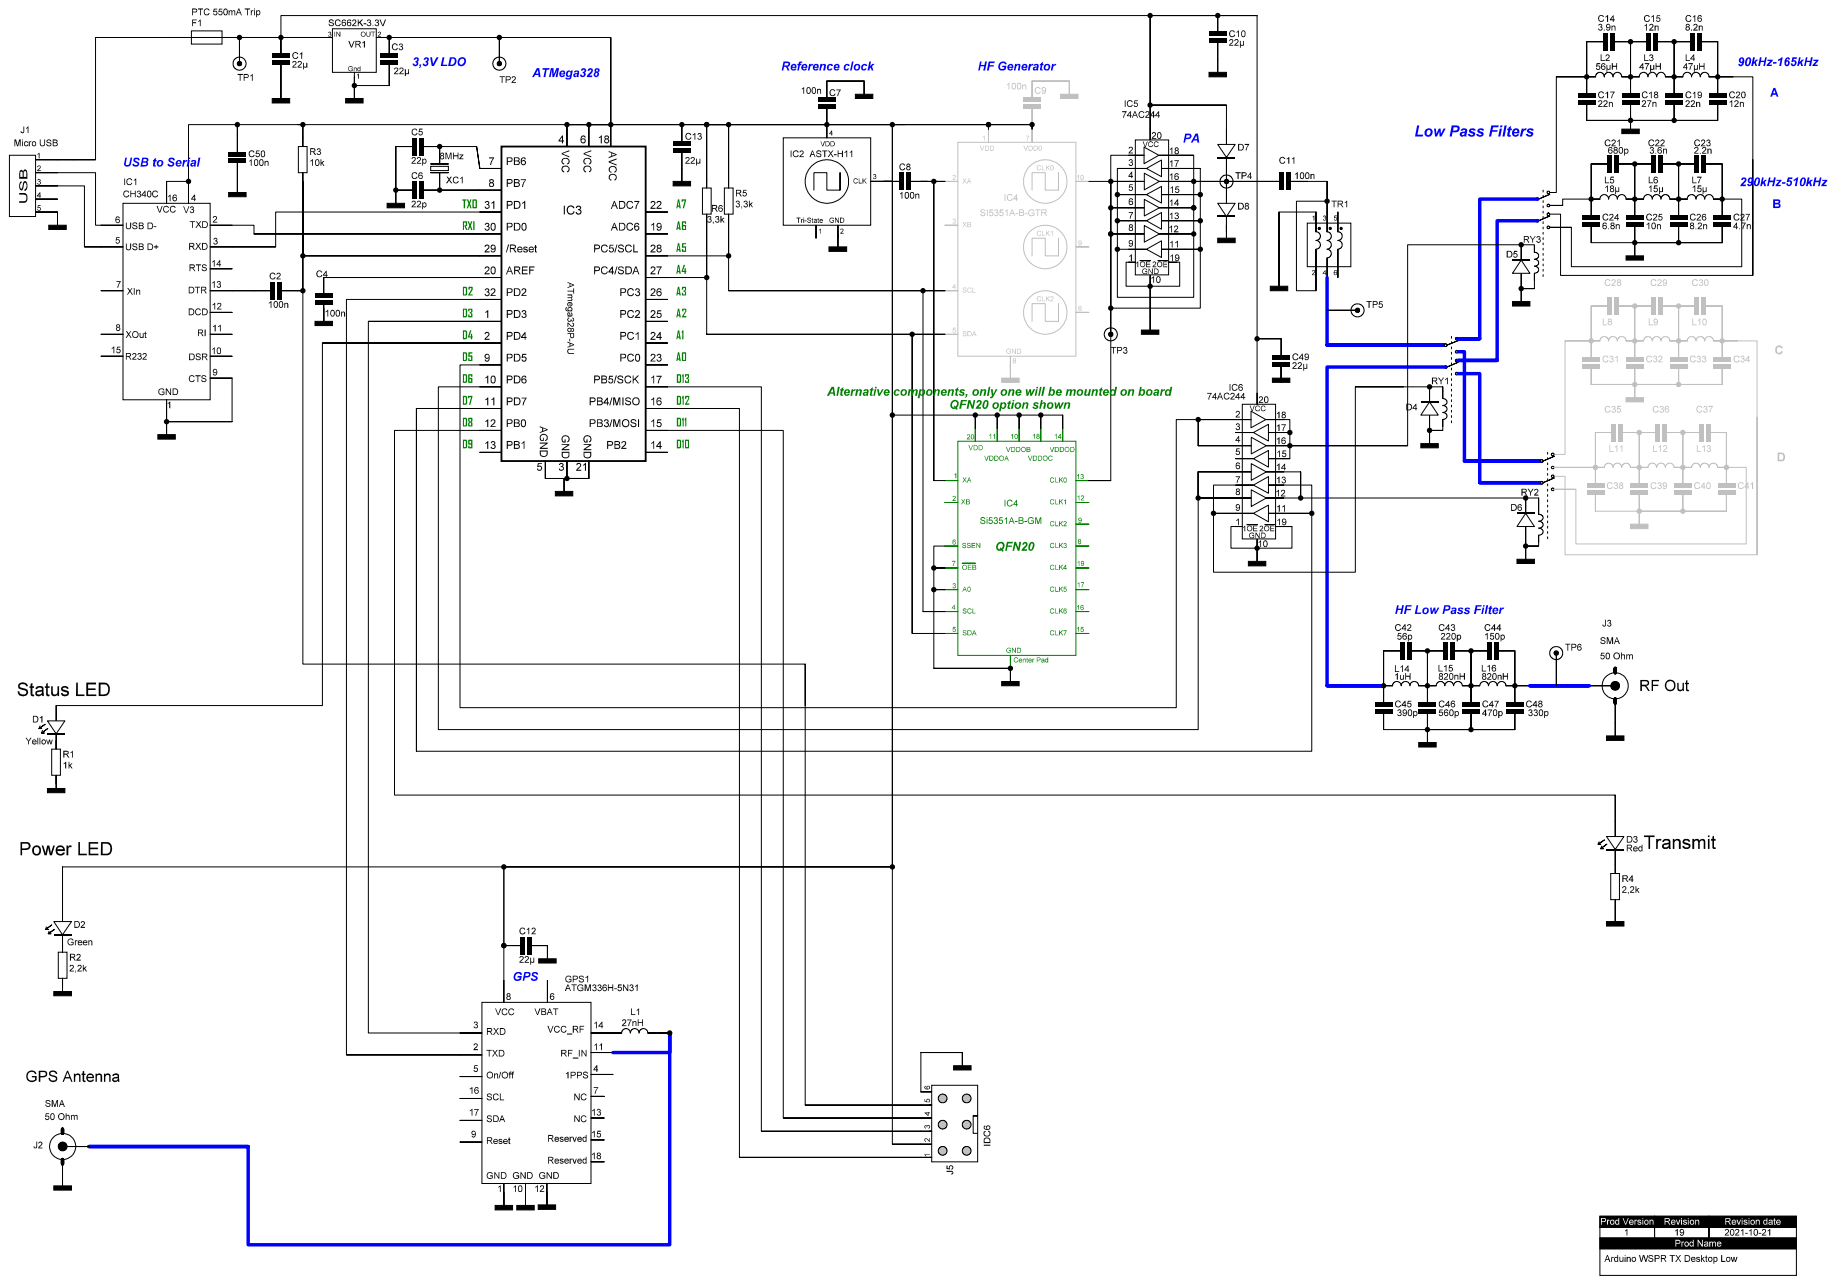
[picture p56: page 1]
