HarrydeBug/WSPR-transmitters/Documentation/1012 Schema/Hardware Version 1/V1R19-MidPlus.pdf

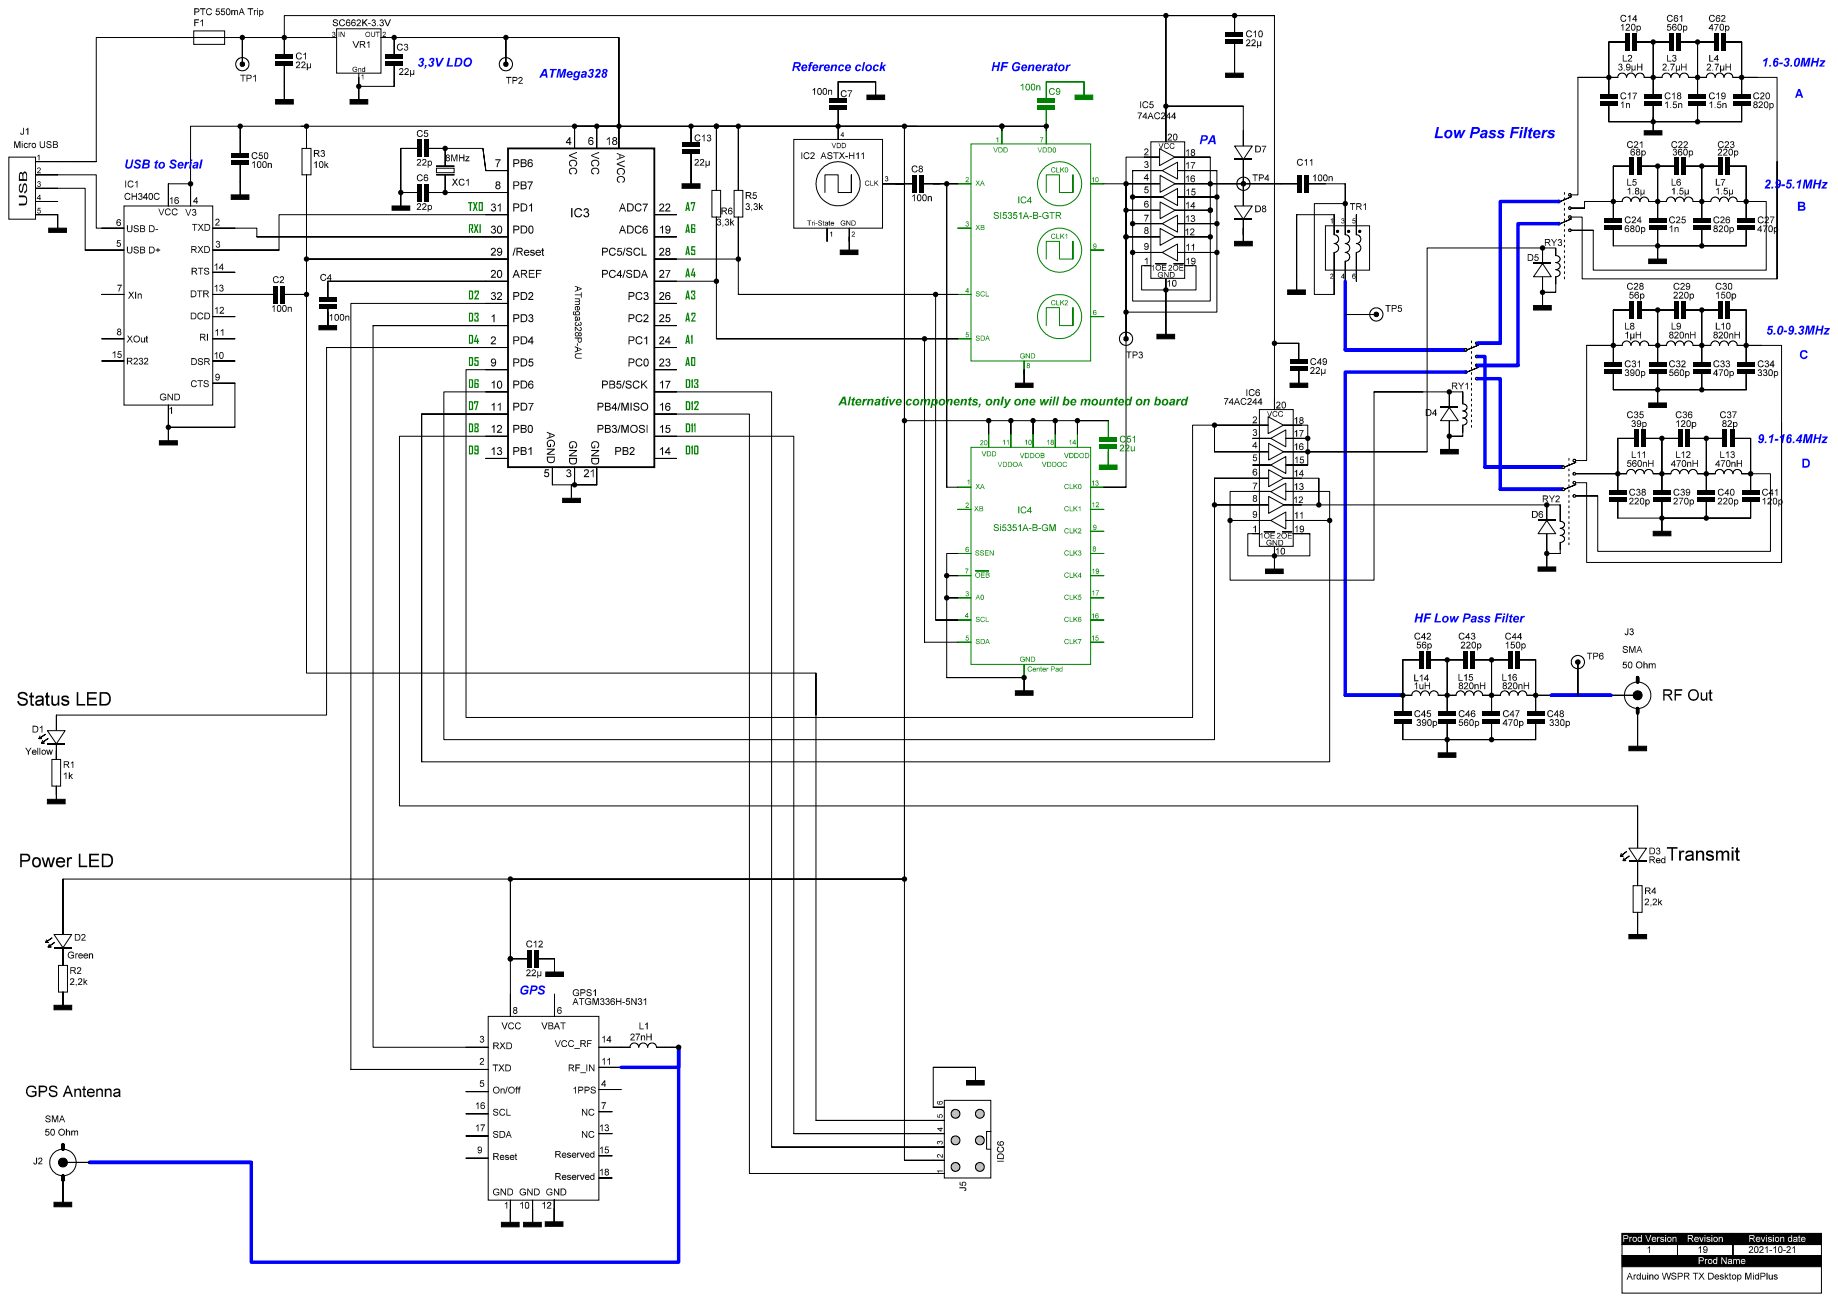
[picture p57: page 1]
