HarrydeBug/WSPR-transmitters/Documentation/1012 Schema/Hardware Version 1/V1R20-80To10.pdf

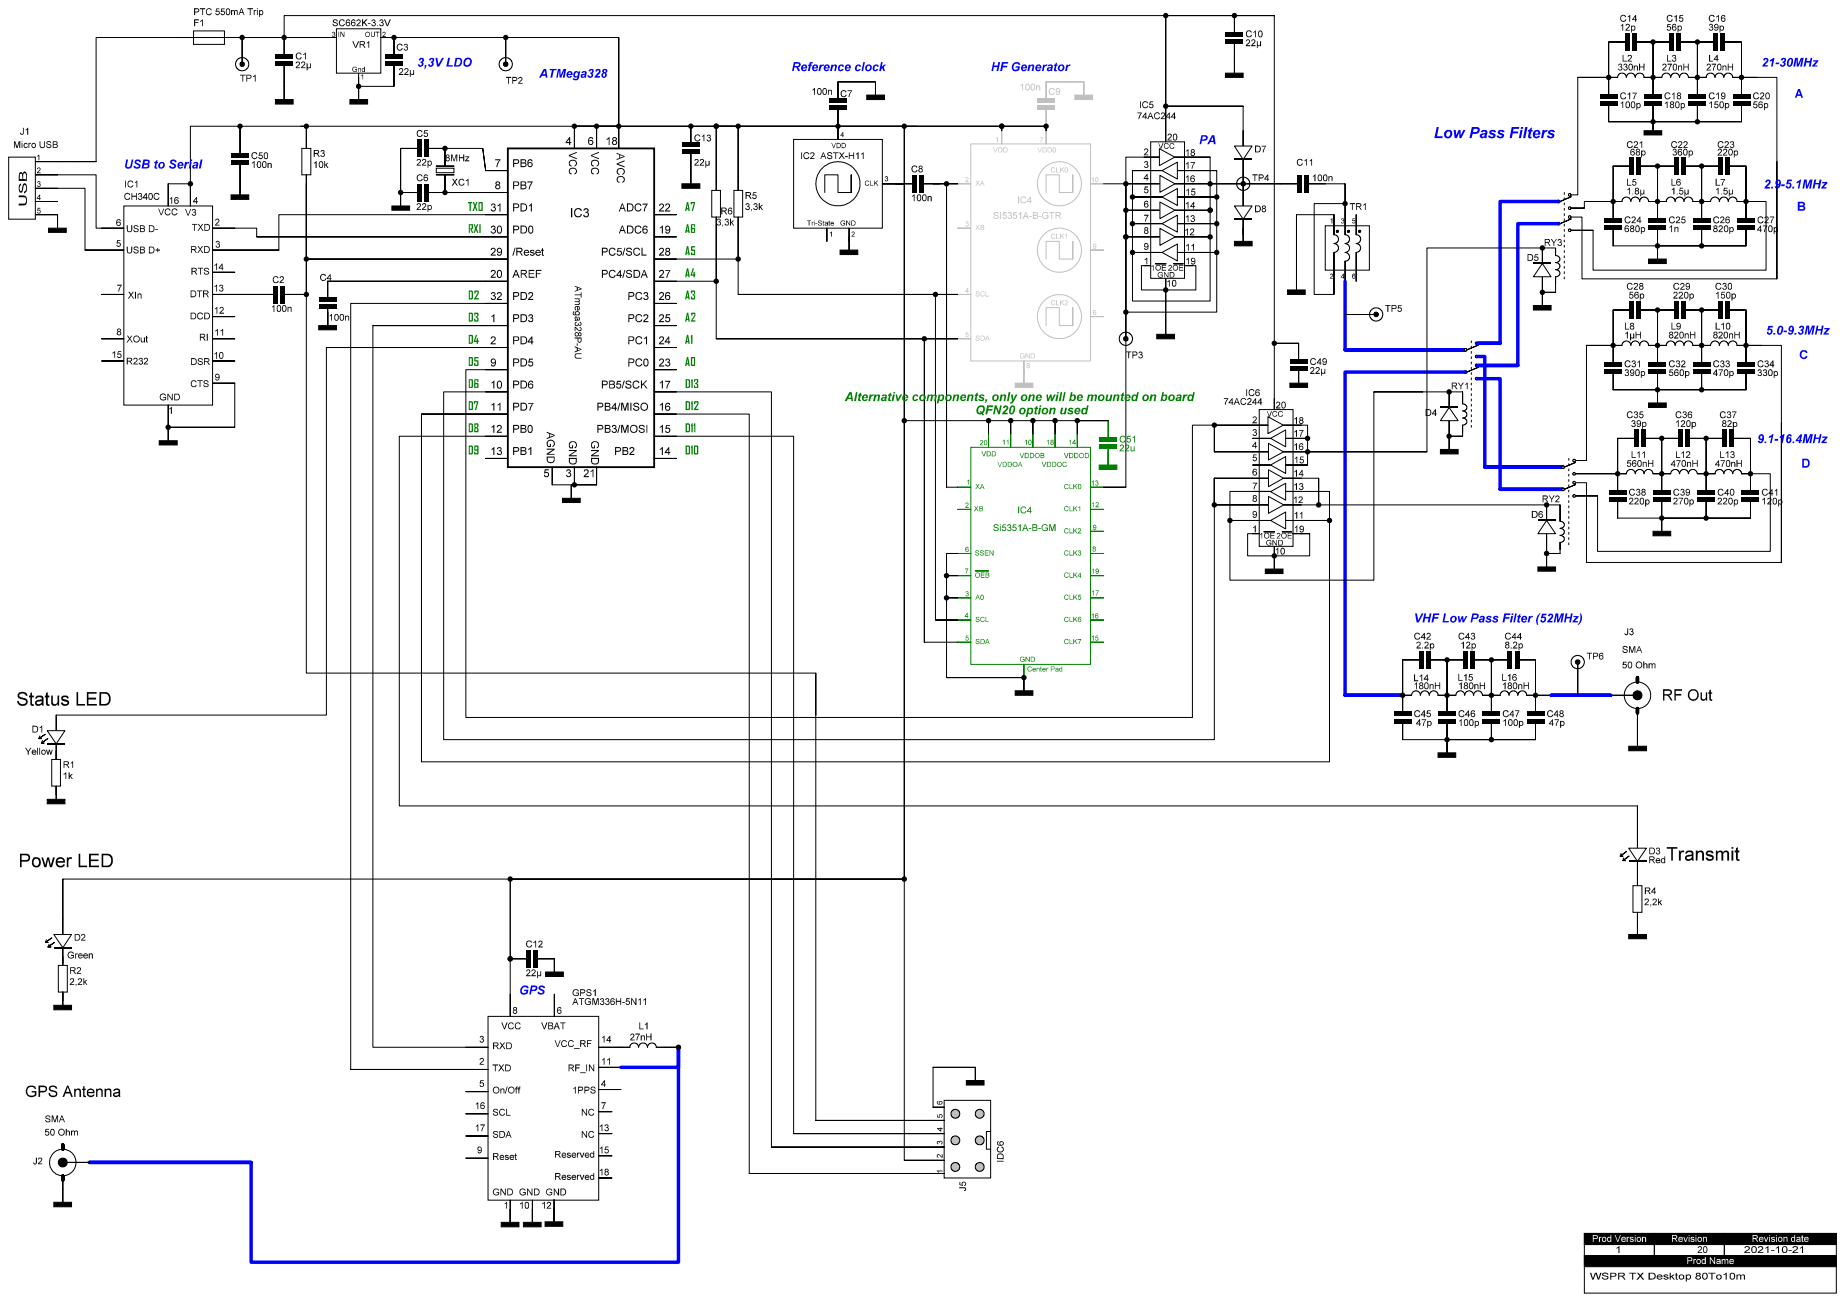
[picture p58: page 1]
