HarrydeBug/WSPR-transmitters/Documentation/1012 Schema/Hardware Version 1/V1R20-HighPlus.pdf

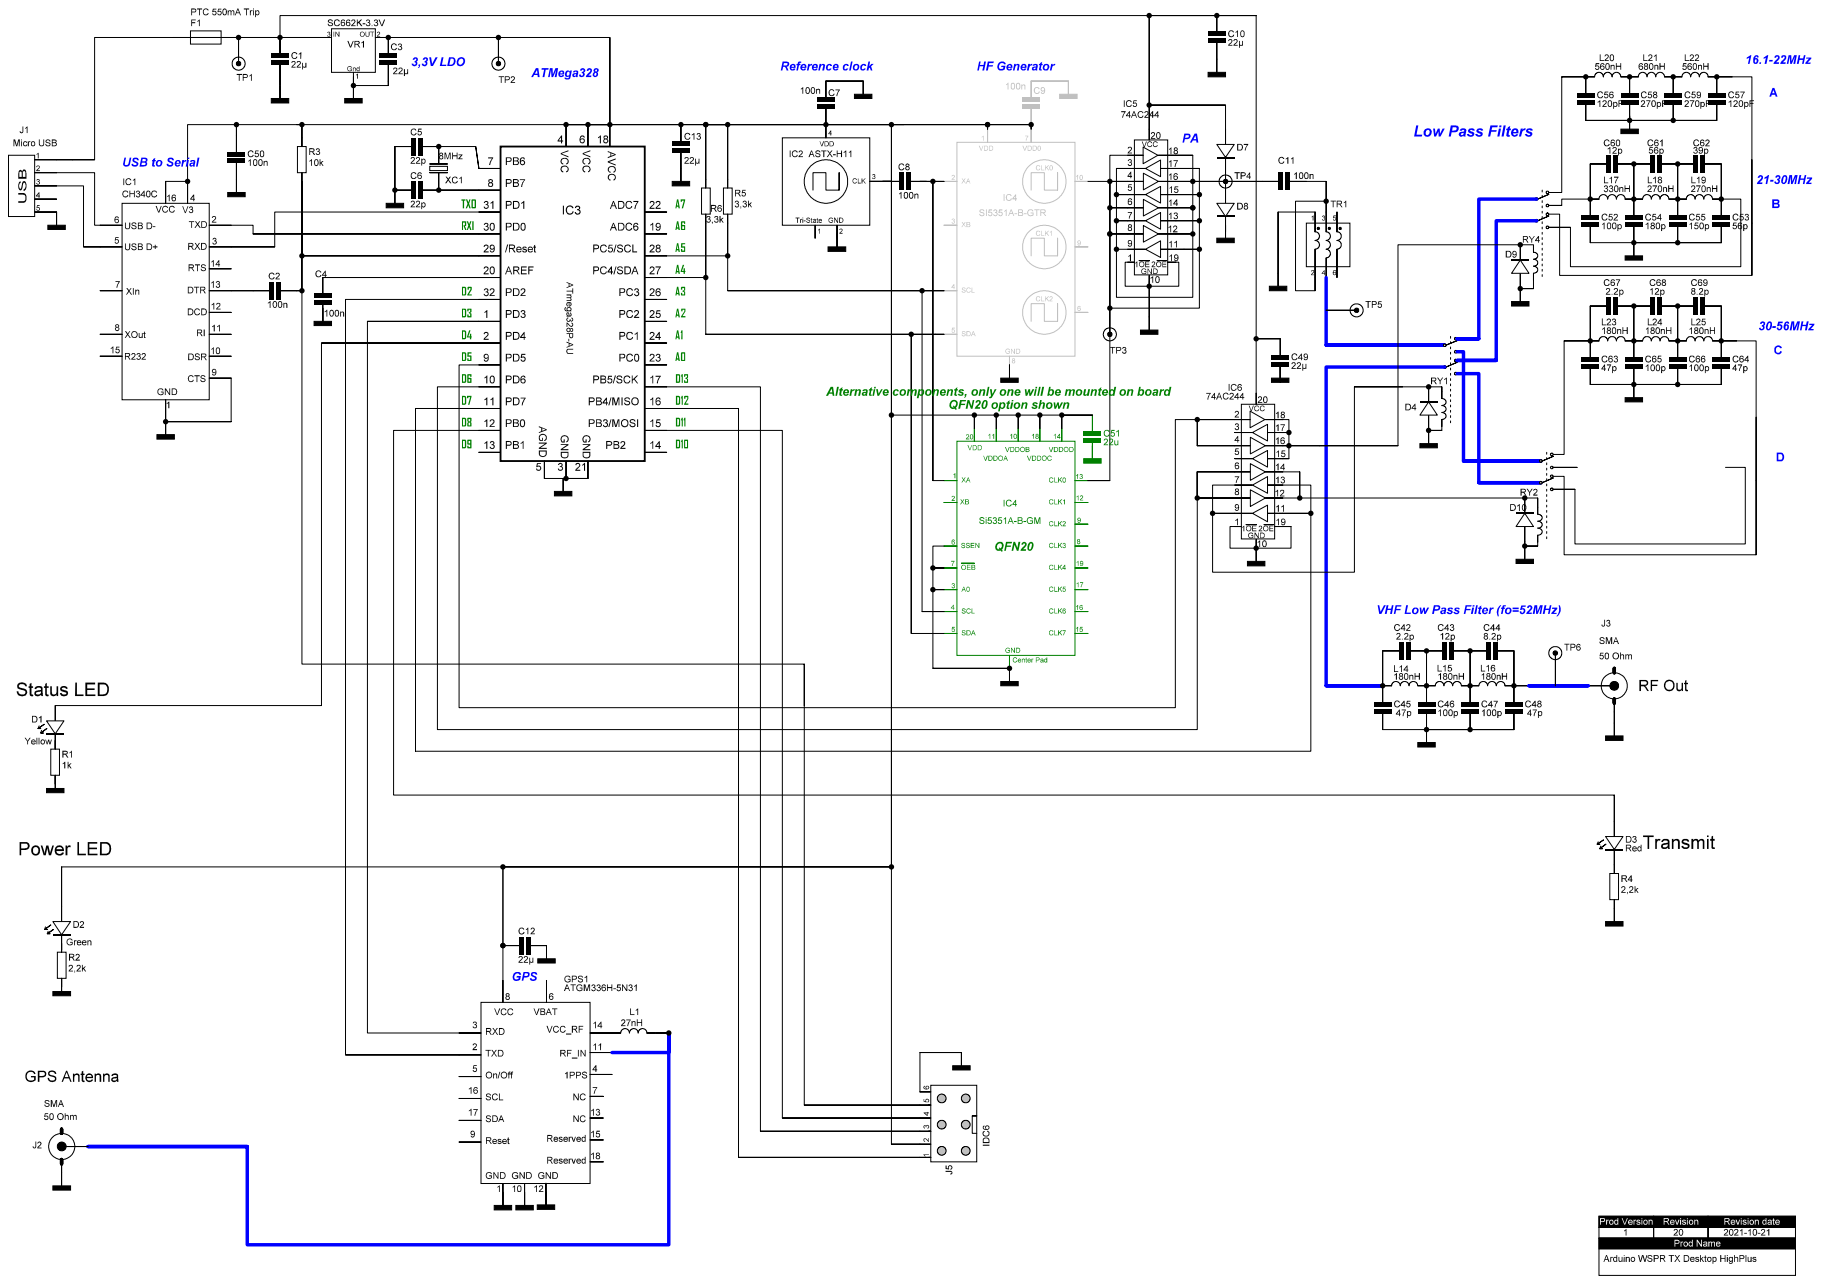
[picture p59: page 1]
