HarrydeBug/WSPR-transmitters/Documentation/1012 Schema/Hardware Version 1/V1R20-Low.pdf

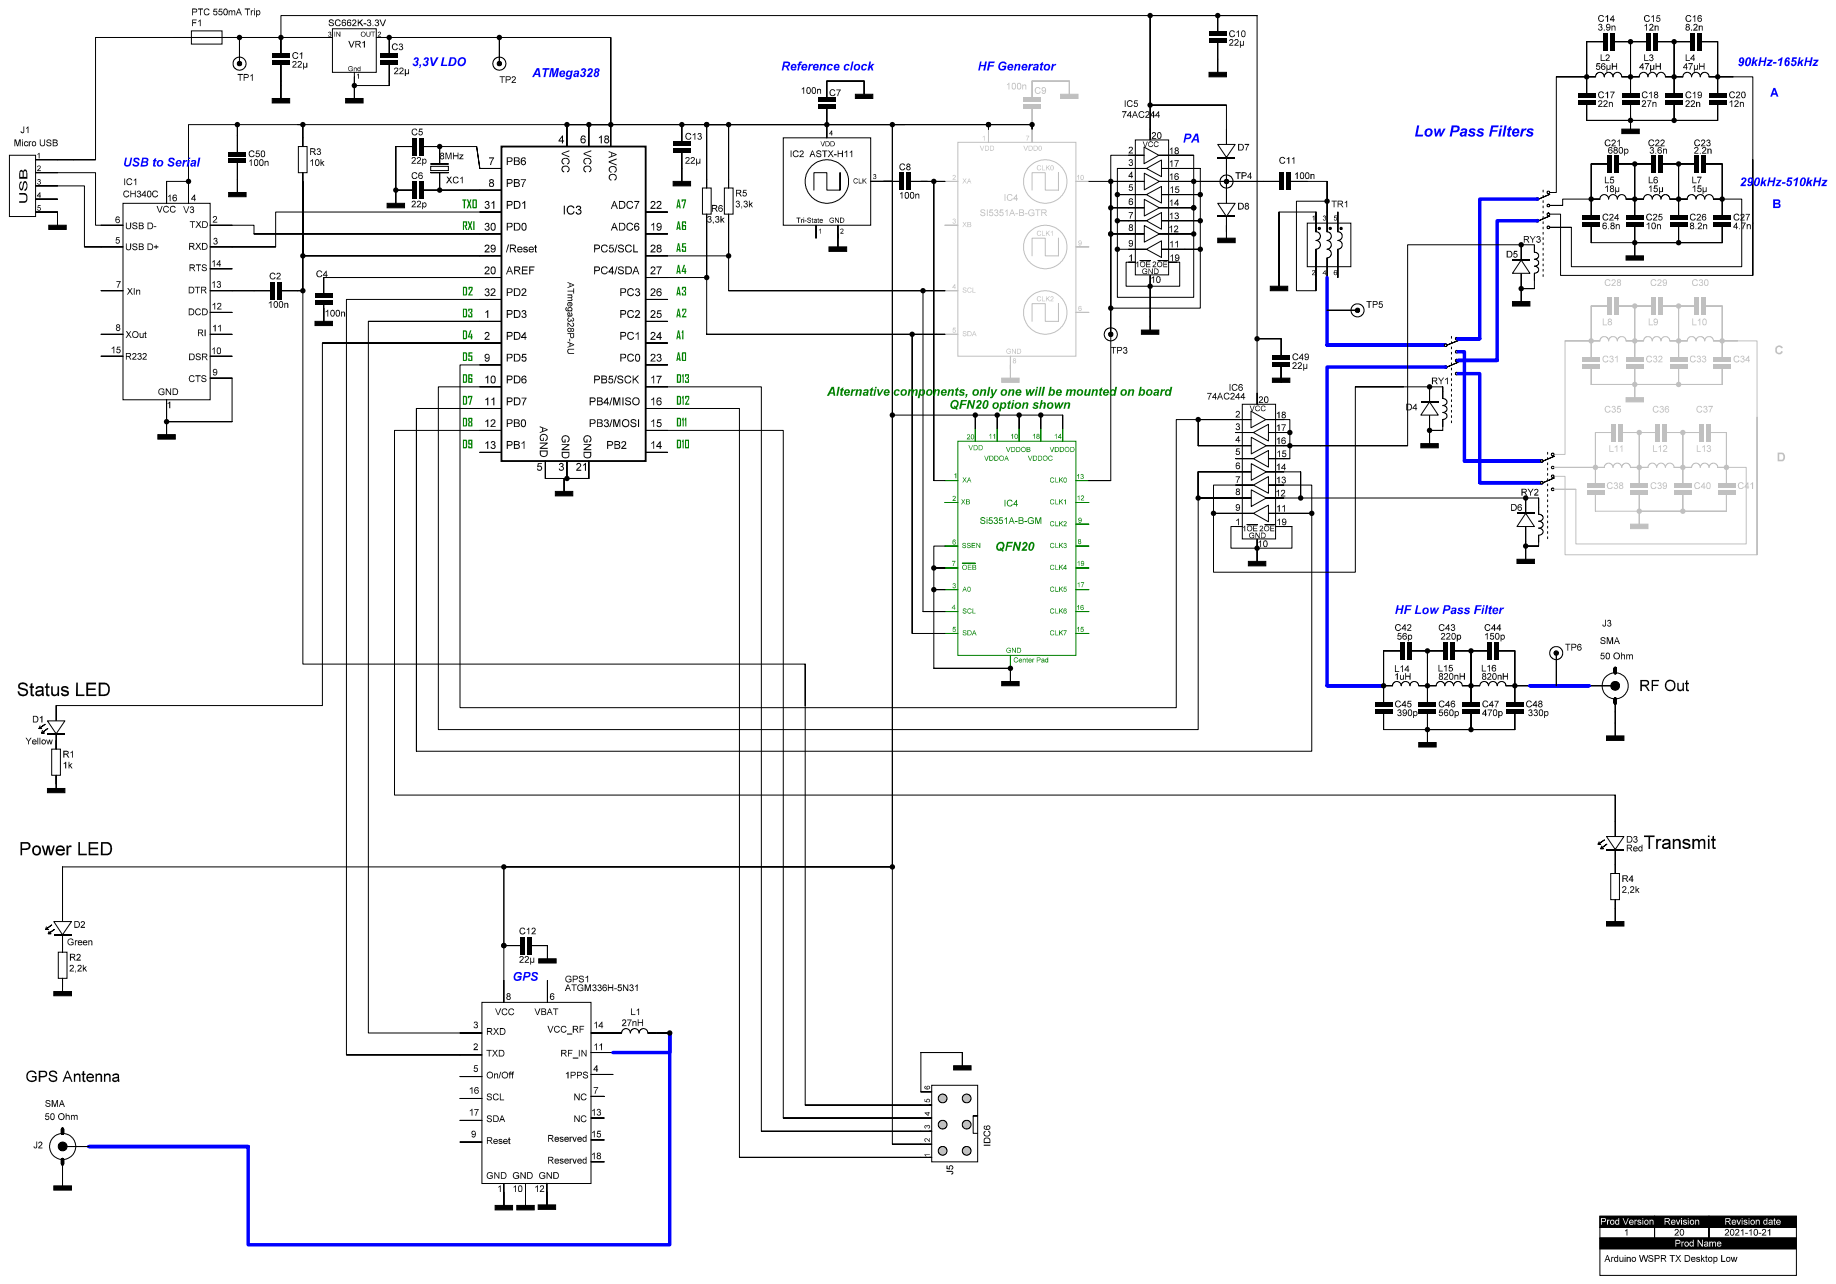
[picture p60: page 1]
