HarrydeBug/WSPR-transmitters/Documentation/1012 Schema/Hardware Version 1/V1R20-MidPlus.pdf

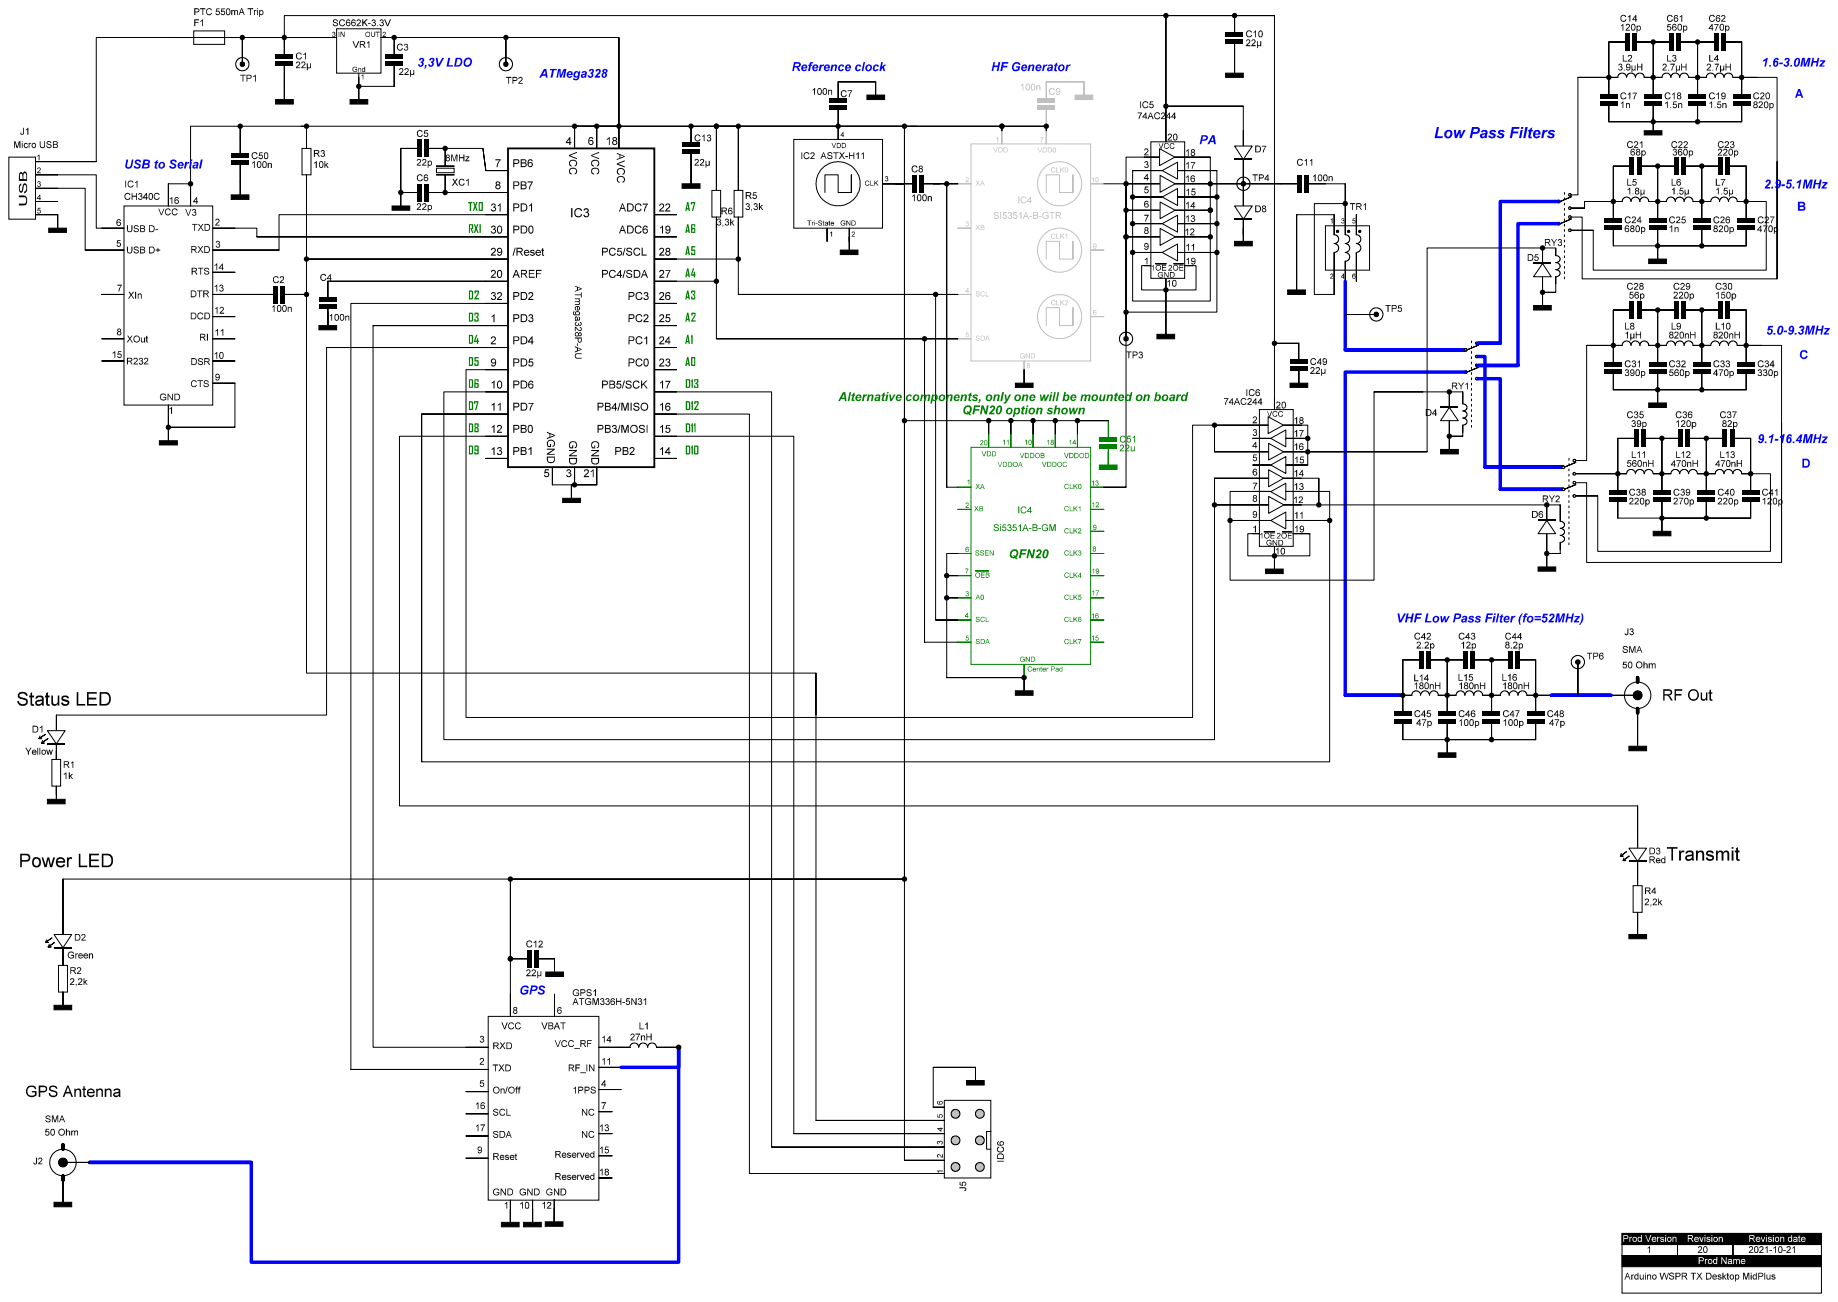
[picture p61: page 1]
