HarrydeBug/WSPR-transmitters/(commit log)

2018-07-23 Schematic for the hardware WSPR-TX_LP1 Version 1 Revision 4
2018-08-25 The first Beta for the Standard firmware
    Needs the PC program "WSPRClient_Beta0_50.exe" for configuration
    When compiling change line 212 "FactoryData.RefFreq = 26000000;" to match your TCXO frequency E.g ither 25000000 or 26000000 depending if the WSPR_LP1 board has a 25 or 26MHz TCXO fitted
2018-09-05 Beta 0.54
    1 Improved Serial port handling, program don't crash if serial port do not exist if trying to close it.
    2 Introduced a small delay when sending multiple serial queries in a row.
    This improves the ability for the Arduino to receive all the commands as it has a limited buffer and sometimes not all queries were received
2018-09-05 PC Configuration Beta 0.54
    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
2018-09-08 Add files via upload
    Factory Config sets TCXO calibration data and Hardware version and revision for a specific board.
    Need only to be run once per WSPR transmitter.
    The TCXO data and version info can be found on the PCB
2018-09-14 Sets VCXO Freq and hardware info
    Use this to set up "Factory Information" like the exact frequency of the TCXO and what hardware version the device is (says on the PCB)
    The TCXO information is used by the firmware to be on the correct transmit frequency
    The product and hardware information will be used by the PC configuration software to update the GUI.
2018-09-20 Instructions on how to upgrade the firmware using the Arduino IDE
2018-10-12 0.59 Fixed dim Red TX LED.
    0.59 Fixed dim Red TX LED, (Pin was not set to output by setup routine)
2018-10-12 0.59 Fixed dim Red TX LED
    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
    [WSPR_TX_LP1_Firmware0.59.ino]
2018-10-26 0.60 Fixed wrong TX Freq on 10,12 and 15 Band
    [WSPR_TX_LP1_Firmware0.60.ino]
2018-11-01 Description of the Serial API between the PC and the Arduino
    This API is used to control and to set/Get data in the Arduino
2018-11-08 Will configure both WSPR-TX_LP1 and WSPR Desktop products
    0.62 Added functionality to automatically use one of the Low Pass filter in WSPR and SignalGen routines (New rutines - PickLP,SetLPFilter)
    0.63 Changed Software Version and Revision to constants that can be read by the Serial API [FSV] and [FSR]
    0.64 Added function BandNumOfHigestLP to find the bandnumber of higest fitted LP filter, expanded on the PickLP filter routine
2018-11-08 Firmware for both the WSPR-TX_LP1 and the WSPR Desktop transmitter
    Please note that you need to set the "Product_Model" constant on line 36 to the correct value before compiling.
    [WSPR-TXFirmware0.63.ino]
2018-11-08 0.64 Added function BandNumOfHigestLP to find the bandnumber of higest fitted LP filter, expanded on the PickLP filter routine
2018-12-09 0.65 Fixed bug that forced Hardware Revision to 4
    [WSPR-TX0.65.ino]
2019-01-14 Added support for Mezzanine LP4 Add-on board with prod. num. 1020
2019-01-14 Added support for the Mezzanine LP4 add-on board when fitted to WSPR-TX_LP1. Use
2019-02-07 0.68 Added support for manual override relay control
    0.68 Added support for manual override relay control over the Serial API and Relay update messages. ([CSL] command and {LPI} status message, shortened Start LED Blink
    [WSPR-TX0.68.ino]
2019-02-07 Fixed problem with Arduino and PC program not in sync. Added debug option
    There is now a debug option that enables a user to send and receive raw API data . Useful when debugging new options or to manually set stuff. E.g to force the transmitter to temporary use Low pass filter B - send the command "[CSL] S B".
    I also fixed a long standing problem where the Arduino had a different view on what bands ere enabled compared to the PC.
    This led teh user to belive a certain band was enabled for TX when it was not. The PC Software now queries the Arduino for GUI updates after each band option is ticked. This slows down the GUI when clicking to enable or disable a certain band in the WSPR beacon b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
2019-04-24 Power saving in the WSPR Mini.
    0.69 Added support for hardware WSPR-TX Mini 1021, added funtion readVcc() that returs Arduino Voltage, added PowerSave funtions save current on the Mini
    0.70 Added power saving for the Mini, GPS turned off if TX pause is longer than a minute.
    0.71 Corrected 2m Frequency, not in use but nice to have correct. Enabled PLL power saving for the Mini if TX pause is longer than a minute. Current draw for mini is: 40mA waiting to TX, 60mA TX, 5mA during long TX pauses (More than a minute)
    [WSPR-TX0.71.ino]
2019-06-29 More frequent GPS updates to the PC software, Power saving improvements on the WSPR TX Mini
    0.72 Sends GPS updates when in Idle and Signal gen mode and when pausing in WSRP Beacon mode. Improved Serial port respons when pausing in WSPR Beacon mode,
    On the Mini the GPS and the Si5351 is put to power save during long TX Pauses. Current draw is now arround 40 mA regardless if tranmitting or not.
2019-07-04 Windows driver for USB chip CH340 (only needed for Windows XP)
2019-07-15 Improvement in responsiveness, Additional WSPR Mini power saving
    Improvement in GUI responsiveness when in WSPR Beacon. Additional power saving for the Mini, MCU goes to sleep if TX pause is longer than a minute.
2019-07-15 Improvement in responsiveness. Additional power savings for the WSPR Mini
    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
2019-07-15 Added voltage info from the microcontroller , some improvement in idle mode
    Added MCU VCC Voltage info, added support for Pico model, Sends less GPS info in Idle mode
2019-07-17 Added WSPR Mini Image. Only displays one LP filter option for Mini and LP1
2019-09-09 Fixed incorrect Power table
    The Power setting table has been fixed.
    Before the fix the power table was 0,3,6,10,13,16,20,23,26,30,33,36,40,43,46,50,53,56,60 witch is incorrect.
    It is now fixed and set to 0,3,7,10,13,17,20,23,27,30,33,37,40,43,47,50,53,57,60.
    Thank you goes out to Hayden VK7HH and Gary W2GNN for reporting the error.
2019-10-01 Fixed GUI bugs.
    Fixed bug that gave error messages when editing TX Pause values.
    Fixed Serial port bug when device is unplugged without first closing down teh serial port. The application now terminates when thsi happen instead of displaying an error message,
2019-10-01 Fixed GUI bugs
    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
2019-10-01 Bug fixes and support for new hardware
    0.76 Added Support for WSPR-TX Pico, GPS position updates in idle and signal gen mode, status LED now fast blink during WSPR Beacon TX instead of steady lit
    The Pico will always boot in to WSPR Beacon regardless of Boot configuration, this is a failsafe.
    Moved check if Call Sign is set from SendWSPRBlock() to DoWSPR()
    0.77 Changed around the orders of hardware check in Setup()
    0.78 The WSPR Beacon will now stay in Beacon mode even if the user changed something in the PC GUI like changed bands, click Save button etc
    0.79 Support the new Desktop V1R10 with new improved LP filters. Fixed TX Pause limit of 32000, it can now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
    [WSPR-TX0.79.ino]
2019-10-01 Version 0.79 for the WSPR TX Pico
2019-10-01 Fixed GUI bugs, see details for more info
    0.79 Support the new Desktop V1R10 with new improved LP filters. Fixed TX Pause limit of 32000, it can n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
2019-10-01 Fixed GUI bugs, see extended description
    Fixed bug when entering TX Pause values. Sometimes it gave error messages when saving or leaving the field.
    Also fixed COM port error bug that gave error message if the device was unplugged without closing the serial port. The program could then not be closed. The software now closes properly in these cases.
2019-10-01 Fixed GUI bugs, see extended description for more information.
    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
2019-10-07 Base-band version for WSPR using Lasers
2019-10-11 Altitude coding in Power field. For WSPR TX Pico
2019-10-11 Altitude coding in Power field. For WSPR TX Pico
2019-10-11 Prototype. PCB Version1 Rev2
2019-12-31 0.81 Added Altitude encoding in the power field option
2019-12-31 New features for Altitude coding and GPS satellite information.
    A new visual toot to view the GPS satellites over the horizon has been added.
    Support for the Altitude coding in the power field has been added, requires firmware 0.81 in the transmitter.
2020-01-04 Version 0.82
    0.79 Support the new Desktop V1R10 with new improved LP filters. Fixed TX Pause limit of 32000, it can now go to 99999 seconds (27.7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
2020-01-04 Added Progress bars for the WSPR Beacon and new Information buttons.
2020-01-08 Added Progress bars for the WSPR Beacon. Added mouse-over hints and info buttons.
2020-01-13 Fixed so the WSPR Mini is not put to sleep during long TXPauses to save power if the PC is connected.
    [WSPR-TX0.83.ino]
2020-01-24 Fixed Pico GPS Sleep functions so the GPS would restart properly in brown-out conditions
    0.84 Fixed Pico GPS Sleep functions so the GPS would restart properly in brown-out conditions.
    Fixed so WSPR beacon goes back again after Serial API command is handled
    (A bug made the beacon go back only after a GPS fix, now goes back immediately even if no GPS fix)
2020-01-24 Picos combined 20m and 30m lowpass filter correctly reported to PC program
    0.85 Picos combined 20m and 30m lowpass filter correctly reported to PC program,
    An unresponsive GPS will be reset after some time in the idle routine
    [WSPR-TX0.85.ino]
2020-01-26 Added support for WSPR-TX Pico
2020-01-26 Hex file for the WSPR-TX Pico Firmware version 0.85
2020-02-13 0.86 Improved the paus timing accuracy when the Mini or Pico is sleeping during long TX Pauses
2020-03-01 0.86 for WSPR-TX Mini
    0.86 Improved the paus timing accuracy when the Mini or Pico is sleeping during long TX Pauses
2020-03-10 Version 0.87 for the WSPR-TX Pico
2020-06-07 SPECIAL VERSION FOR EXTERNAL FREQUENCY DIVISION
    This is a special experimental version that requires an external divider on the output.
    This can be useful in the following two scenarios:
    1 For generating baseband WSPR e.g 1500Hz for direct input to microphone input on a transmitter or for modulating a laser.
    2 For users with special amplifiers on LF and MF that divides the signal by two as part of the switched amplifier.
    The division rate is configurable with the constant ExtDivision
    In WSPR Beacon mode the band settings will be used but the output frequency will always be multiplied by the ExtDivision
    The WSPR symbol shift is also multiplied so instead of the normal shif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
2020-07-21 Removed dependency on JTencode library
    0.89 Fixed a bug that indicated 10-pole low pass filters for LP1 instead of the standard 7-pole in the DecodeSerialCMD routine.
    0.90 Removed dependency on JTencode library by copying the needed code.
    [WSPR-TX0.90.ino]
2020-08-13 Add files via upload
    For WSPR TX Pico. Will not transmit when in these grids: IO78 IO88 IO77 IO87 IO76 IO86 IO75 IO85 IO84 IO94 IO83 IO93 IO82 IO92 JO02 IO81 IO91 JO01 IO70 IO80 IO90 IO64 PN31 PN41 PN20 PN30 PN40 PM29 PM39 PM28 PM38 LK16 LK15 LK14 LK13 LK23 LK24 LK25 LK26 LK36 LK35 LK34 LK33 LK44 LK45 LK46 LK47 LK48 LK58 LK57 LK56 LK55";
    = UK, North Korea, or Yemen.
    GeoFence code and grids by Matt Downs
2020-08-14 Geo-Fencing for the Pico, will not transmit over restricted parts of the word
2020-09-30 HEX file for WSPR-TX Pico with Reverse band ordering
2020-12-15 Switches between the band in random instead of sequential order
2020-12-15 GPS reset implemented for LP1 and Desktop models if their GPS fails to get a fix.
    [WSPR-TX0.94.ino]
2021-04-19 Bugfixes on GPS and for the Mini, see details
    0.93 Modified GPSWakeUp routine to reset GPS on all models when waking up from sleep
    0.94 Fixed bug that cased GPS reset after each transmission
    0.95 WSPR Mini re-added after it had been removed by accident in an earlier version
    [WSPR-TX0.95.ino]
2021-04-19 0.95 for Si5351 with I2C adress 0x62
    This version is for a special version Si5351 with a different hardware address.
2021-05-16 V1.0 Added Type 3 transmissions . Auto-detect I2CAddress
    Type 3 transmissions gives increased position precision with six letter Maidenhead position reports, also gives better altitude precision in case altitude is encoded in the pwr field. In that case first transmission converts altitude to power by diving the altitude in meter by 300 and round down to closest defined power. The second transmission takes the remainder and converts it to pwr by dividing by 20.
    At the receive side the conversion is by taking the pwr in dBm and multiplying with 300 and adding the next message pwr in dBm * 20
2021-06-18 Support for the new 80To10m model
    1.1 Desktop model with 10m filter installed now indicates it can do 17m as swell besides the 12m and 15m
2021-08-03 Scheduled transmissions for the Pico ballon transmitter
    Use this firmware if you want to get properly decoded altitude transmissionz on the Webpage http://lu7aa.org.ar/wsprcall.asp
2021-08-29 Bug fixes in serial data handling.
    Fixes Serial port input corruption and "lock-ups"
    Fixed GPS Time corrupted characters when the GPS time was 00:00:00
    Tuned how fast the Transmitter can be queried for all the data.
    Added a progress bar that shows the query for all the info
    Added a button to trigger a re-read of all data that used to only happen when the Serial port was first opened.
    Removed extra linefeeds in the Information fields
2021-09-15 Bug fix for negative altitudes.
    Fixed bug that cased incorrect results if the altitude is negative and the option "Encode Altitude as power" is used
2021-09-15 Bug fix for devices with Firmware 1.10
    Changed the initial query to better work with devices with Firmware 1.10 or higher.
2021-10-21 WSPR Desktop transmitter Schematics
2022-01-11 WSPR LP1 Transmitter Schematics
2022-09-04 Small changes in the Restart and ReRead buttons
2022-09-04 Auto detects the I2C address on the Si5351.
    Removed dependency on EtherKit Si5351 library and instead used Hans Summers Demo code for si5351 control.
    This makes it possible to use my code for auto detection of I2C address on the Si5351.
2022-09-04 WSPR Desktop transmitter Schematic
2024-05-13 Slight indicator bugfix for XP Plus with BLP80To10 board
    A fix so a WSPR-TX XP Plus with a BLP80To10 Mezzanine board would properly indicate all the bands it could filter in the PC configuration software
